a-conspiracy-theory/jhnvrw-seniordesign/README.md

UCF 2026 Senior Design Project

RF Energy Harvesting Ultra-Low-power Transceiver for Environmental Sensing
