a-conspiracy-theory/jhnvrw-seniordesign/hardware/tx-pcb/reference-designs/swrr077/readme.txt

XXXXXXXXXXXXXXXXXXXXXXXXXXXXXXXXXXXXXXXXXXXXXXXXXXXXXXXXXXXXXXXXXXXXXXXXXXXXXXXXX
X   Artwork and documentation done by: Texas Instruments Norway AS              X
X   Company: Texas Instruments Norway AS                                        X
X   Address: Gaustadalléen 21    0349 OSLO                                      X
X                                                                               X
X                                                                               X
XXXXXXXXXXXXXXXXXXXXXXXXXXXXXXXXXXXXXXXXXXXXXXXXXXXXXXXXXXXXXXXXXXXXXXXXXXXXXXXXX

PROJECT : 025103
PCB NAME : CC1101-CC1190EM 915MHz
REVISION: 1.2.0
DATE: 2011-03-10
QUANTITY:   See order (in panel)

Manufacturers marking: Two letter + year + week
The two letter code shall identify the manufaturer and is decided by the manufacturer. 
No logos or other identifiers are allowed.
The marking shall be in silk screen print at secondary side of the PCB, or in solder 
resist if no silk print at secondary side.

FILE: CC1101-CC1190EM_915MHz_1_2_0.ZIP PACKED WITH WinZIP 

PCB DESCRIPTION:4 LAYER PCB 1.6 MM
      Copper        1   35 um
      Dielectric  1-2   0.25 mm  
      Copper        2   18 um
      Dielectric  2-3   0.96 mm 
      Copper        3   18 um
      Dielectric  3-4   0.25 mm 
      Copper        4   35 um
  DE104iML or equivalent substrate (Resin contents around 45%, which gives Er=4.42@2.4GHz, TanD=0.016)
  Dimensions in mil (0.001 inch)
  DOUBLE SIDE SOLDER MASK,
  DOUBLE SIDE SILKSCREEN,
  8 MIL MIN TRACE WIDTH AND 6 MIL MIN ISOLATION.

FILE NAME            		DESCRIPTION                               	FILE TYPE
-------------------------------------------------------------------------------------------
***PCB MANUFACTURING FILES:
l1.SPL                  LAYER 1 COMPONENT SIDE/POSITIV            		EXT. GERBER
l2.SPL                  LAYER 2 Inner layer/POSITIV                 	EXT. GERBER
l3.SPL                  LAYER 3 Inner layer/POSITIV                 	EXT. GERBER
l4.SPL                  LAYER 4 SOLDER SIDE/POSITIV                 	EXT. GERBER

STOPCOMP.SPL           SOLDER MASK COMPONENT SIDE/NEGATIVE         		EXT. GERBER
STOPSOLD.SPL            SOLDER MASK SOLDER SIDE/NEGATIVE            	EXT. GERBER

SILKCOMP.SPL            SILKSCREEN COMPONENT SIDE/POSITIVE          	EXT. GERBER
SILKSOLD.SPL             SILKSCREEN SOLDER SIDE/POSITIVE             	EXT. GERBER

PASTCOMP.SPL            SOLDER PAST COMPONENT SIDE/POSITIVE        		EXT. GERBER
PATSOLD.SPL              SOLDER PAST SOLDER SIDE/POSITIVE            	EXT. GERBER

ASSYCOMP.SPL            ASSEMBLY DRAWING COMPONENT SIDE/NEGATIVE    	EXT. GERBER
ASSYSOLD.SPL             ASSEMBLY DRAWING SOLDER SIDE/NEGATIVE       	EXT. GERBER

NCDRILL.SPL             NC DRILL THROUGH HOLE                       	EXCELLON
DRILL.SPL                DRILL/MECHANICAL DRAWING                    	EXT. GERBER

GERBER.REP              DRILL/NC DRILL REPORT                       	ASCII

P&PCOMP.REP             PICK AND PLACE FILE COMPONENT SIDE          	ASCII
P&PSOLD.REP             PICK AND PLACE FILE SOLDER SIDE             	ASCII

EXT_GERBER.USR          EXTENDED GERBER APERTURE TABLE              	ASCII
CNC.USR                        NC DRILL DEVICE FILE                   ASCII

CC1101_CC1190EM_915MHz_PARTLIST_1_2_0.xls			Partlist

***PDF FILES:
CC1101_CC1190EM_915MHz_SCHEMATIC_1_2_0.PDF			Circuit Diagram
CC1101_CC1190EM_915MHz_LAYOUT_1_2_0.PDF					Layout Diagram

***CADSTAR FILES:
CC1101_CC1190EM_915MHz_1_2_0.SCM				Cadstar Schematic file
CC1101_CC1190EM_915MHz_1_2_0.CSA				Cadstar Shematic archive
CC1101_CC1190EM_915MHz_1_2_0.PCB				Cadstar layout file
CC1101_CC1190EM_915MHz_1_2_0.CPA				Cadstar PCB archive

README.TXT              THIS FILE                                   		ASCII

***REVISION HISTORY
1.2.0	First official release

END.
