a-conspiracy-theory/jhnvrw-seniordesign/hardware/rx-pcb/bluetooth_test/hardware-requirements.txt

MCU
	Bluetooth
		SMPS
		HSE
		LSE
		Antenna
	
	Harvesting Antenna
