a-conspiracy-theory/jhnvrw-seniordesign/diagrams/SD hardware block diagram RX.png

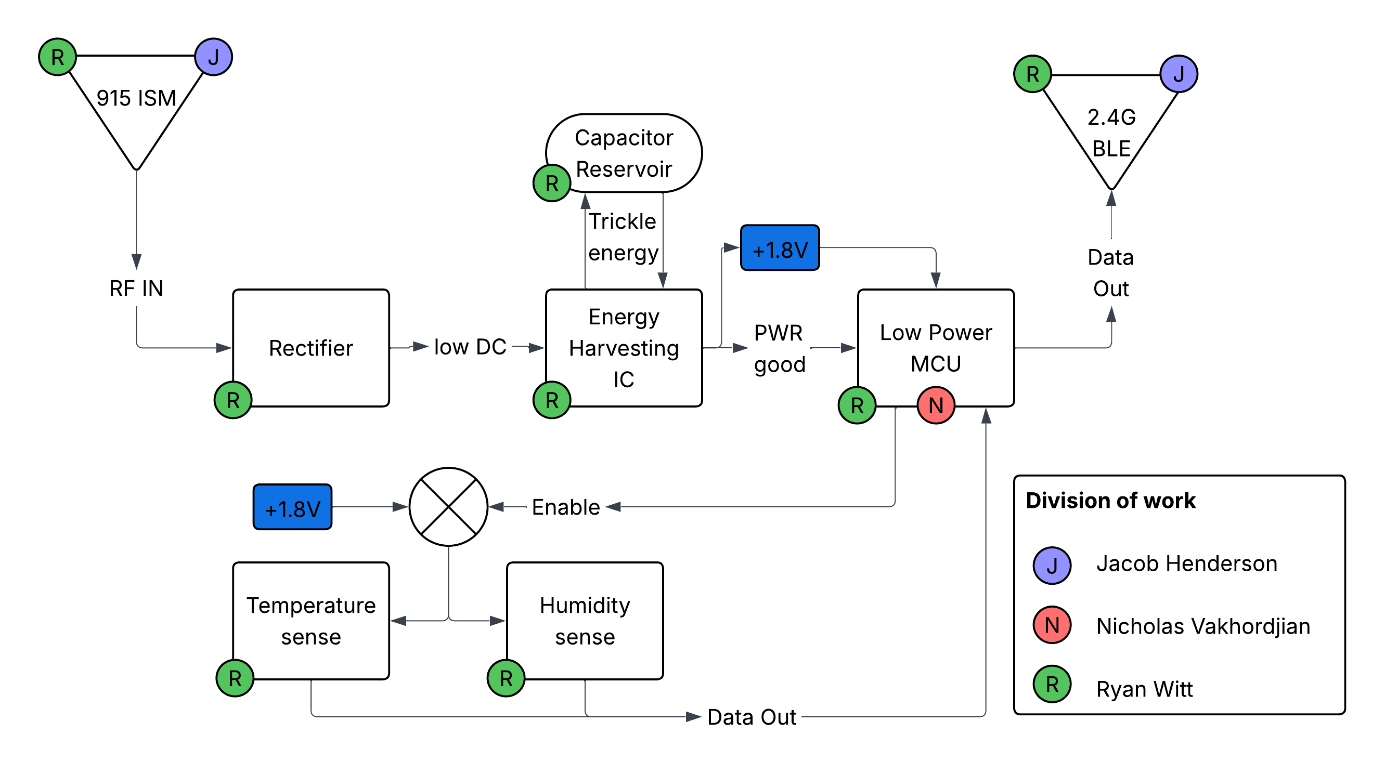
diagrams/SD hardware block diagram RX.png
