a-conspiracy-theory/jhnvrw-seniordesign/diagrams/SD hardware block diagram TX.jpeg

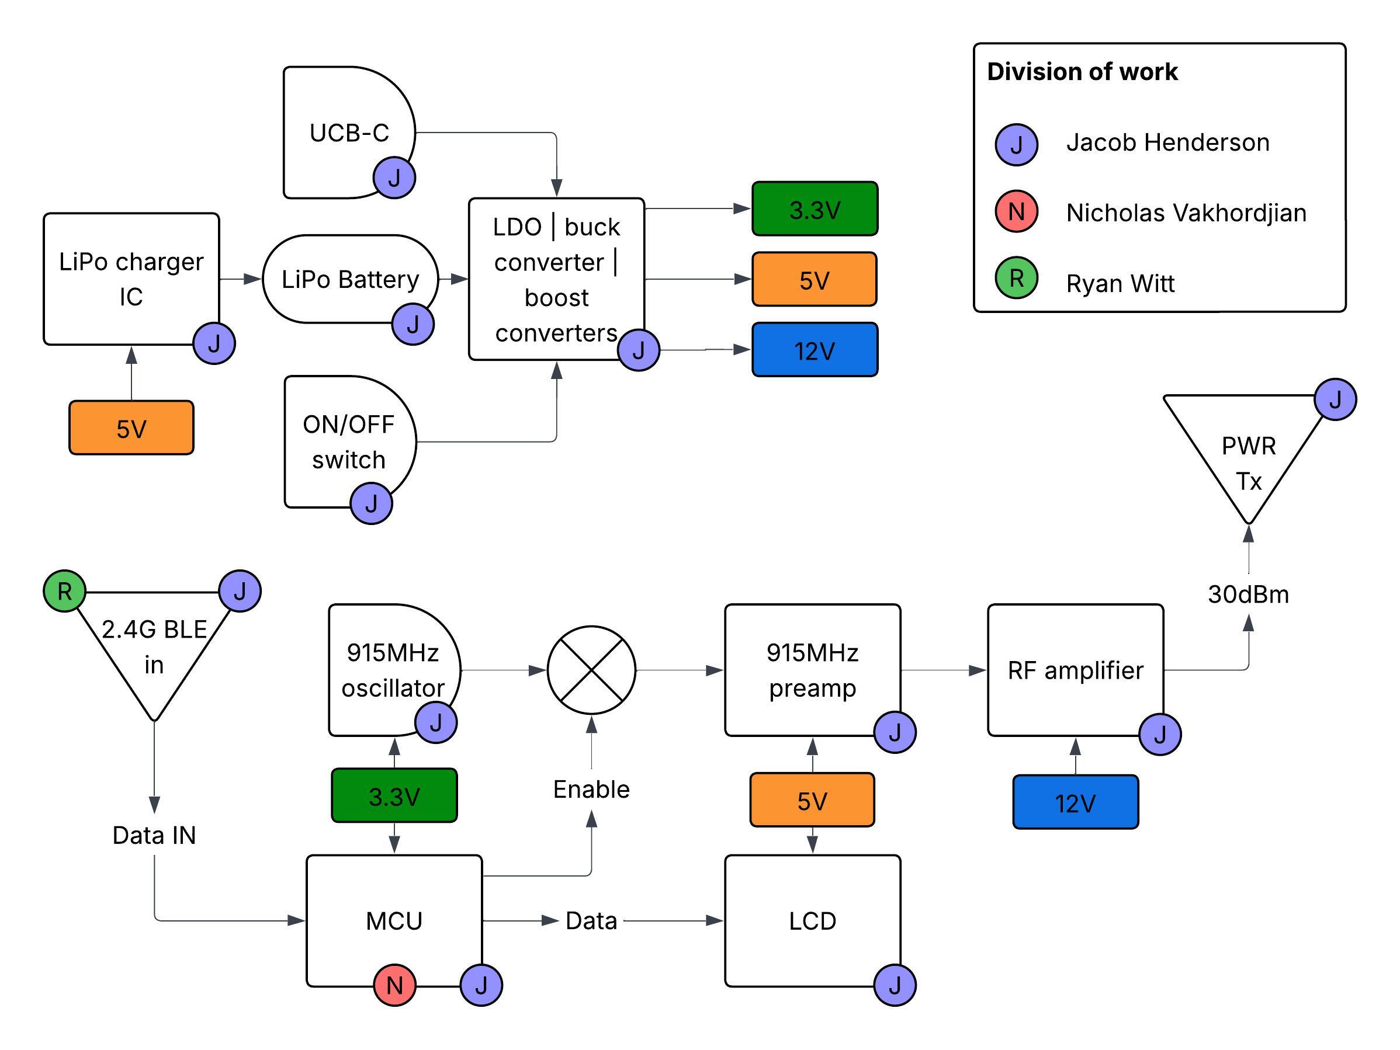
diagrams/SD hardware block diagram TX.jpeg
