a-conspiracy-theory/jhnvrw-seniordesign/diagrams/SD hardware block diagram TX.png

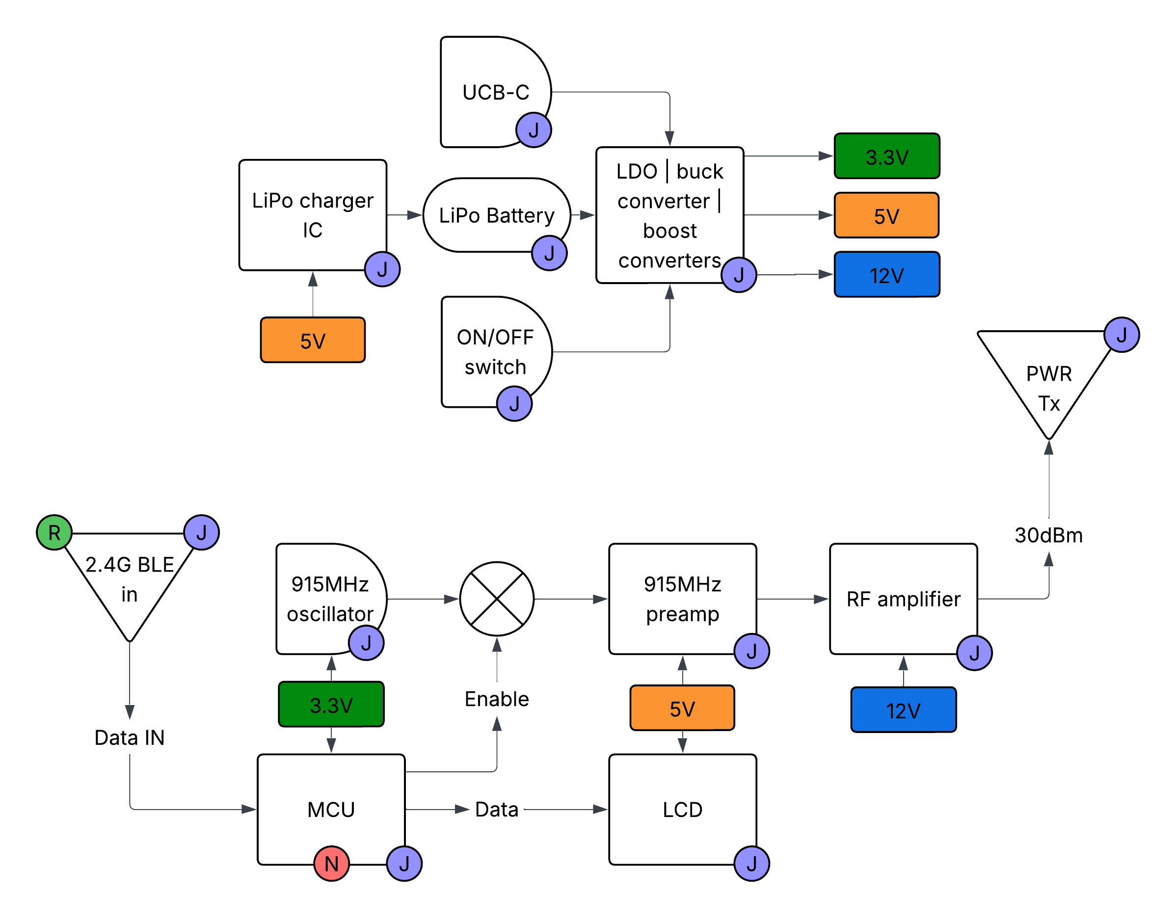
diagrams/SD hardware block diagram TX.png
