a-conspiracy-theory/jhnvrw-seniordesign/Report/150msOnInterval_1.PNG

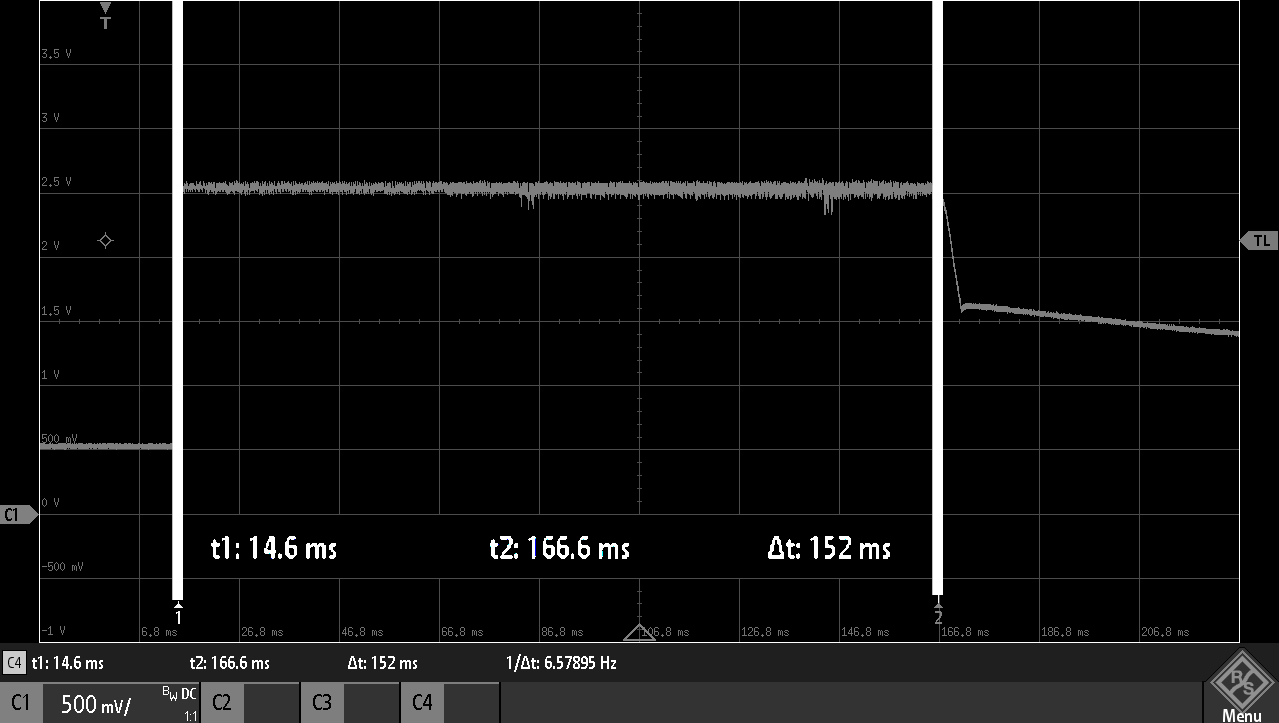
Report/150msOnInterval_1.PNG
