a-conspiracy-theory/jhnvrw-seniordesign/Report/sx1262_spec_analyzer.png

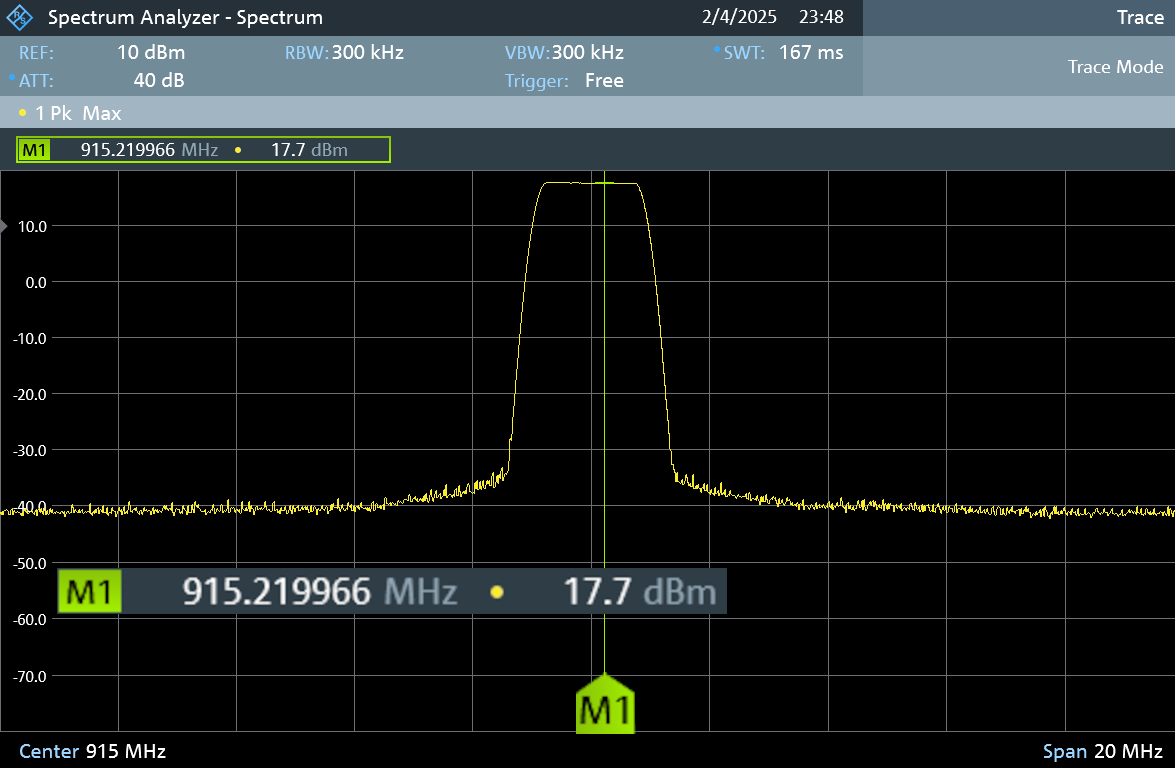
Report/sx1262_spec_analyzer.png
