a-conspiracy-theory/jhnvrw-seniordesign/hardware/tx-pcb/reference-designs/cn0522-DesignSupport/cn0522-DesignSupport/CN0522 BOM.csv

TITLE: Bill of Materials
BOM NO: 05-058924-01-a.csv
DATE: 09/10/2020
DESIGN: 02_058924a_top
TEMPLATE: Z:\allegro\v172_site\cdssetup\template.bom
CALLOUT:
ITEM# | Qty | WW_PN | DESCRIPTION | VALUE | JEDEC_TYPE | TOL | VOLTAGE | WATTAGE | LOCATION | MFG | MFG_PN | HLM_STATUS | STOCKROOM_WL | STOCKROOM_GT | STOCKROOM_LK | STOCKROOM_GBO | STOCKROOM_NSH | CUSTOM_PART | DNI
1 | 1 | 08_058924b | PCB | ? | ? | ? | ? | ? | ? | Analog Devices Supplied | 08_058924b | N/A | ? | ? | ? | ? | ? | ? | ?
2 | 2 | E023045 | CAP CER C0G(NP0), GENERAL PURPOSE | 100pF | C0201 | 5 | 50V | N/A | C1,C13 | MURATA | GRM0335C1H101JA01D | REL | N/A | N/A | N/A | N/A | N/A | ? | ?
3 | 3 | E007203 | CAP CER CHIP X8R | 0.01UF | C0402 | 10 | 25V | N/A | C3,C7,C10 | TDK | C1005X8R1E103K | REL | A004-0011-086 | 40302JH399 | N/A | N/A | 7001959 | ? | ?
4 | 3 | E007143 | CAP CER X5R, GENERAL PURPOSE | 10uF | C0603 | 20 | 6.3V | N/A | C2,C6,C11 | MURATA | GRM188R60J106ME47D | REL | N/A | 40302JH499 | N/A | 1244_BIN1-2A | N/A | ? | ?
5 | 1 | E026830 | CAP CER C0G | 8PF | C0402 | 0.5PF | 16V | N/A | C12 | AVX CORPORATION | 0402YA8R0DAT2A | REL | N/A | N/A | N/A | N/A | 7008704 | ? | ?
6 | 1 | E011567 | CAP CER X5R, GENERAL PURPOSE | 0.1uF | C0201 | 10 | 6.3V | N/A | C14 | MURATA | GRM033R60J104KE19D | REL | N/A | 40302JH901 | N/A | 1646_CAB3 | N/A | ? | ?
7 | 1 | E028092 | CAP MULTILAYER CER CHIP X6S | 47UF | C1206H71 | 20 | 10V | N/A | C15 | TDK | C3216X6S1A476M160AC | REL | N/A | N/A | N/A | N/A | N/A | ? | ?
8 | 3 | E033336 | CAP CER X7R, AUTOMOTIVE GRADE | 0.1UF | C0805H53 | 10 | 50V | N/A | C16,C17,C18 | AVX CORPORATION | 08055C104K4T4A | REL | N/A | N/A | N/A | N/A | N/A | ? | ?
9 | 1 | E025752 | CAP MULTILAYER CER CHIP, X7R | 4.7UF | C0805H53 | 10 | 25V | N/A | C19 | TDK | C2012X7R1E475K125AB | REL | N/A | N/A | N/A | N/A | N/A | ? | ?
10 | 3 | E033832 | CAP CER 1UF 25V 10% X7R 0603, AUTOMOTIVE | 1UF | C0603 | 10 | 25V | N/A | C20,C21,C23 | MURATA | GCM188R71E105KA64D | REL | N/A | N/A | N/A | N/A | N/A | ? | ?
11 | 1 | E016591 | CAP CER X5R, GENERAL PURPOSE | 100uF | C1206H71 | 20 | 6.3V | N/A | C22 | MURATA | GRM31CR60J107ME39L | REL | N/A | N/A | N/A | N/A | 7002429 | ? | ?
12 | 3 | E024302 | CAP MONO CER CHIP FOR AUTOMOTIVE, C0G | 100pF | C0402 | 5 | 50V | N/A | C4,C8,C9 | MURATA | GCM1555C1H101JA16D | REL | N/A | N/A | N/A | N/A | 7000684 | ? | ?
13 | 1 | E022849 | CAP CER C0G(NP0), GENERAL PURPOSE | 10pF | C0201 | 5 | 25V | N/A | C5 | MURATA | GRM0335C1E100JA01D | REL | N/A | N/A | N/A | N/A | N/A | ? | ?
14 | 1 | E001108 | DIODE SURFACE MOUNT TRAN VOLT SUP | SMAJ5.0A-13-F | DIOSMJ5_0 | N/A | 5V | N/A | D1 | DIODE INCORP | SMAJ5.0A-13-F | REL | N/A | N/A | N/A | N/A | N/A | ? | ?
15 | 1 | E037111 | LED RED DIFFUSED AIGAINP, 620NM | SML-D12U1WT86 | LED0603_A | N/A | 2.2V | N/A | DS1 | ROHM | SML-D12U1WT86 | REL | N/A | N/A | N/A | N/A | N/A | ? | ?
16 | 1 | E033001 | LED GREEN 574NM 35MCS, WATER CLEAR LENS | LTST-C191KGKT | LED0603_A | N/A | 2V | 3/40W | DS2 | LITE-ON TECHNOLOGY | LTST-C191KGKT | REL | N/A | N/A | N/A | N/A | 7003950 | ? | ?
17 | 1 | E028908 | IND FERRITE BEAD, 0.150OHM MAX DCR, 1A | 600OHM AT 100MEGHZ | L0603 | 25 | N/A | N/A | E1 | TDK | MPZ1608S601ATA00 | REL | N/A | N/A | N/A | N/A | N/A | ? | ?
18 | 1 | E029797 | FLTR SAW 3.3DB 50OHM | 915MEGHZ | DCC6C | N/A | N/A | N/A | FL1 | TDK | B39921B3588U410 | REL | N/A | N/A | N/A | N/A | N/A | ? | ?
19 | 1 | E033180 | CONN-PCB RCPT PLUG SMA END LAUNCH, 50OHM/18GHZ, ALT SYMBOL FOR COMBO FOOTPRINT WITH EG-413227-0074 | 132365-10 | CNSMARAL686W375H177 | N/A | N/A | N/A | J1 | AMPHENOL | 132365-10 | REL | N/A | N/A | N/A | N/A | N/A | ? | ?
20 | 1 | E028678 | CONN-PCB EDGE SMA SMALL VERSION, 50OHM IMPEDANCE, 18GHZ MAX FREQUENCY | CON-SMA-EDGE-S | CNSMARAL525W250H148 | N/A | N/A | N/A | J2 | RF SOLUTIONS | CON-SMA-EDGE-S | REL | N/A | N/A | N/A | N/A | N/A | ? | ?
21 | 1 | E012518 | IND CHIP 0402 | 18nH | L0402-2 | 5 | N/A | N/A | L1 | COILCRAFT | 0402HP-18NXJLU | REL | N/A | N/A | N/A | N/A | 7004953 | ? | ?
22 | 1 | E006384 | IND CHIP | 1.6nH | L7144 | 5 | N/A | N/A | L2 | COILCRAFT | 0603CS-1N6XJLW | REL | ADD_TO_STOCK17 | 40915JH044 | N/A | N/A | 7004796 | ? | ?
23 | 1 | E027130 | INDUCTOR WIREWOUND COMMON MODE CHOKE COIL FOR POWER LINES, 0.056OHM DCR, 2A | 800OHMS AT 100MEGHZ | L2020_A | N/A | N/A | N/A | L3 | MURATA | DLW5BSM801TQ2L | REL | N/A | N/A | N/A | N/A | N/A | ? | ?
24 | 1 | E010399 | IND CHIP COIL | 1uH | L0805 | 20 | N/A | N/A | L4 | MURATA MANUFACTURING | LQM21PN1R0MC0D | REL | N/A | N/A | N/A | N/A | 7004971 | ? | ?
25 | 1 | E015753 | CONN-PCB RCPT MICRO USB AB | 47590-0001 | CNMOLEX47590-0001 | N/A | N/A | N/A | P1 | MOLEX | 47590-0001 | REL | N/A | N/A | N/A | N/A | 6001617 | ? | ?
26 | 1 | E003678 | RES PRECISION THICK FILM CHIP R0603 | 1K | R0603 | 1 | N/A | 1/10W | R1 | PANASONIC | ERJ-3EKF1001V | REL | A003-0032-013 | 41816DG207 | FEC 911-239 | N/A | 7001194 | ? | ?
27 | 1 | E006826 | RES FILM SMD 0603 | 0 | R0603 | 5 | N/A | 1/10W | R2 | PANASONIC | ERJ-3GEY0R00V | REL | A003-0038-001 | N/A | N/A | N/A | 7008623 | ? | ?
28 | 1 | E028356 | RES PRECISION THICK FILM CHIP, FOR AUTOMOTIVE | 365 | R0402 | 1 | N/A | 1/10W | R3 | PANASONIC | ERJ-2RKF3650X | REL | N/A | N/A | N/A | N/A | N/A | ? | ?
29 | 1 | E023448 | RES THICK FILM CHIP | 1K | R0805 | 1 | 150V | 1/3W | R4 | VISHAY | CRCW08051K00FKEAHP | REL | N/A | N/A | N/A | N/A | N/A | ? | ?
30 | 1 | E025179 | RES PRECISION THICK FILM CHIP | 115K | R0402 | 1 | N/A | 1/10W | R5 | PANASONIC | ERJ-2RKF1153X | REL | N/A | N/A | N/A | N/A | N/A | ? | ?
31 | 1 | E022436 | RES PRECISION THICK FILM CHIP | 60.4K | R0402 | 1 | N/A | 1/10W | R6 | PANASONIC | ERJ-2RKF6042X | REL | N/A | N/A | N/A | N/A | N/A | ? | ?
32 | 1 | E025180 | RES PRECISION THICK FILM CHIP | 182K | R0402 | 1 | N/A | 1/10W | R7 | PANASONIC | ERJ-2RKF1823X | REL | N/A | N/A | N/A | N/A | N/A | ? | ?
33 | 1 | E011195 | RES PRECISION THICK FILM CHIP | 301 | R0402 | 1 | N/A | 1/16W | R8 | PANASONIC | ERJ-2RKF3010X | REL | N/A | N/A | N/A | 1576_CAB3 | 7007221 | ? | ?
34 | 1 | E026150 | IC-ADI 700MEGHZ TO 1KMEGHZ 1 W RF DRIVER AMPLIFIER | ADL5605ACPZ | QFN16_4X4_PAD2_36X2_36 | N/A | N/A | ? | U1 | ANALOG DEVICES | ADL5605ACPZ-R7 | REL | N/A | N/A | N/A | N/A | N/A | ? | ?
35 | 1 | E035980 | IC-ADI PIN-SELECTABLE TEMPERATURE SWITCHES | ADT6402SRJZ | TSOT23_6 | N/A | N/A | ? | U2 | ANALOG DEVICES | ADT6402SRJZ-RL7 | REL | N/A | N/A | N/A | N/A | N/A | ? | ?
36 | 1 | E037112 | IC-TTL SINGLE BUFFER GATE WITH 3-STATE OUTPUT | 74AHCT1G126SE-7 | SOT353 | N/A | N/A | ? | U3 | DIODES INCORPORATED | 74AHCT1G126SE-7 | REL | N/A | N/A | N/A | N/A | 1001522 | ? | ?
37 | 1 | E028897 | IC-LIN INVERTING OR SEPIC UMODULE DC/DC CONVERTER WITH UP TO 700MA OUTPUT CURRENT | LTM8045MPY#PBF | BGA40 | N/A | N/A | ? | U4 | LINEAR TECHNOLOGY | LTM8045MPY#PBF | REL | N/A | N/A | N/A | N/A | N/A | ? | ?
The following components are part of the PCB or are NOT to be installed
ITEM# | Qty | WW_PN | DESCRIPTION | VALUE | JEDEC_TYPE | TOL | VOLTAGE | WATTAGE | LOCATION | MFG | MFG_PN | HLM_STATUS | STOCKROOM_WL | STOCKROOM_GT | STOCKROOM_LK | STOCKROOM_GBO | STOCKROOM_NSH | CUSTOM_PART | DNI
