a-conspiracy-theory/jhnvrw-seniordesign/Report/testingresults/rectifier_dBmIN-vs-mVO.xlsx

pwr_in (dBm) | Vo, loaded | Vo, unloaded
-30 | 8 | 12 | 18.06179974 | 21.58362492
-27 | 17 | 22 | 24.60897843 | 26.84845362
-24 | 30 | 42 | 29.54242509 | 32.46498581
-21 | 61 | 71 | 35.7065967 | 37.02516697
-18 | 125 | 123 | 41.93820026 | 41.79810223
-15 | 175 | 205 | 44.86076097 | 46.23507722
-12 | 230 | 300 | 47.23455672 | 49.54242509
-9 | 330 | 500 | 50.3702788 | 53.97940009
-6 | 420 | 710 | 52.46498581 | 57.02516697
-3 | n/a | 1150 |  | 61.21395681
0 | n/a | 1590 |  | 64.02794249
