a-conspiracy-theory/jhnvrw-seniordesign/hardware/rx-pcb/bluetooth_test/rx-pcb.pdf

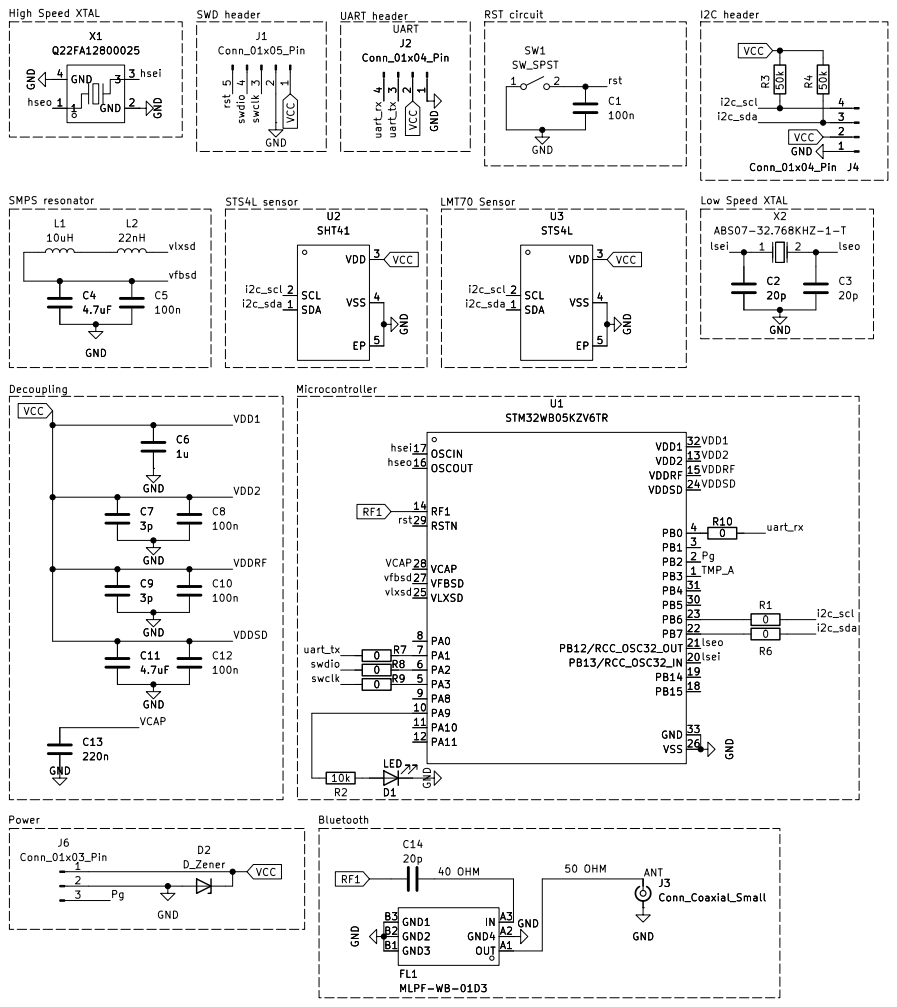
[picture p30: page 1]

FL1 MLPF-WB-01D3OUT A1 GND4 A2 IN A3 GND3 B1 GND2 B2 GND1 B3 GND U2
