a-conspiracy-theory/jhnvrw-seniordesign/hardware/rx-pcb/power_harvester/power_harvester.pdf

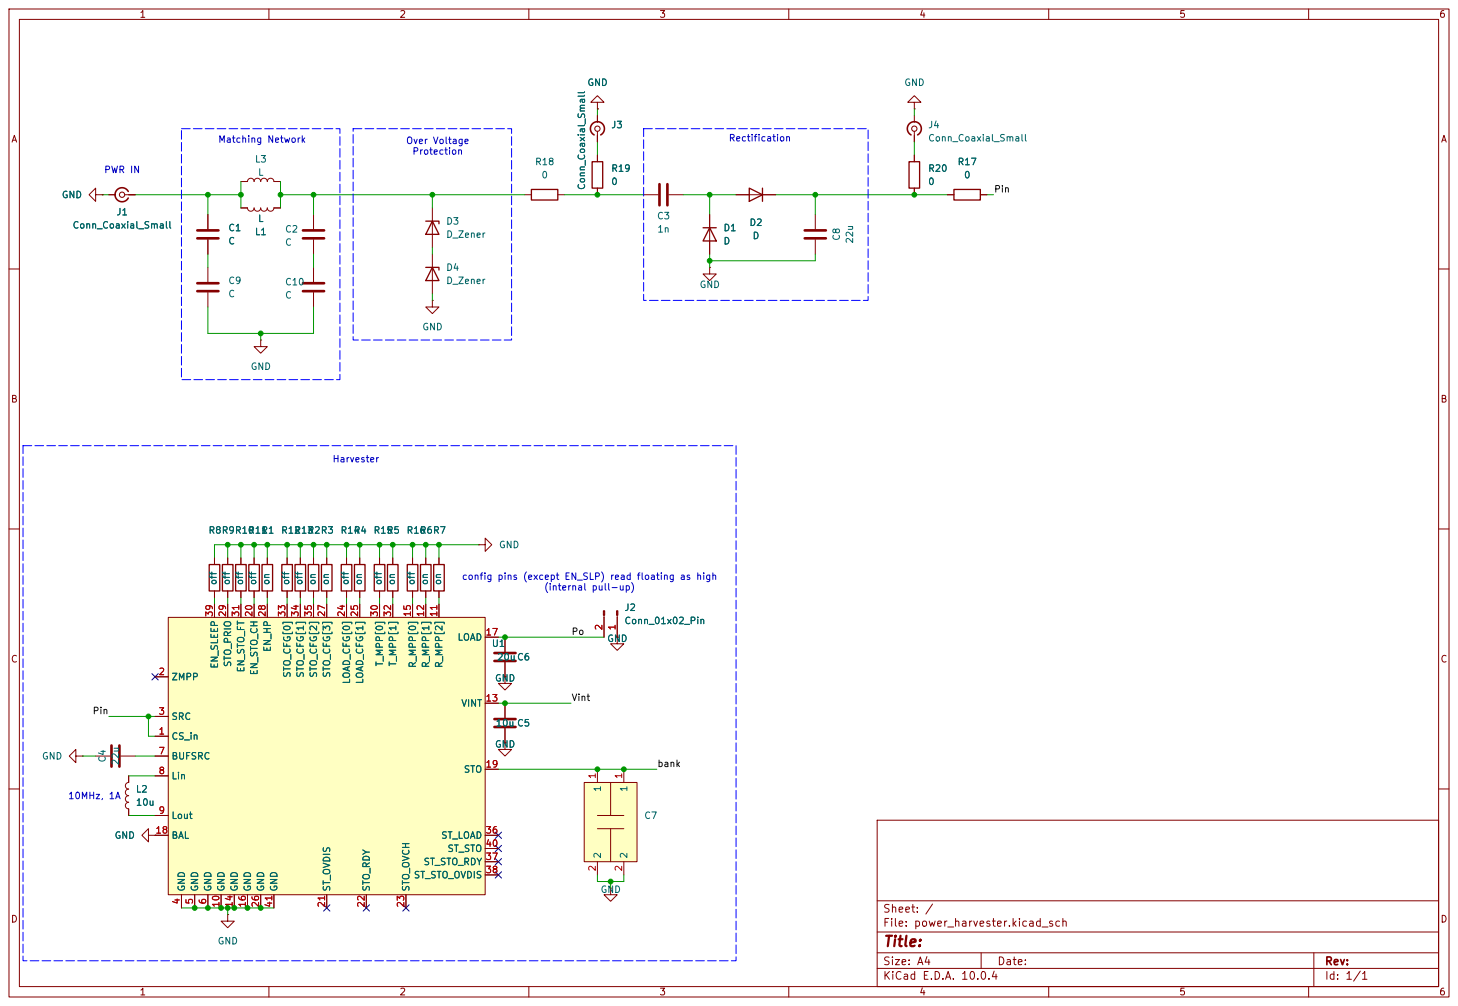
[picture p31: page 1]

config pins (except EN_SLP) read floating as high

Size: A4 | Rev:
KiCad E.D.A. 10.0.4 | Id: 1/1
