a-conspiracy-theory/jhnvrw-seniordesign/hardware/tx-pcb/reference-designs/cn0522-DesignSupport/cn0522-DesignSupport/Gerber Files/09-058924-01-b.pdf

D

1

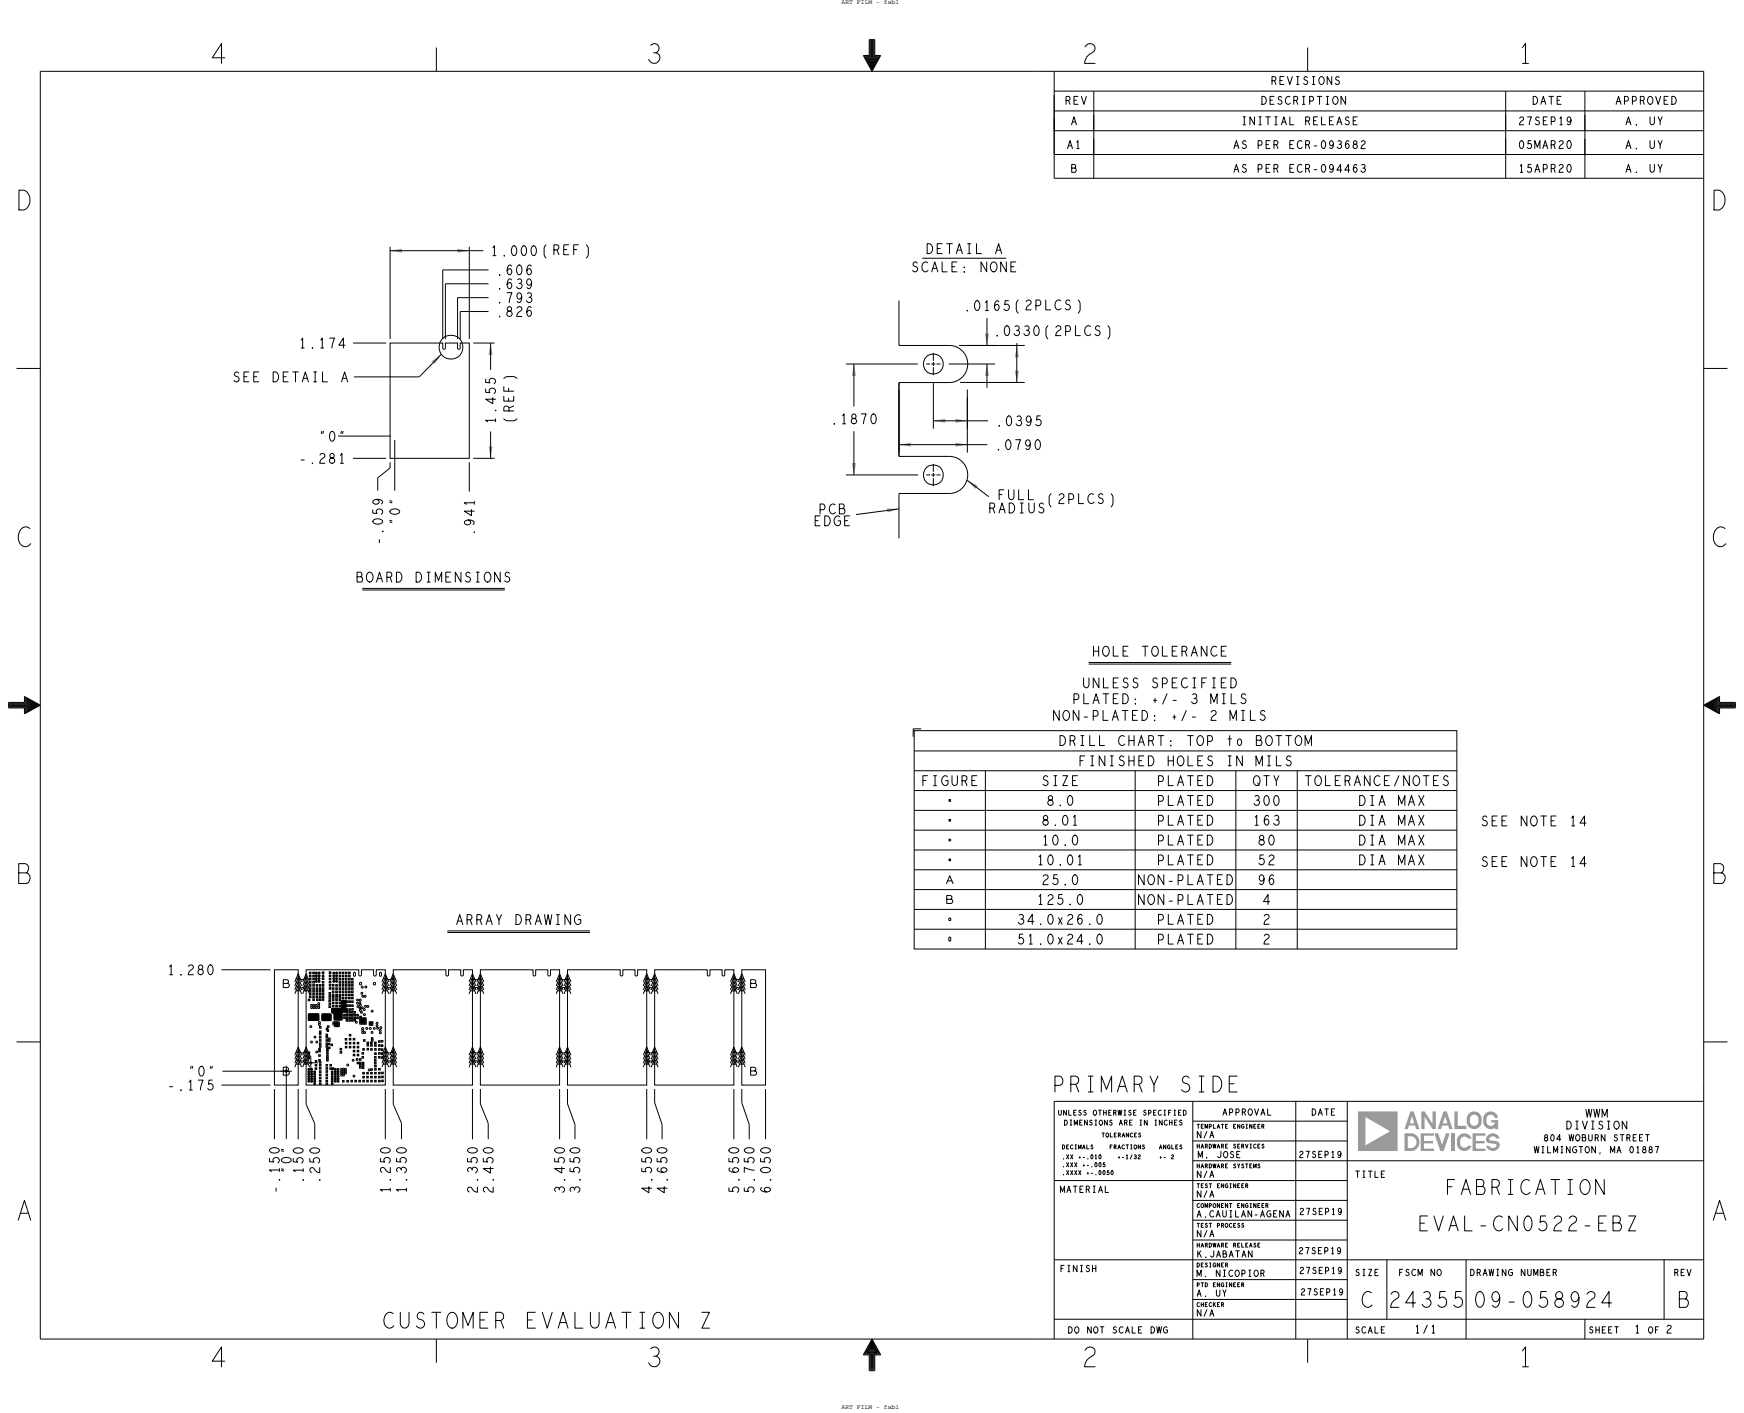
[picture p32: page 1]
ART FILM - fab1; WWM DIVISION 804 WOBURN STREET WILMINGTON, MA 01887; SEE NOTE 14; DIA MAX; TITLE; TOLERANCE/NOTES; QTY; K.JABATAN; PLATED; FINISHED; HOLES IN MILS; DIMENSIONS ARE; IN INCHES; PRIMARY SIDE; FINISH; (2PLCS); FULL RADIUS; DETAIL A; FIGURE; SCALE: NONE; PCB EDGE; (REF); ARRAY DRAWING; CUSTOMER EVALUATION Z; BOARD DIMENSIONS; SEE DETAIL A

REVISIONS

REV | DESCRIPTION | DATE | | APPROVED
A | INITIAL RELEASE | | 27SEP19 | A. UY
A1 | AS PER ECR-093682 | | 05MAR20 | A. UY
B | AS PER ECR-094463 | | 15APR20 | A. UY

HOLE TOLERANCE
UNLESS SPECIFIED
PLATED: +/- 3 MILS
NON-PLATED: +/- 2 MILS
DRILL CHART: TOP to BOTTOM
SIZE

8.0 | PLATED | 300 | DIA MAX
8.01 | PLATED | 163
10.0 | PLATED | 80 | DIA MAX
10.01 | PLATED | 52
25.0 | NON-PLATED | 96
125.0 | NON-PLATED | 4
34.0x26.0 | PLATED | 2

UNLESS OTHERWISE SPECIFIED DECIMALS .XX +-.010 .XXX +-.005 .XXXX +-.0050 | TOLERANCES FRACTIONS +-1/32 | | | ANGLES +- | 2 | APPROVAL | DATE

TEMPLATE ENGINEER N/A
HARDWARE SERVICES M. JOSE | 27SEP19
HARDWARE SYSTEMS N/A | | | FABRICATION EVAL-CN0522-EBZ

MATERIAL | | TEST ENGINEER N/A

COMPONENT ENGINEER A.CAUILAN-AGENA | 27SEP19

TEST PROCESS N/A
HARDWARE RELEASE | 27SEP19
DESIGNER M. NICOPIOR | 27SEP19 | SIZE C | | FSCM NO 24355 | DRAWING NUMBER 09 | -058924 | REV B
PTD ENGINEER A. UY | 27SEP19

CHECKER N/A

DO NOT SCALE DWG | | | 1/1 SCALE | | SHEET

D

1

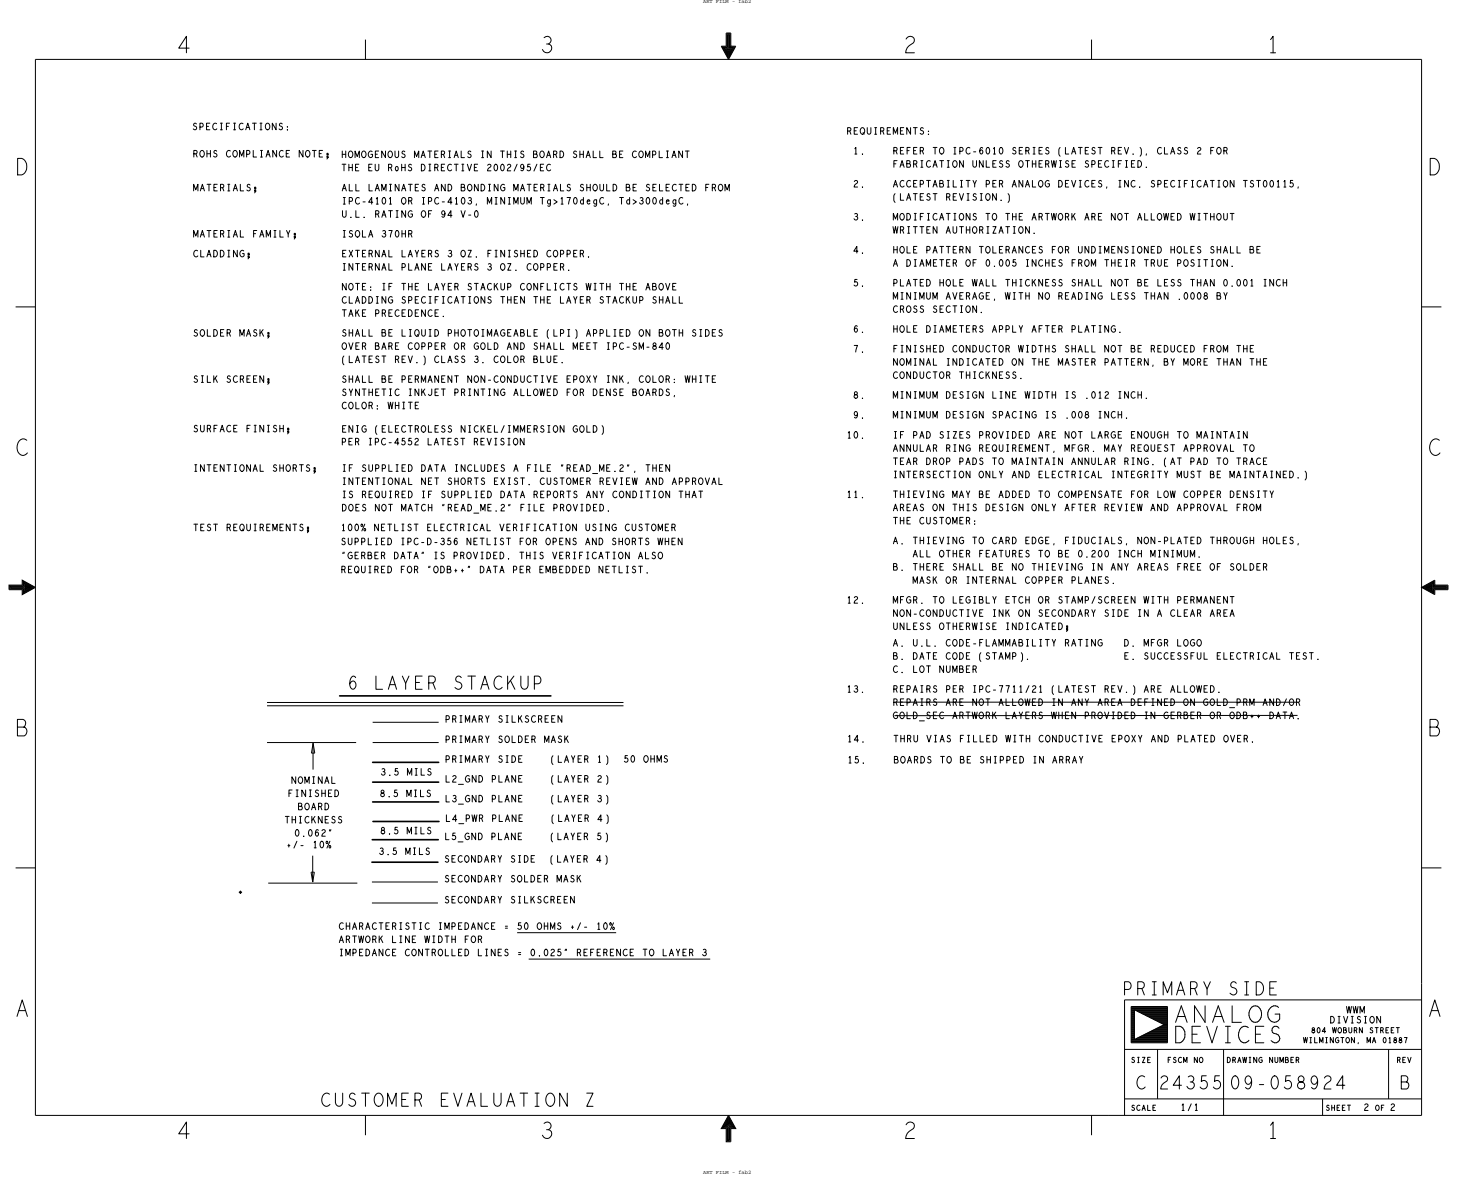
[picture p33: page 2]
ART FILM - fab2; REV B; WWM DIVISION; SHEET; 804 WOBURN STREET WILMINGTON, MA 01887; DRAWING NUMBER 09-058924; FSCM NO 24355; SIZE C; SCALE; PRIMARY SIDE; ACCEPTABILITY PER ANALOG DEVICES,; INC. SPECIFICATION; TST00115,; (LATEST REVISION.); MODIFICATIONS; THE ARTWORK ARE NOT ALLOWED WITHOUT; WRITTEN AUTHORIZATION.; HOLE PATTERN TOLERANCES FOR UNDIMENSIONED; HOLES SHALL BE; A DIAMETER OF 0.005; INCHES FROM; THEIR; TRUE POSITION.; PLATED; HOLE WALL; THICKNESS SHALL NOT BE LESS; THAN 0.001; INCH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

REQUIREMENTS:
1. REFER TO IPC-6010 SERIES (LATEST REV.), CLASS 2 FOR

ROHS COMPLIANCE NOTE;

THE EU RoHS DIRECTIVE 2002/95/EC
ALL LAMINATES AND BONDING MATERIALS SHOULD BE SELECTED FROM
U.L. RATING OF 94 V-0
ISOLA 370HR
EXTERNAL LAYERS 3 OZ. FINISHED COPPER.
INTERNAL PLANE LAYERS 3 OZ. COPPER.
TAKE PRECEDENCE.
SHALL BE LIQUID PHOTOIMAGEABLE (LPI) APPLIED ON BOTH SIDES
(LATEST REV.) CLASS 3. COLOR BLUE.
SYNTHETIC INKJET PRINTING ALLOWED FOR DENSE BOARDS,
COLOR: WHITE

FABRICATION UNLESS OTHERWISE SPECIFIED.

6. HOLE DIAMETERS APPLY AFTER PLATING.

ENIG (ELECTROLESS NICKEL/IMMERSION GOLD)
PER IPC-4552 LATEST REVISION

INTENTIONAL NET SHORTS EXIST. CUSTOMER REVIEW AND APPROVAL
DOES NOT MATCH "READ_ME.2" FILE PROVIDED.
100% NETLIST ELECTRICAL VERIFICATION USING CUSTOMER
SUPPLIED IPC-D-356 NETLIST FOR OPENS AND SHORTS WHEN
REQUIRED FOR "ODB++" DATA PER EMBEDDED NETLIST.

AREAS ON THIS DESIGN ONLY AFTER REVIEW AND APPROVAL FROM
THE CUSTOMER:

12. MFGR. TO LEGIBLY ETCH OR STAMP/SCREEN WITH PERMANENT

PRIMARY SILKSCREEN
PRIMARY SOLDER MASK

14. THRU VIAS FILLED WITH CONDUCTIVE EPOXY AND PLATED OVER.

SECONDARY SIDE (LAYER 4)
SECONDARY SOLDER MASK

CHARACTERISTIC IMPEDANCE = 50 OHMS +/- 10%
ARTWORK LINE WIDTH FOR
