a-conspiracy-theory/jhnvrw-seniordesign/hardware/tx-pcb/reference-designs/cn0522-DesignSupport/cn0522-DesignSupport/Assembly Files/assy/01-058924-01-b.pdf

D

1

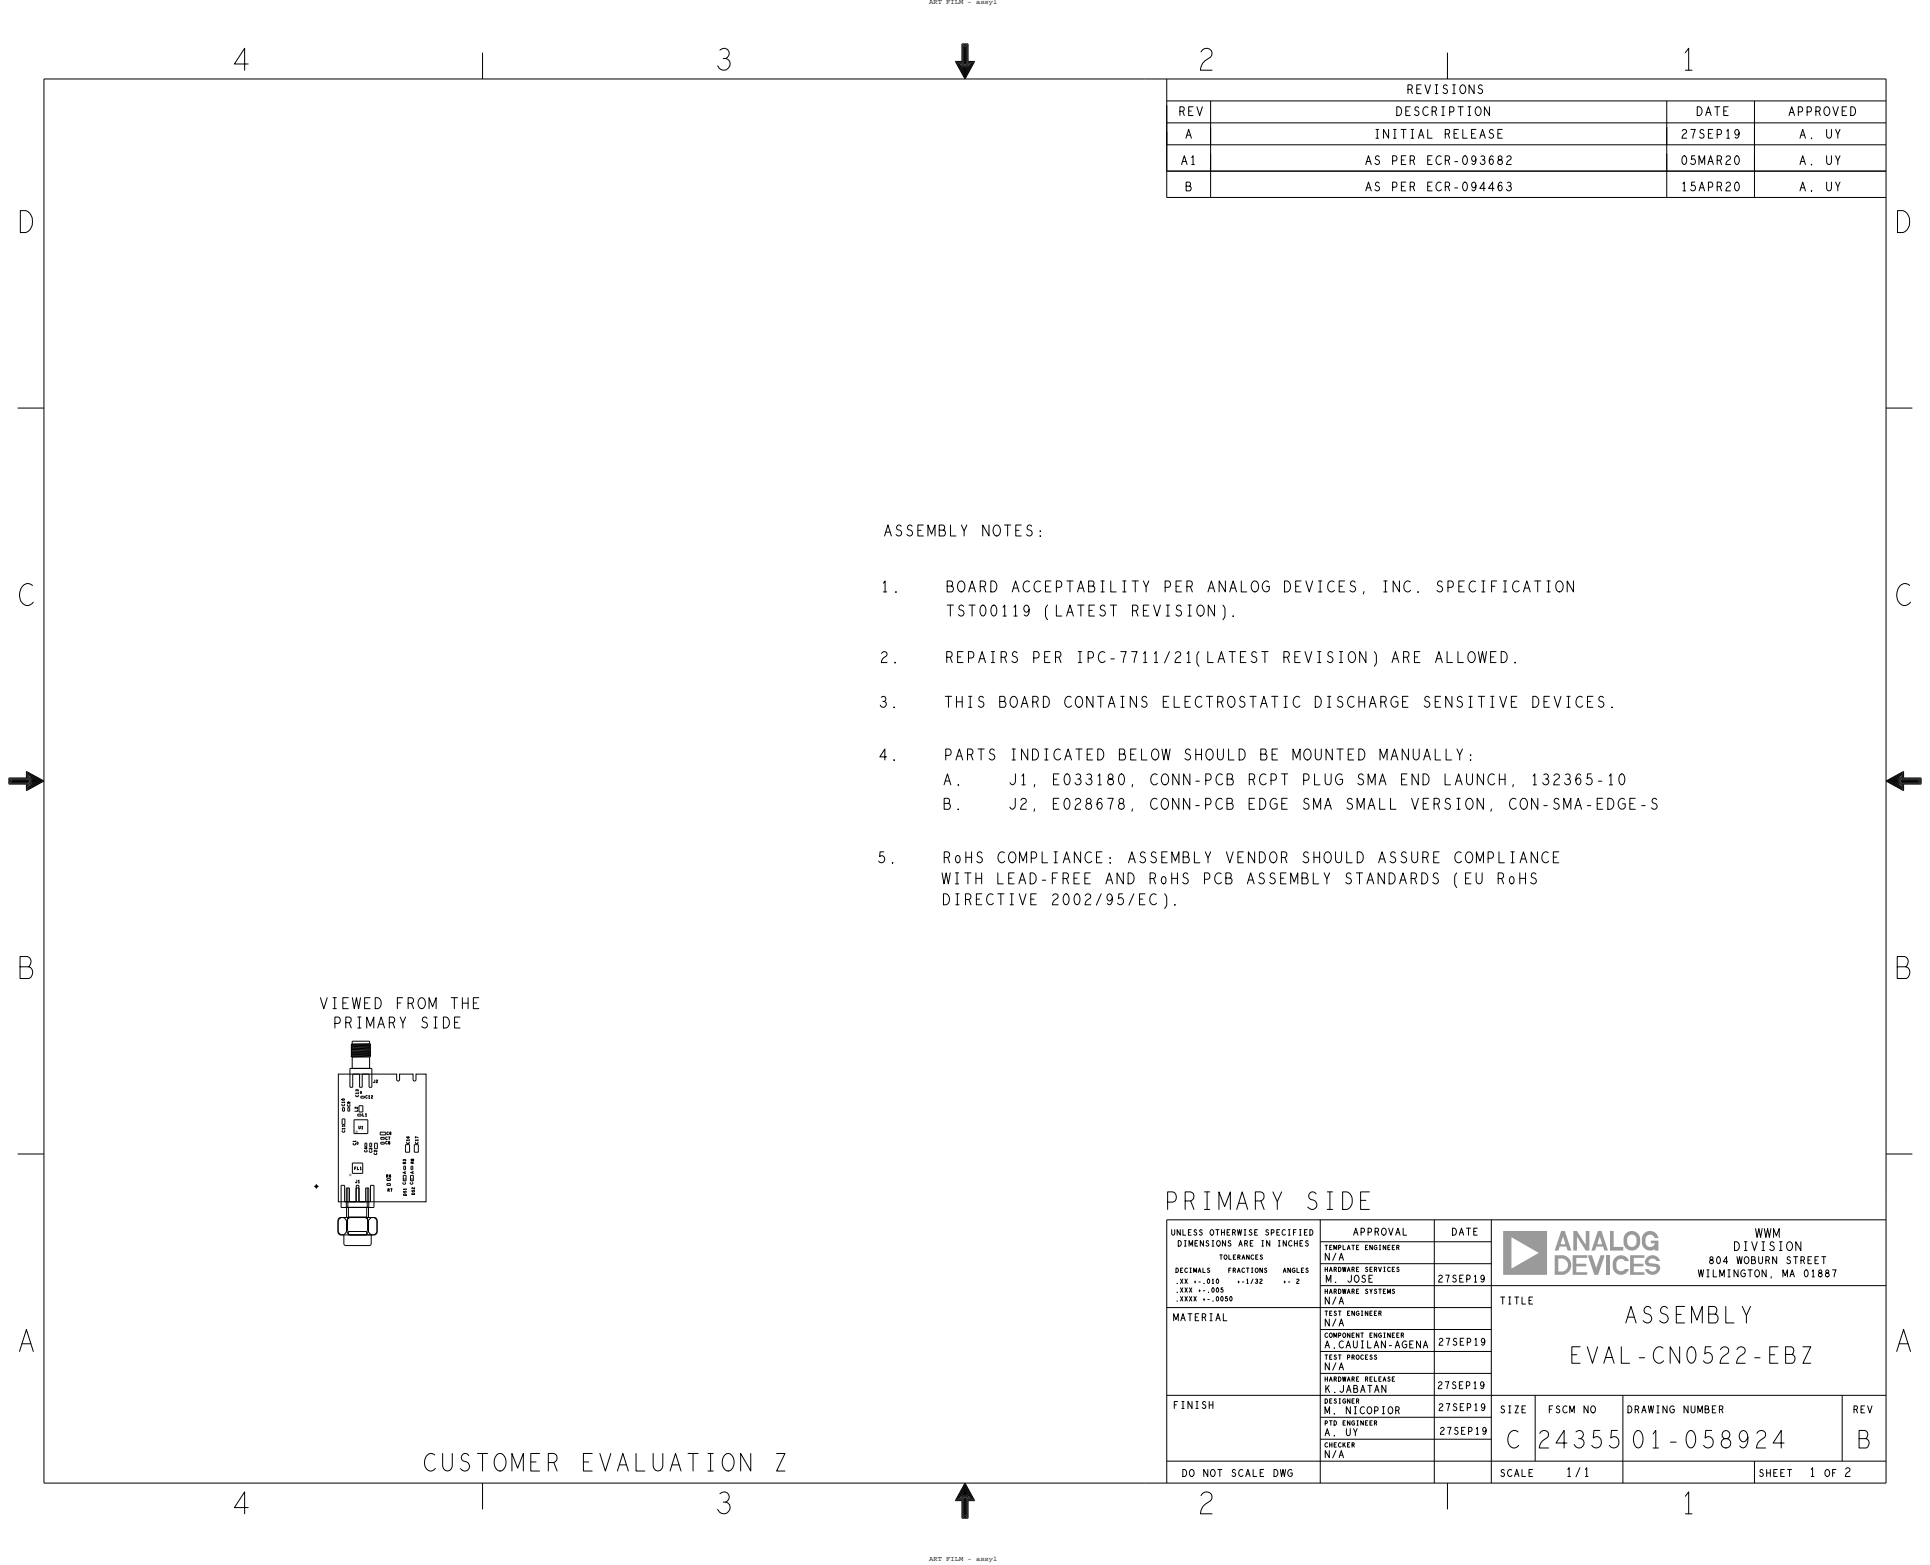
[picture p34: page 1]

REVISIONS

REV | DESCRIPTION | DATE | | APPROVED
A | INITIAL RELEASE | | 27SEP19 | A. UY
A1 | AS PER ECR-093682 | | 05MAR20 | A. UY
B | AS PER ECR-094463 | | 15APR20 | A. UY

3. THIS BOARD CONTAINS ELECTROSTATIC DISCHARGE SENSITIVE DEVICES.

4. PARTS INDICATED BELOW SHOULD BE MOUNTED MANUALLY:

A. J1, E033180, CONN-PCB RCPT PLUG SMA END LAUNCH, 132365-10
B. J2, E028678, CONN-PCB EDGE SMA SMALL VERSION, CON-SMA-EDGE-S

5. RoHS COMPLIANCE: ASSEMBLY VENDOR SHOULD ASSURE COMPLIANCE

WITH LEAD-FREE AND RoHS PCB ASSEMBLY STANDARDS (EU RoHS
DIRECTIVE 2002/95/EC).

UNLESS OTHERWISE SPECIFIED DECIMALS .XX +-.010 .XXX +-.005 .XXXX +-.0050 | TOLERANCES FRACTIONS +-1/32 | | | ANGLES +- | 2 | APPROVAL | DATE

TEMPLATE ENGINEER N/A
HARDWARE SERVICES M. JOSE | 27SEP19
HARDWARE SYSTEMS N/A | | | ASSEMBLY EVAL-CN0522-EBZ

MATERIAL | | TEST ENGINEER N/A

COMPONENT ENGINEER A.CAUILAN-AGENA | 27SEP19

TEST PROCESS N/A
HARDWARE RELEASE | 27SEP19
DESIGNER M. NICOPIOR | 27SEP19 | SIZE C | | FSCM NO 24355 | DRAWING NUMBER 01 | -058924 | REV B
PTD ENGINEER A. UY | 27SEP19

CHECKER N/A

DO NOT SCALE DWG | | | 1/1 SCALE | | SHEET

D

4

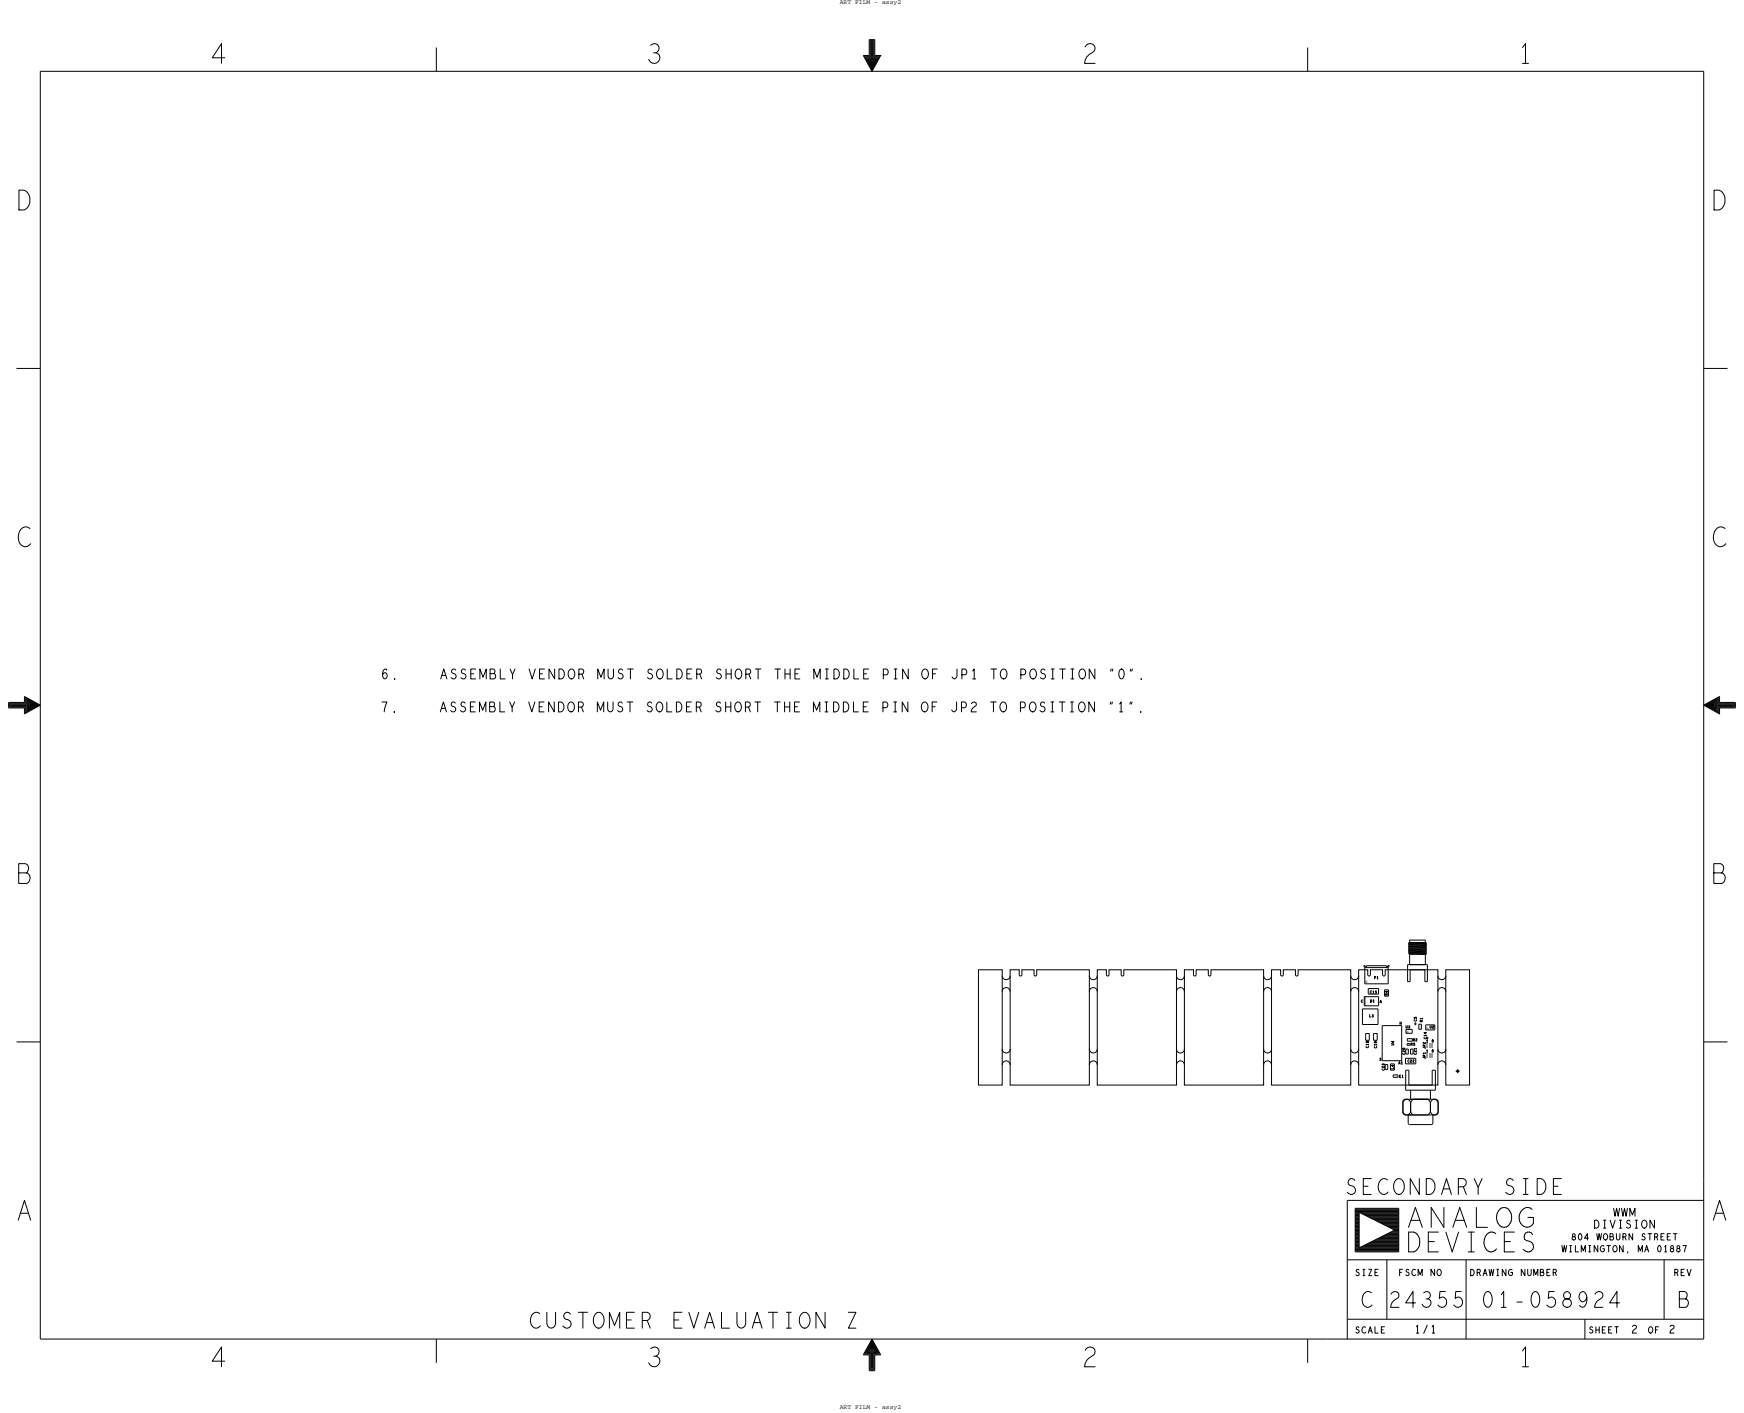
[picture p35: page 2]

SIZE C | FSCM NO 24355 | DRAWING NUMBER 01-058924 | REV B

1/1 SCALE | | SHEET
