a-conspiracy-theory/jhnvrw-seniordesign/hardware/tx-pcb/tx-sch.pdf

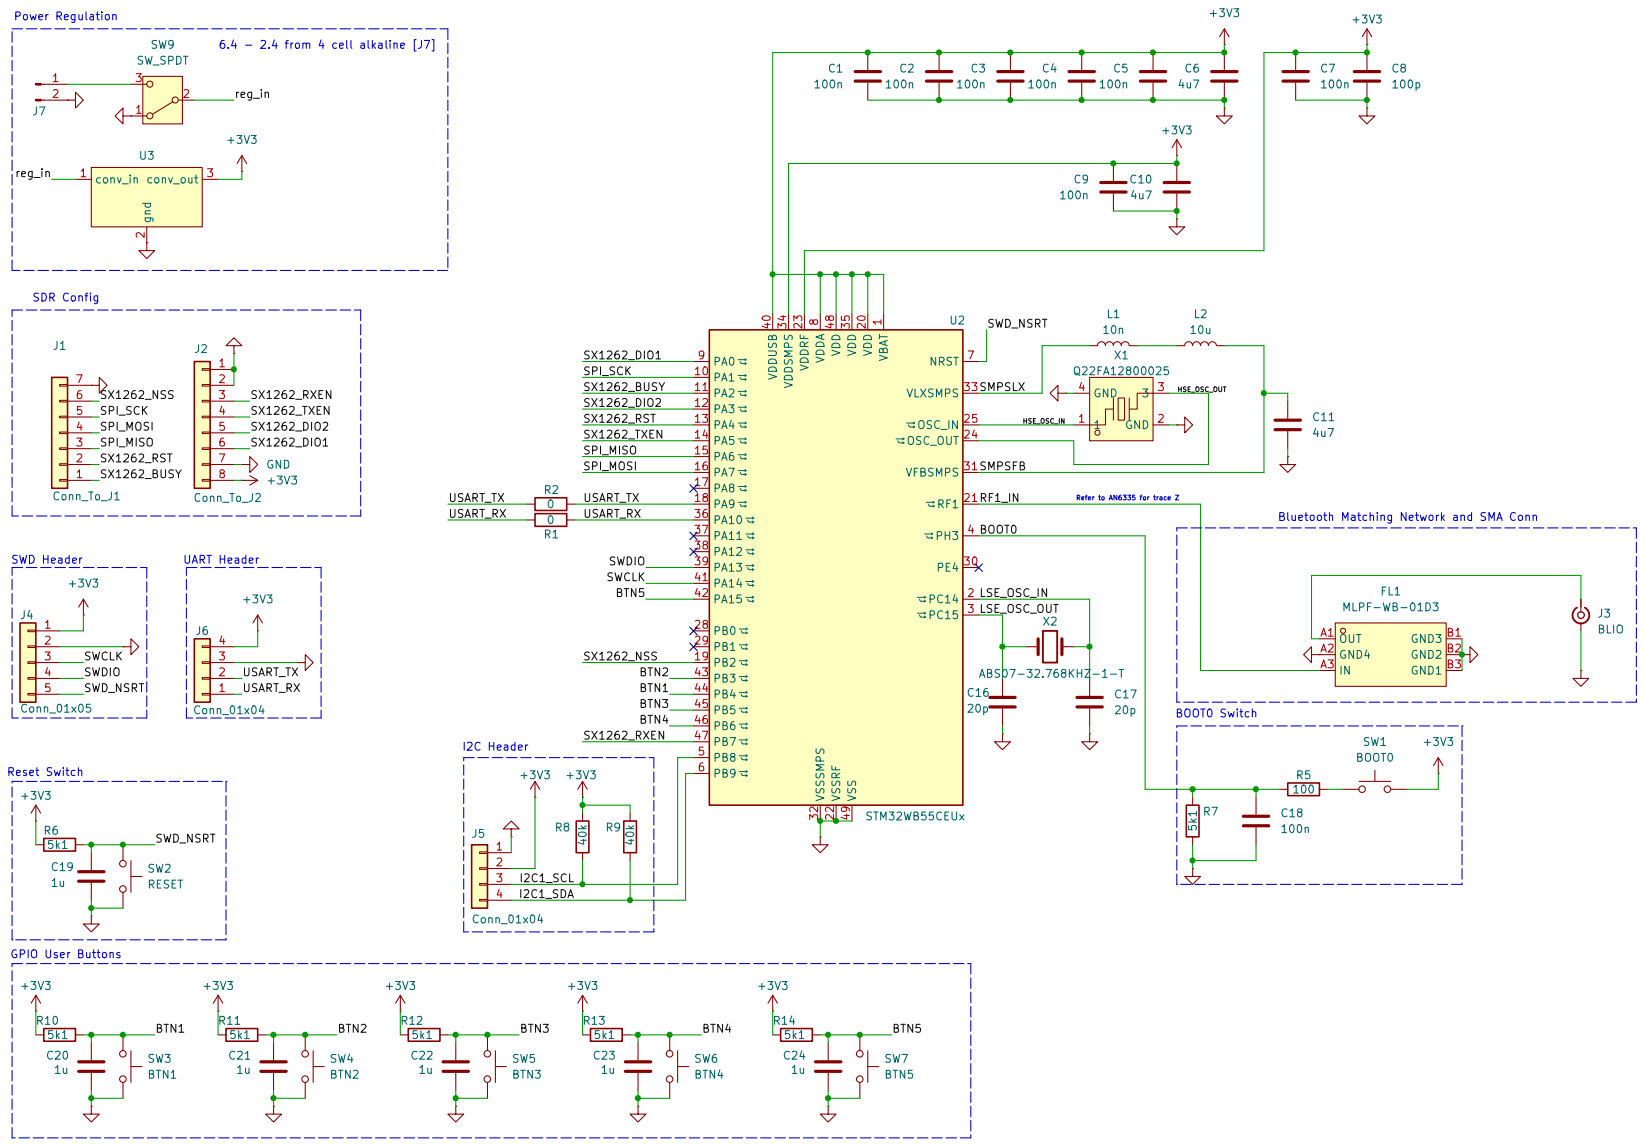
[picture p36: page 1]
