a-conspiracy-theory/jhnvrw-seniordesign/hardware/tx-pcb/tx-pcb.pdf

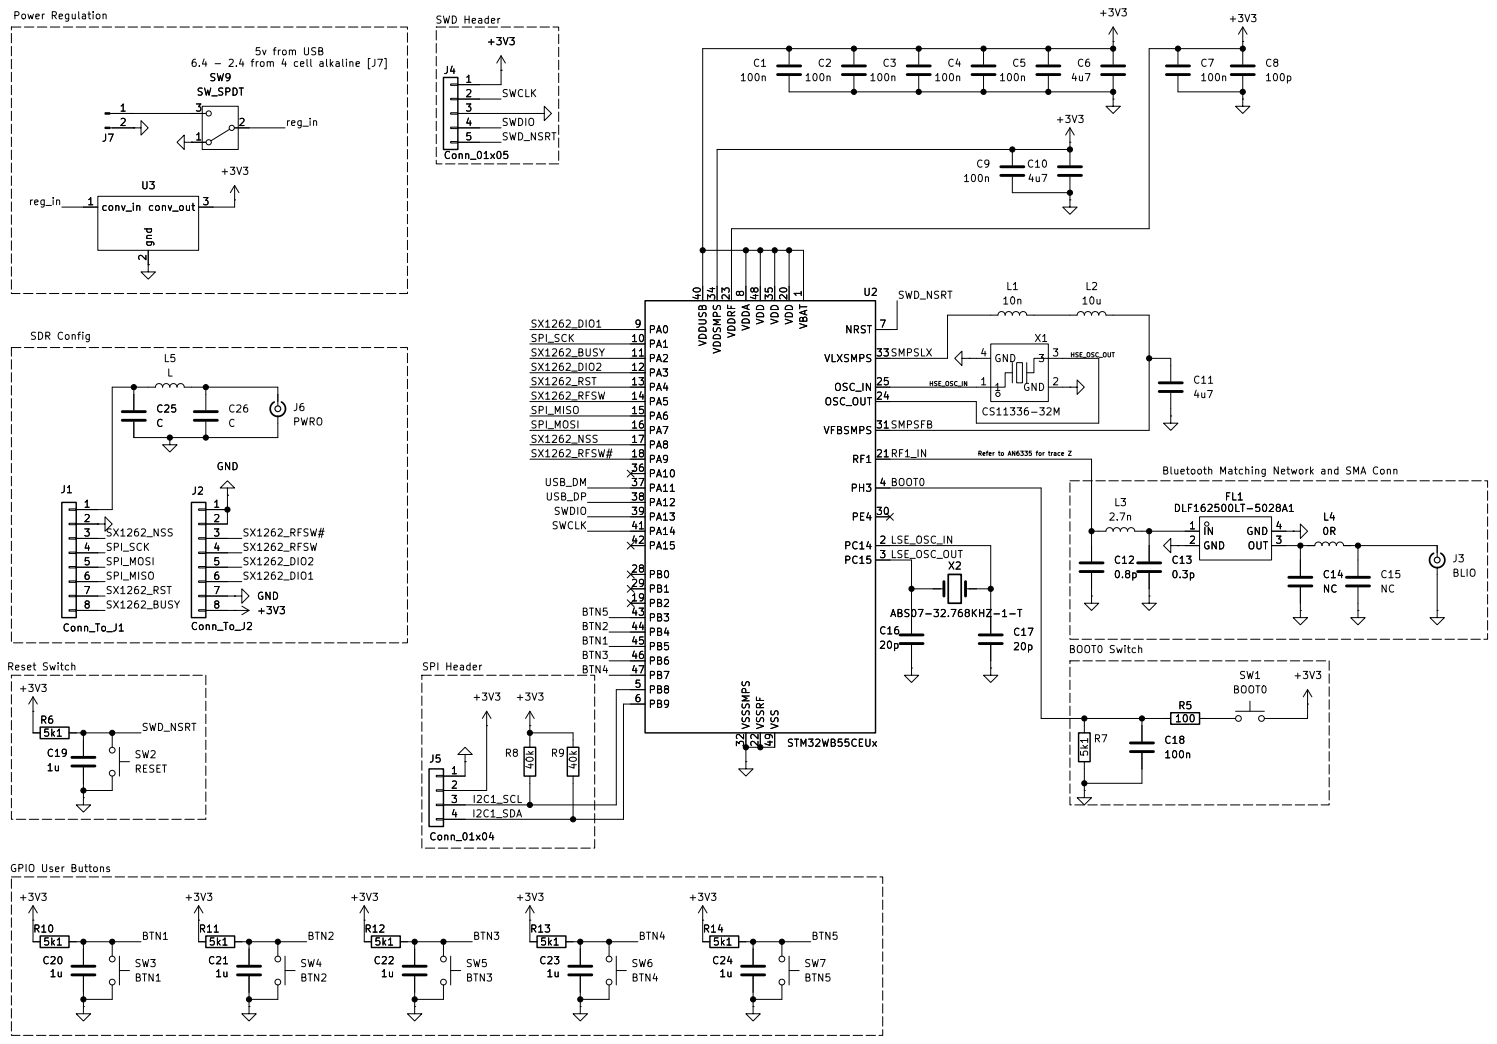
[picture p37: page 1]
