a-conspiracy-theory/jhnvrw-seniordesign/hardware/rx-pcb/power_harvester/harvester layout.pdf

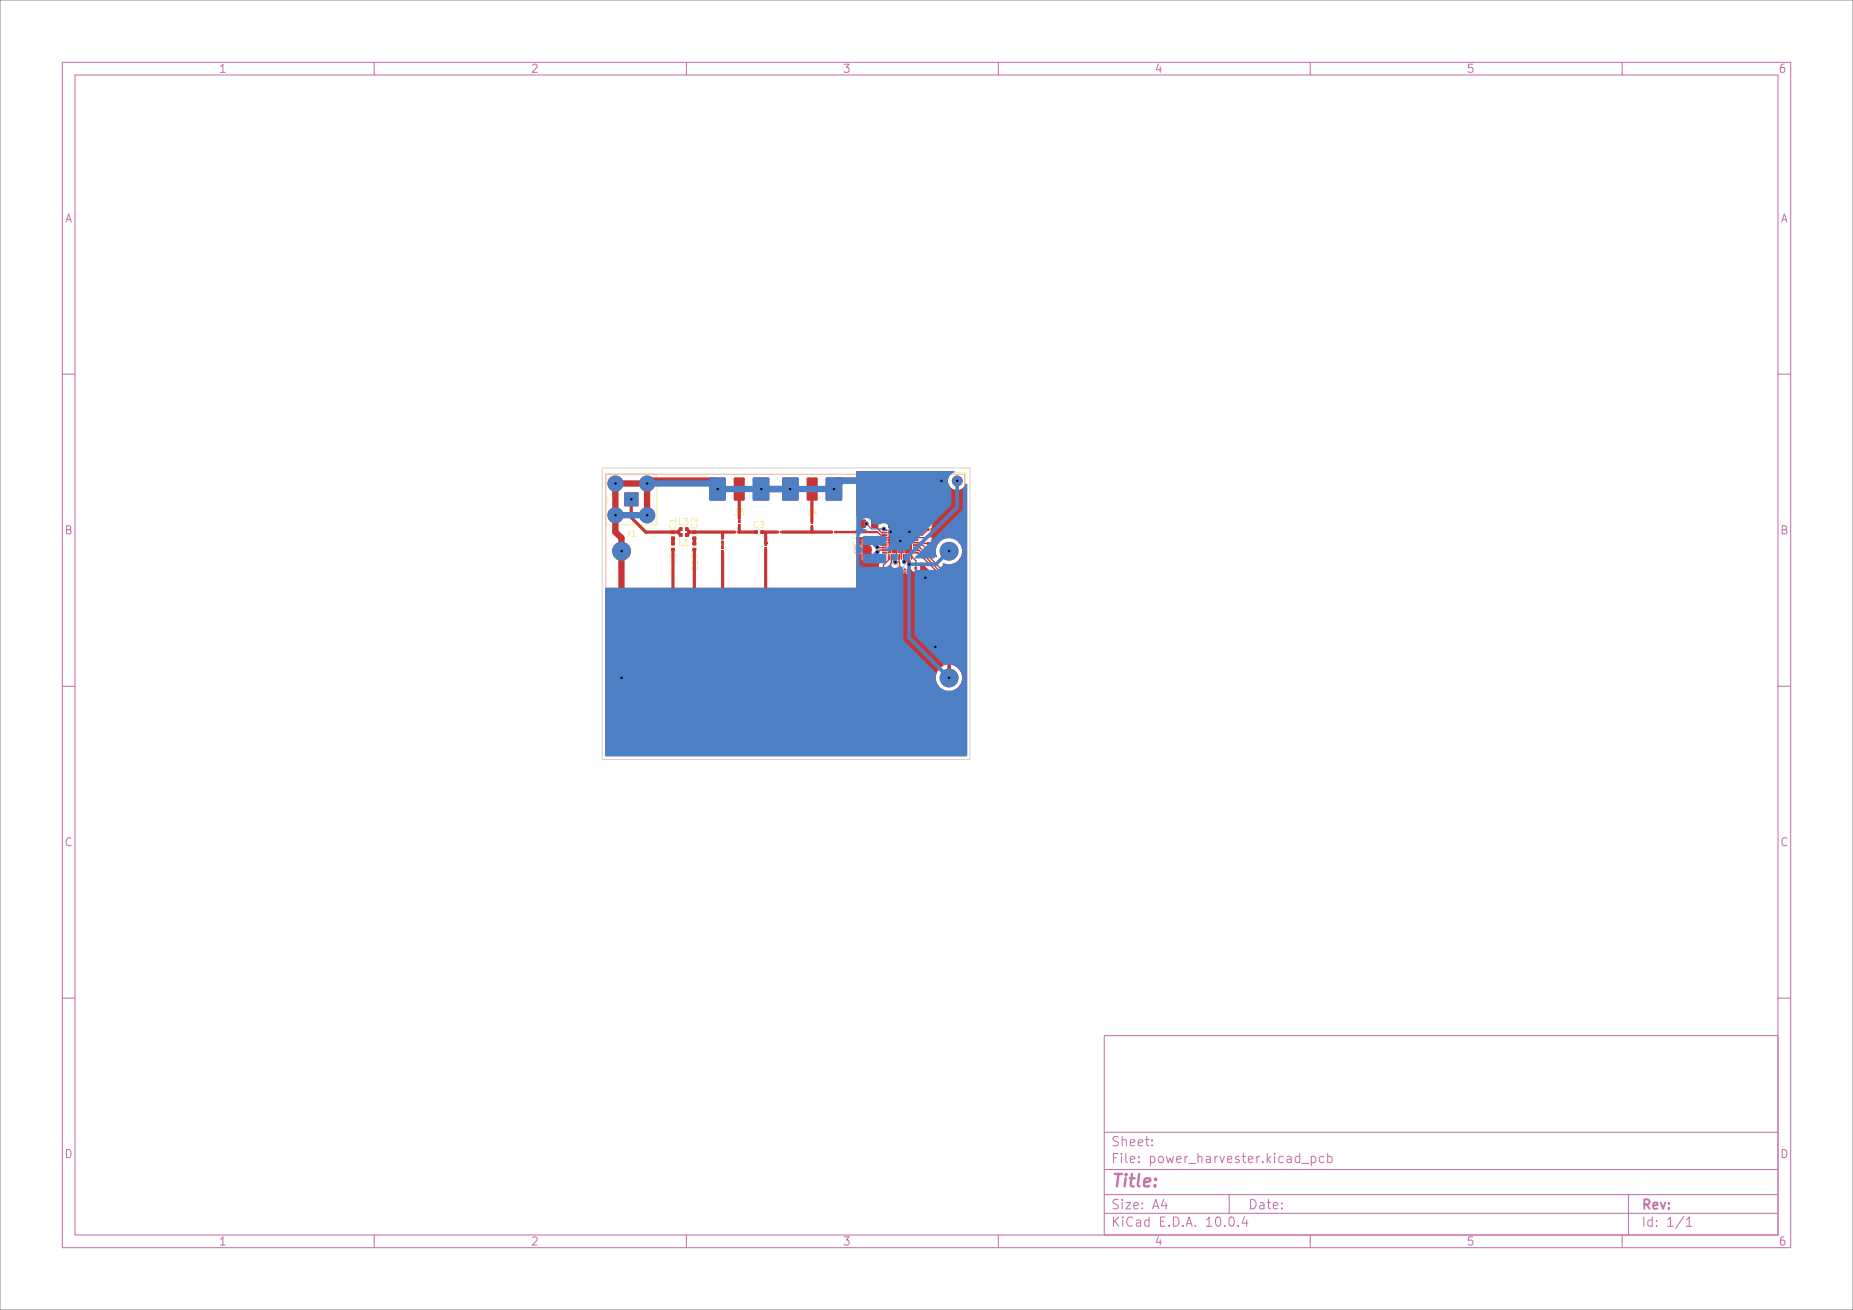
[picture p38: page 1]
