a-conspiracy-theory/jhnvrw-seniordesign/hardware/tx-pcb/reference-designs/swrr077/CC1101_CC1190EM_915MHz_SCHEMATIC_1_2_0.pdf

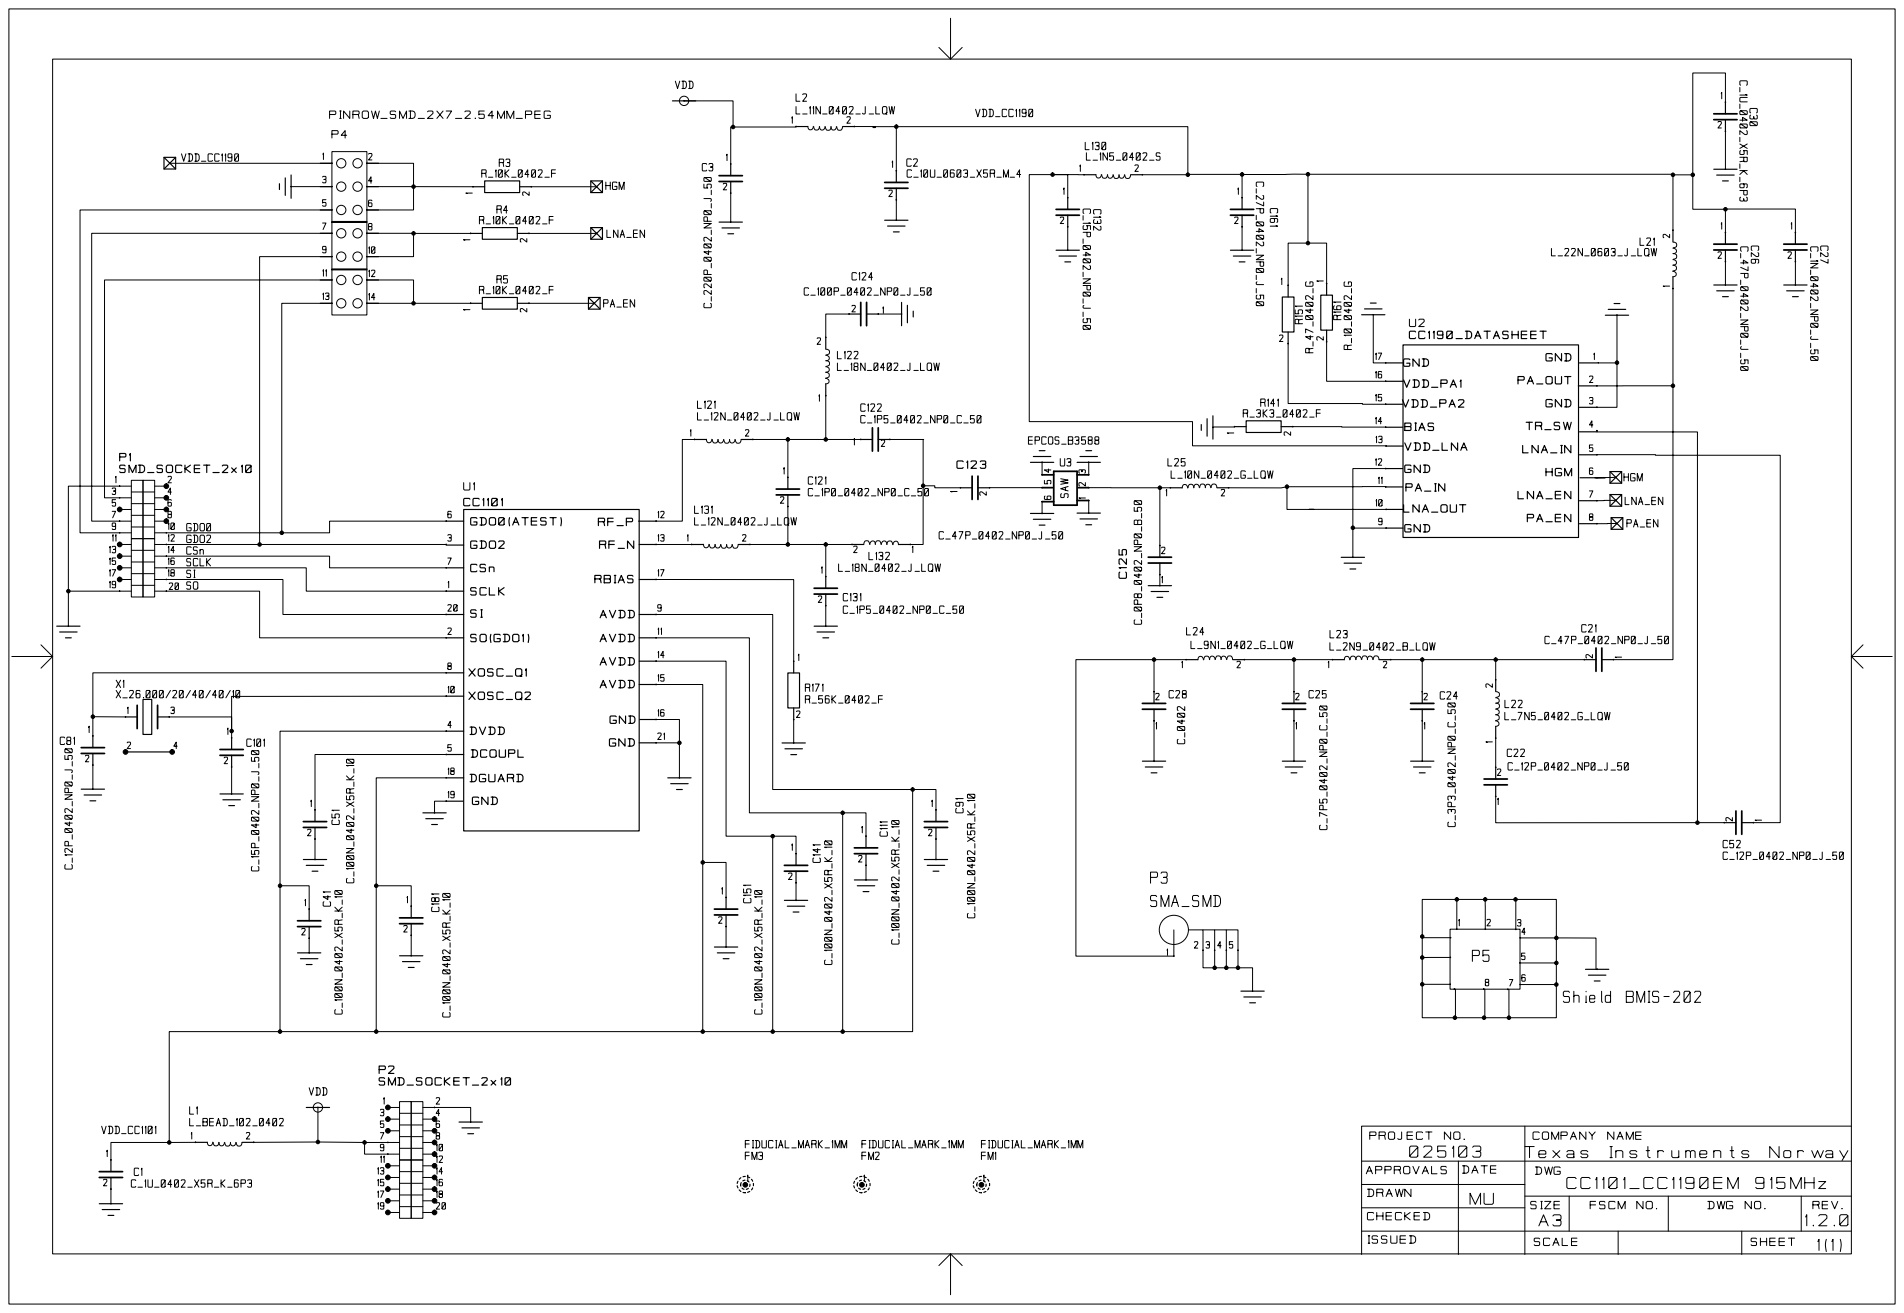
[picture p39: page 1]
