a-conspiracy-theory/jhnvrw-seniordesign/simulations/voltage_double_rectifier.asc

C1: cap; 11.9p
C2: cap; 1n
C3: cap; 100p
C4: cap; 4.3p
C5: cap; 1f
L1: ind; 9.2n
R1: res; 1e9
U1: JDH2S02SL
U2: JDH2S02SL
V1: voltage; SINE(0 0.2 915meg); Rser=50
V2: voltage; SINE(0 1 915meg)
Named nets: 0
.tran 0 100u 0 10p
