a-conspiracy-theory/jhnvrw-seniordesign/(list of files, drawings)

Other design files:
hardware/tx-pcb/reference-designs/swrr045b/CC1101EM_868_915MHz_3_0_0.pcb
hardware/tx-pcb/reference-designs/swrr077/CC1101_CC1190EM_915MHz_1_2_0.pcb
