a-conspiracy-theory/jhnvrw-seniordesign/hardware/tx-pcb/tx-pcb.kicad_pcb

## KiCad design hardware/tx-pcb/tx-pcb.kicad_pcb (2026-10-31)

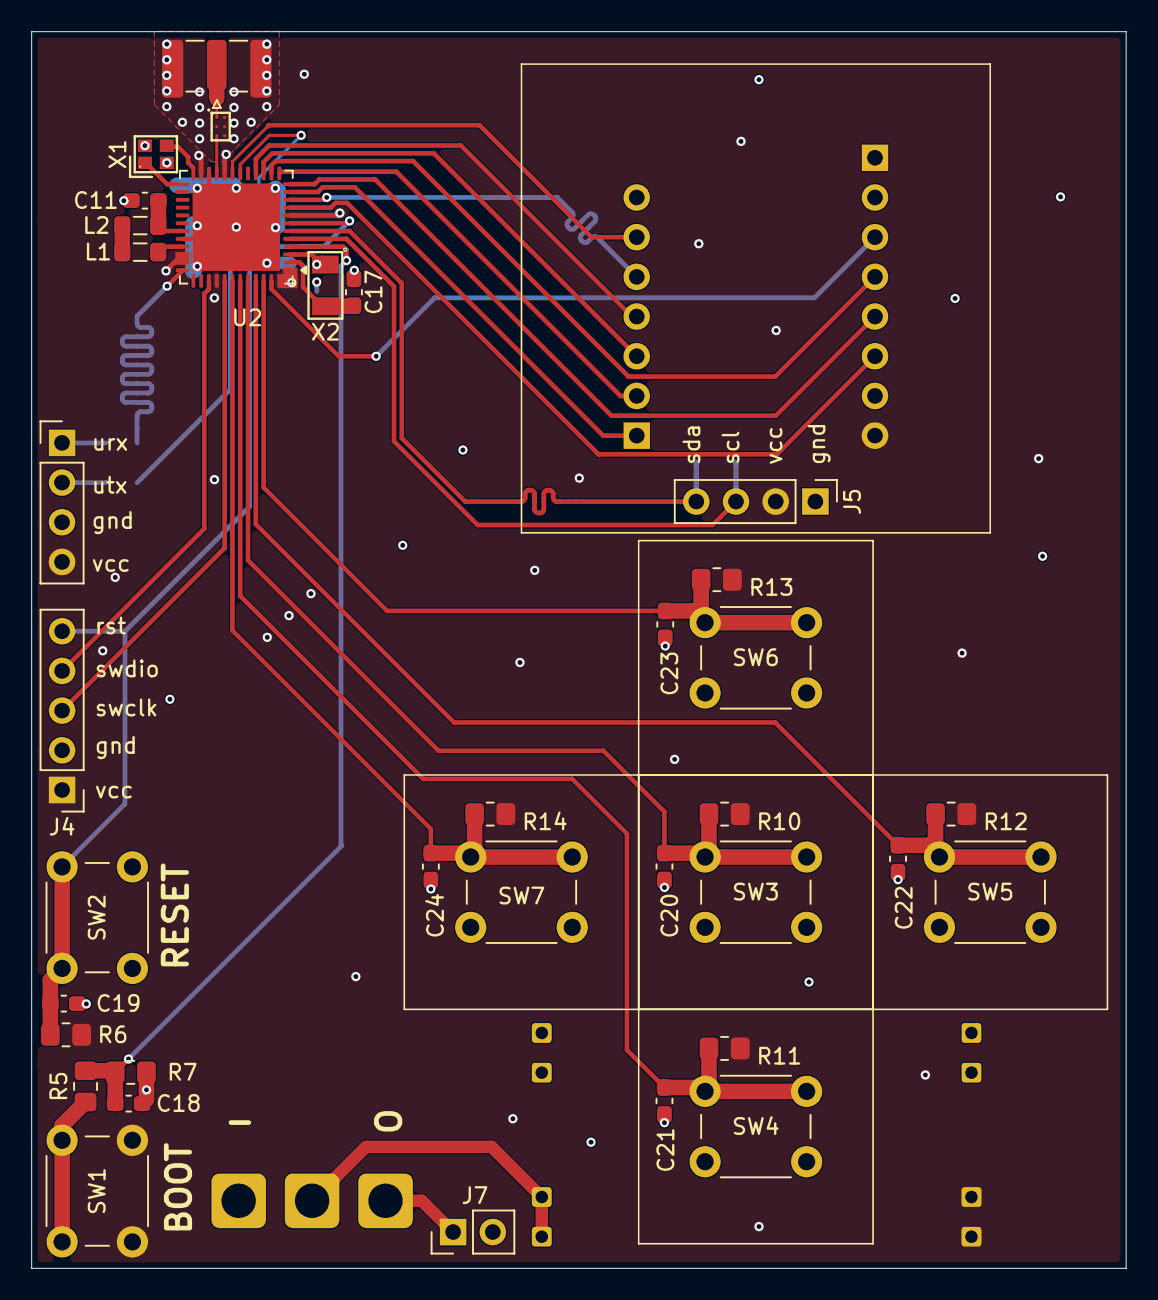
[picture p40: board tx-pcb.kicad_pcb from above]

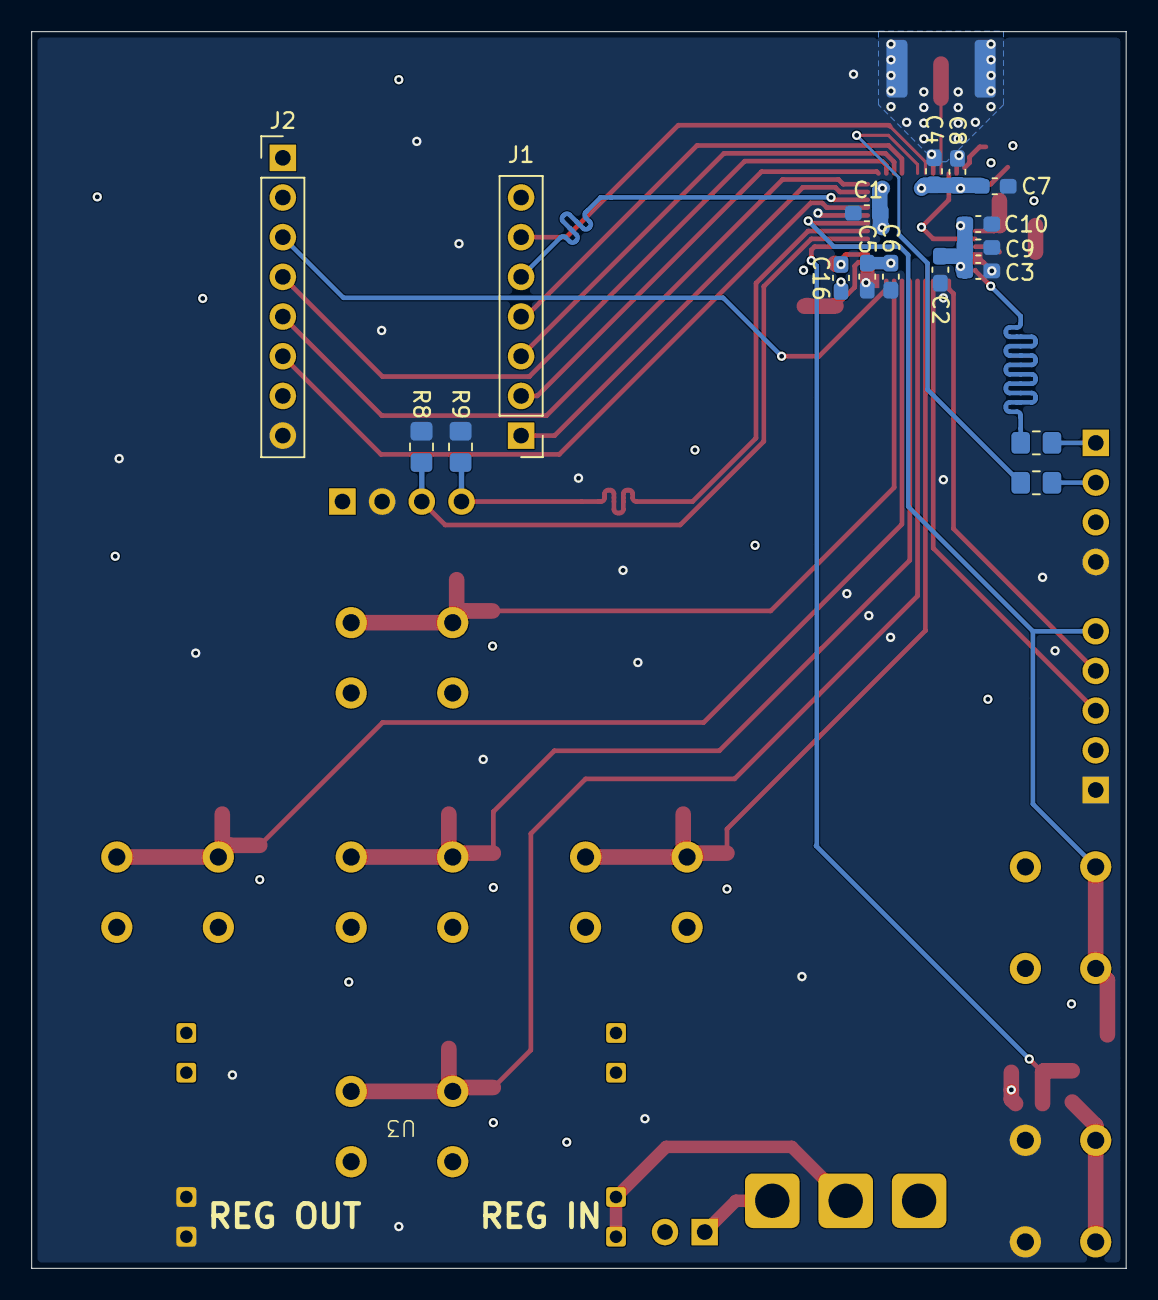
[picture p41: board tx-pcb.kicad_pcb from below]

Board: 4 copper layers, 70.0 x 79.1 mm, 54 parts (18 on the bottom side), 37 nets.

Parts:
C1, C2, C3, C4, C5, C7, C9, C18: 100n; C_0603_1608Metric_Pad1.08x0.95mm_HandSolder
C6, C10, C11: 4u7; C_0603_1608Metric_Pad1.08x0.95mm_HandSolder
C8: 100p; C_0603_1608Metric_Pad1.08x0.95mm_HandSolder
C16, C17: 20p; C_0603_1608Metric_Pad1.08x0.95mm_HandSolder
C19, C20, C21, C22, C23, C24: 1u; C_0603_1608Metric_Pad1.08x0.95mm_HandSolder
FL1: MLPF-WB-01D3; BGA-6_L1.6-W1.0-R3-C2-P0.50-TL
J1: Conn_To_J1; PinHeader_1x07_P2.54mm_Vertical
J2: Conn_To_J2; PinHeader_1x08_P2.54mm_Vertical
J3: BLIO; SMA_Samtec_SMA-J-P-H-ST-EM1_EdgeMount
J4: Conn_01x05; PinHeader_1x05_P2.54mm_Vertical
J5, J6: Conn_01x04; PinHeader_1x04_P2.54mm_Vertical
J7: Conn_01x02_Pin; PinHeader_1x02_P2.54mm_Vertical
L1: 10n; L_0805_2012Metric_Pad1.05x1.20mm_HandSolder
L2: 10u; L_0805_2012Metric_Pad1.05x1.20mm_HandSolder
R1, R2: 0; R_0805_2012Metric_Pad1.20x1.40mm_HandSolder
R5: 100; R_0805_2012Metric_Pad1.20x1.40mm_HandSolder
R6, R7, R10, R11, R12, R13, R14: 5k1; R_0805_2012Metric_Pad1.20x1.40mm_HandSolder
R8, R9: 40k; R_0805_2012Metric_Pad1.20x1.40mm_HandSolder
SW1: BOOT0; SW_PUSH_6mm
SW2: RESET; SW_PUSH_6mm
SW3: BTN1; SW_PUSH_6mm
SW4: BTN2; SW_PUSH_6mm
SW5: BTN3; SW_PUSH_6mm
SW6: BTN4; SW_PUSH_6mm
SW7: BTN5; SW_PUSH_6mm
SW9: SW_SPDT; spdt_amazon
U2: STM32WB55CEUx; QFN-48-1EP_7x7mm_P0.5mm_EP5.6x5.6mm
U3: TPS63070_board
X1: Q22FA12800025; CRYSTAL-SMD_4P-L2.0-W1.6-BL
X2: ABS07-32.768KHZ-1-T; OSC-SMD_2P-L3.2-W1.5

Connections:
+3V3: C1.1, C2.1, C3.1, C4.1, C5.1, C6.1, C7.1, C8.1, C9.1, C10.1, J2.8, J4.1, J5.2, J6.4, R6.1, R8.1, R9.1, R10.1, R11.1, R12.1, R13.1, R14.1, SW1.2, U2.1 (VBAT), U2.8 (VDDA), U2.20 (VDD), U2.23 (VDDRF), U2.34 (VDDSMPS), U2.35 (VDD), U2.40 (VDDUSB), U2.48 (VDD), U3.3 (conv_out)
/BOOT0: C18.2, R5.1, R7.1, U2.4 (PH3)
/BTN1: C20.1, R10.2, SW3.1, U2.44 (PB4)
/BTN2: C21.1, R11.2, SW4.1, U2.43 (PB3)
/BTN3: C22.1, R12.2, SW5.1, U2.45 (PB5)
/BTN4: C23.1, R13.2, SW6.1, U2.46 (PB6)
/BTN5: C24.1, R14.2, SW7.1, U2.42 (PA15)
/HSE_OSC_IN: U2.25 (OSC_IN), X1.1
/HSE_OSC_OUT: U2.24 (OSC_OUT), X1.3
/I2C1_SCL: J5.3, R8.2, U2.5 (PB8)
/I2C1_SDA: J5.4, R9.2, U2.6 (PB9)
/LSE_OSC_IN: C17.1, U2.2 (PC14), X2.2
/LSE_OSC_OUT: C16.1, U2.3 (PC15), X2.1
/RF1_IN: FL1.A3 (IN), U2.21 (RF1)
/SMPSFB: C11.1, L2.2, U2.31 (VFBSMPS)
/SMPSLX: L1.1, U2.33 (VLXSMPS)
/SPI_MISO: J1.3, U2.15 (PA6)
/SPI_MOSI: J1.4, U2.16 (PA7)
/SPI_SCK: J1.5, U2.10 (PA1)
/SWCLK: J4.3, U2.41 (PA14)
/SWDIO: J4.4, U2.39 (PA13)
/SWD_NSRT: C19.1, J4.5, R6.2, SW2.1, U2.7 (NRST)
/SX1262_BUSY: J1.1, U2.11 (PA2)
/SX1262_DIO1: J2.6, U2.9 (PA0)
/SX1262_DIO2: J2.5, U2.12 (PA3)
/SX1262_NSS: J1.6, U2.19 (PB2)
/SX1262_RST: J1.2, U2.13 (PA4)
/SX1262_RXEN: J2.3, U2.47 (PB7)
/SX1262_TXEN: J2.4, U2.14 (PA5)
/USART_RX: J6.1, R1.1, R1.2, U2.36 (PA10)
/USART_TX: J6.2, R2.1, R2.2, U2.18 (PA9)
/reg_in: SW9.2 (B), U3.1 (conv_in)
GND: C1.2, C2.2, C3.2, C4.2, C5.2, C6.2, C7.2, C8.2, C9.2, C10.2, C11.2, C16.2, C17.2, C18.1, C19.2, C20.2, C21.2, C22.2, C23.2, C24.2, FL1.A2 (GND4), FL1.B1 (GND3), FL1.B2 (GND2), FL1.B3 (GND1), J1.7, J2.1, J2.2, J2.7, J3.2 (Ext), J4.2, J5.1, J6.3, J7.2, R7.2, SW2.2, SW3.2, SW4.2, SW5.2, SW6.2, SW7.2, SW9.1 (A), U2.22 (VSSRF), U2.32 (VSSSMPS), U2.49 (VSS), U3.2 (gnd), X1.2 (GND), X1.4 (GND)
unnamed: FL1.A1 (OUT), J3.1 (In)
unnamed: J7.1, SW9.3 (C)
unnamed: L1.2, L2.1
unnamed: R5.2, SW1.1
