a-conspiracy-theory/jhnvrw-seniordesign/hardware/rx-pcb/bluetooth_test/rx-pcb.kicad_pcb

## KiCad design hardware/rx-pcb/bluetooth_test/rx-pcb.kicad_pcb (2026-10-15)

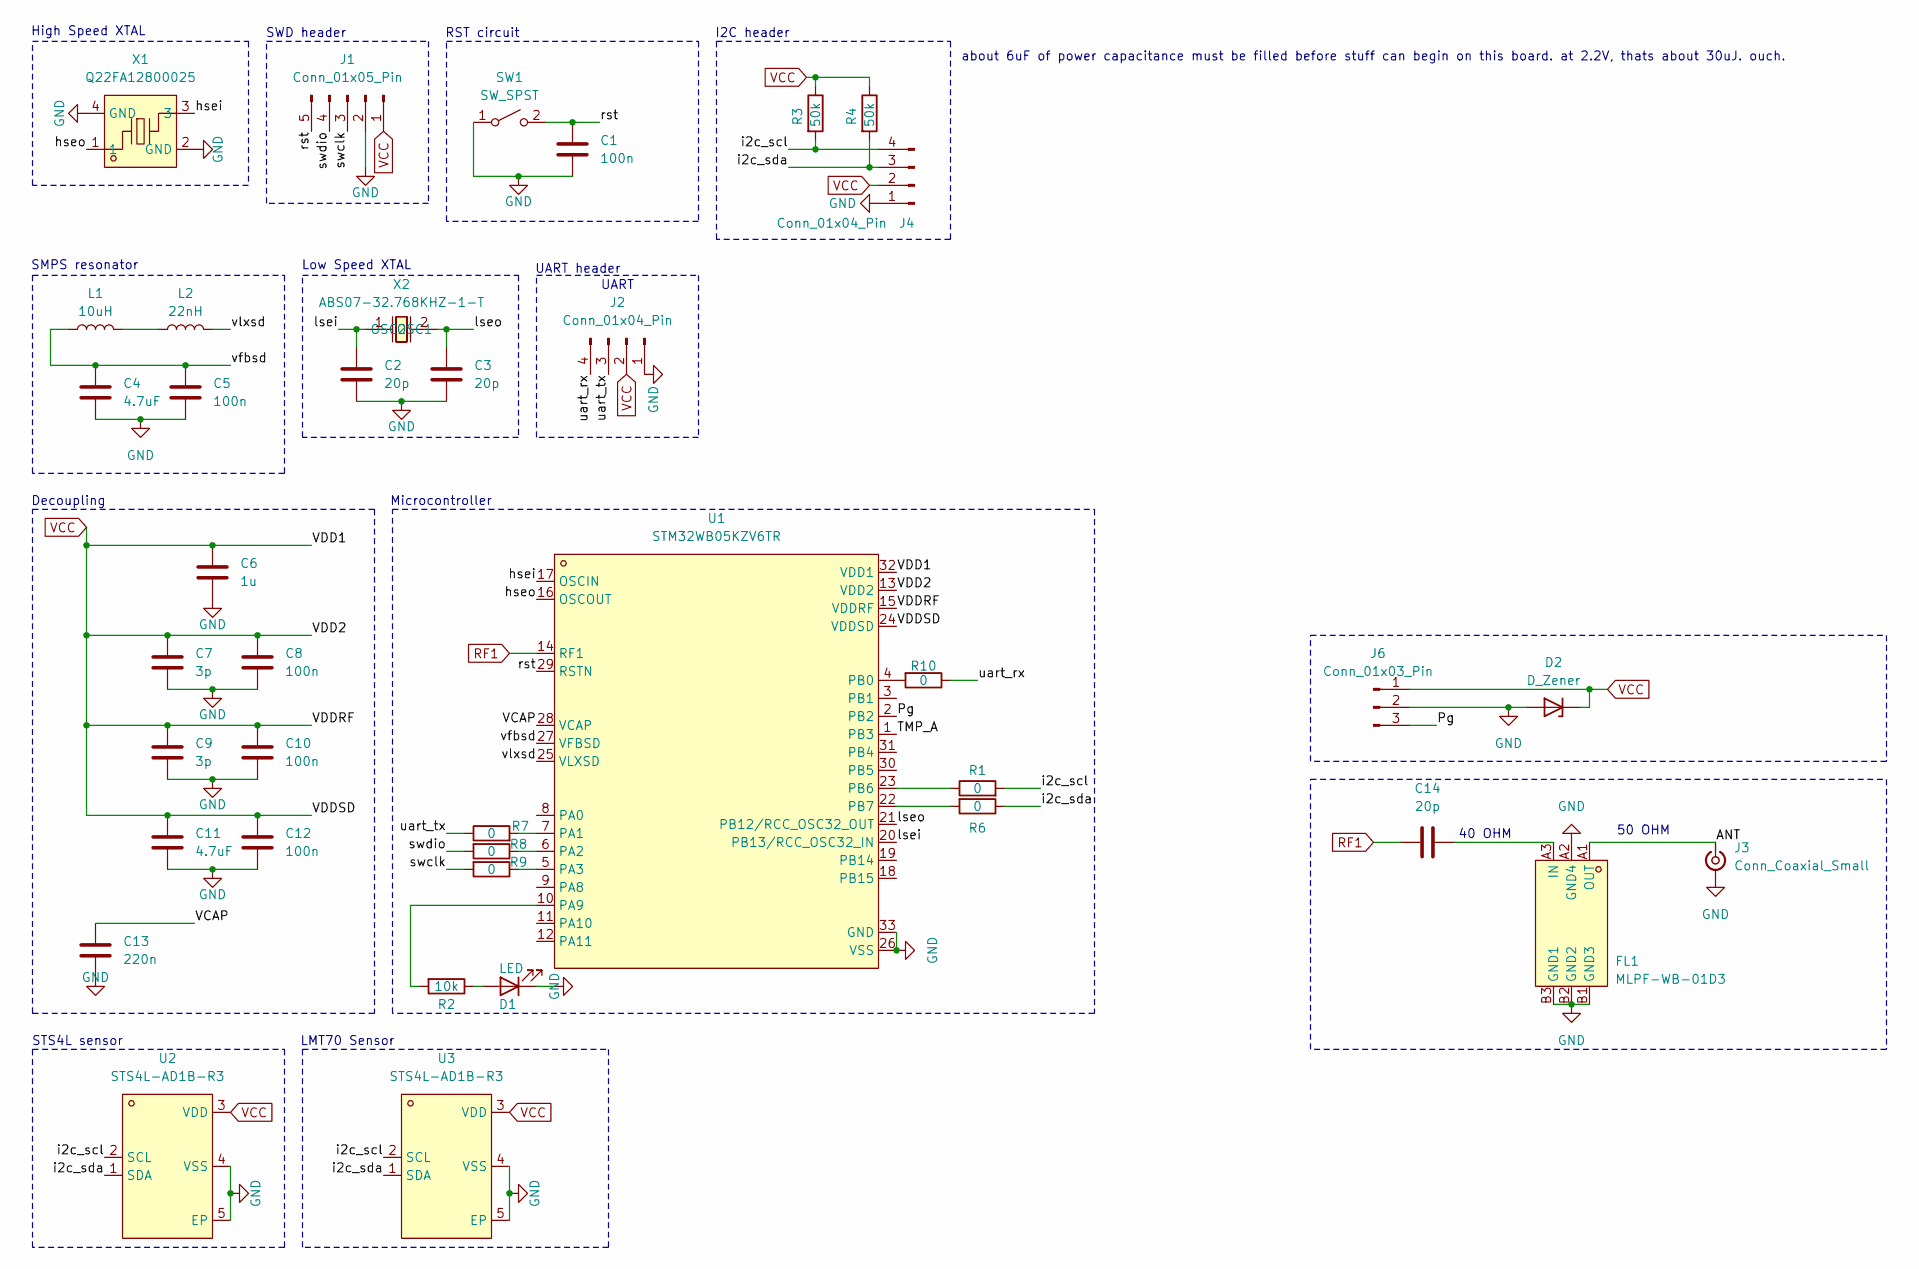
[picture p42: schematic rx-pcb.kicad_sch]

Parts:
C1, C5, C8, C10, C12: 100n; C_0805_2012Metric_Pad1.18x1.45mm_HandSolder
C2, C3: 20p; C_0805_2012Metric_Pad1.18x1.45mm_HandSolder
C4, C11: 4.7uF; C_0805_2012Metric_Pad1.18x1.45mm_HandSolder
C6: 1u; C_0805_2012Metric_Pad1.18x1.45mm_HandSolder
C7, C9: 3p; C_0805_2012Metric_Pad1.18x1.45mm_HandSolder
C13: 220n; C_0805_2012Metric_Pad1.18x1.45mm_HandSolder
C14: 20p; R_0201_0603Metric_Pad0.64x0.40mm_HandSolder_correctedcleara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
D1: LED; LED_0805_2012Metric_Pad1.15x1.40mm_HandSolder
D2: D_Zener; D_0603_1608Metric_Pad1.05x0.95mm_HandSolder
FL1: MLPF-WB-01D3; BGA-6_L1.6-W1.0-R3-C2-P0.50-TL; MPN MLPF-WB-01D3; LCSC Part C5440144
J1: Conn_01x05_Pin; PinHeader_1x05_P2.54mm_Vertical
J2, J4: Conn_01x04_Pin; PinHeader_1x04_P2.54mm_Vertical
J3: Conn_Coaxial_Small; SMA_Samtec_SMA-J-P-H-ST-EM1_EdgeMount
J6: Conn_01x03_Pin; PinHeader_1x03_P2.54mm_Vertical
L1: 10uH; L_0805_2012Metric_Pad1.05x1.20mm_HandSolder
L2: 22nH; L_0805_2012Metric_Pad1.05x1.20mm_HandSolder
R1, R6: 0; R_0805_2012Metric_Pad1.20x1.40mm_HandSolder
R2: 10k; R_0805_2012Metric_Pad1.20x1.40mm_HandSolder
R3, R4: 50k; R_0805_2012Metric_Pad1.20x1.40mm_HandSolder
R7, R8, R9, R10: 0; R_0805_2012Metric
SW1: SW_SPST; SW_PUSH_6mm
U1: STM32WB05KZV6TR; UFQFN-32_L5.0-W5.0-P0.50-TL-EP3.5; MPN STM32WB05KZV6TR; LCSC Part C28314403
U2, U3: STS4L-AD1B-R3; DFN-4_L1.5-W1.5-P0.80-TL-EP; MPN STS4L-AD1B-R3; LCSC Part C41410764
X1: Q22FA12800025; CRYSTAL-SMD_4P-L2.0-W1.6-BL; MPN Q22FA12800025; LCSC Part C187794
X2: ABS07-32.768KHZ-1-T; OSC-SMD_2P-L3.2-W1.5; MPN ABS07-32.768KHz-1-T; LCSC Part C145140

Connections:
/ANT: FL1.A1 (OUT), J3.1 (In)
/Pg: J6.3, U1.2 (PB2)
/TMP_A: U1.1 (PB3)
/VCAP: C13.1, U1.28 (VCAP)
/hsei: U1.17 (OSCIN), X1.3
/hseo: U1.16 (OSCOUT), X1.1
/i2c_scl: J4.4, R1.2, R3.2, U2.2 (SCL), U3.2 (SCL)
/i2c_sda: J4.3, R4.2, R6.1, U2.1 (SDA), U3.1 (SDA)
/lsei: C2.1, U1.20 (PB13/RCC_OSC32_IN), X2.1 (OSC1)
/lseo: C3.1, U1.21 (PB12/RCC_OSC32_OUT), X2.2 (OSC2)
/rst: C1.1, J1.5, SW1.2 (B), U1.29 (RSTN)
/swclk: J1.3, R9.2
/swdio: J1.4, R8.2
/uart_rx: J2.4, R10.1
/uart_tx: J2.3, R7.1
/vfbsd: C4.1, C5.1, L1.1, U1.27 (VFBSD)
/vlxsd: L2.2, U1.25 (VLXSD)
GND: C1.2, C2.2, C3.2, C4.2, C5.2, C6.2, C7.2, C8.2, C9.2, C10.2, C11.2, C12.2, C13.2, D1.1 (K), D2.2 (A), FL1.A2 (GND4), FL1.B1 (GND3), FL1.B2 (GND2), FL1.B3 (GND1), J1.2, J2.1, J3.2 (Ext), J4.1, J6.2, SW1.1 (A), U1.26 (VSS), U1.33 (GND), U2.4 (VSS), U2.5 (EP), U3.4 (VSS), U3.5 (EP), X1.2 (GND), X1.4 (GND)
unnamed: D1.2 (A), R2.1
unnamed: C14.2, FL1.A3 (IN)
unnamed: L1.2, L2.1
unnamed: R7.2, U1.7 (PA1)
unnamed: R8.1, U1.6 (PA2)
unnamed: R9.1, U1.5 (PA3)
unnamed: R2.2, U1.10 (PA9)
unnamed: R10.2, U1.4 (PB0)
unnamed: R1.1, U1.23 (PB6)
unnamed: R6.2, U1.22 (PB7)
RF1: C14.1, U1.14 (RF1)
VCC: C6.1, C7.1, C8.1, C9.1, C10.1, C11.1, C12.1, D2.1 (K), J1.1, J2.2, J4.2, J6.1, R3.1, R4.1, U1.13 (VDD2), U1.15 (VDDRF), U1.24 (VDDSD), U1.32 (VDD1), U2.3 (VDD), U3.3 (VDD)

Notes on the sheet:
Low Speed XTAL
about 6uF of power capacitance must be filled before stuff can begin on this board. at 2.2V, thats about 30uJ. ouch.
40 OHM
UART header
LMT70 Sensor
RST circuit
Microcontroller
SWD header
High Speed XTAL
UART
Decoupling
STS4L sensor
I2C header
SMPS resonator
50 OHM

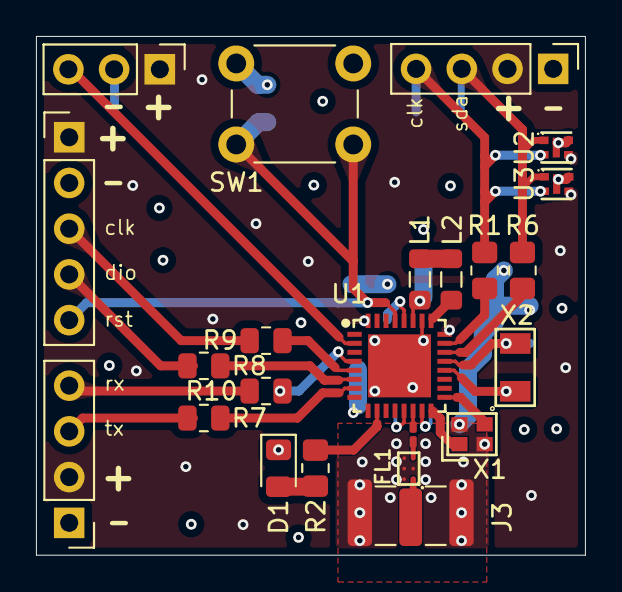
[picture p43: board rx-pcb.kicad_pcb from above]

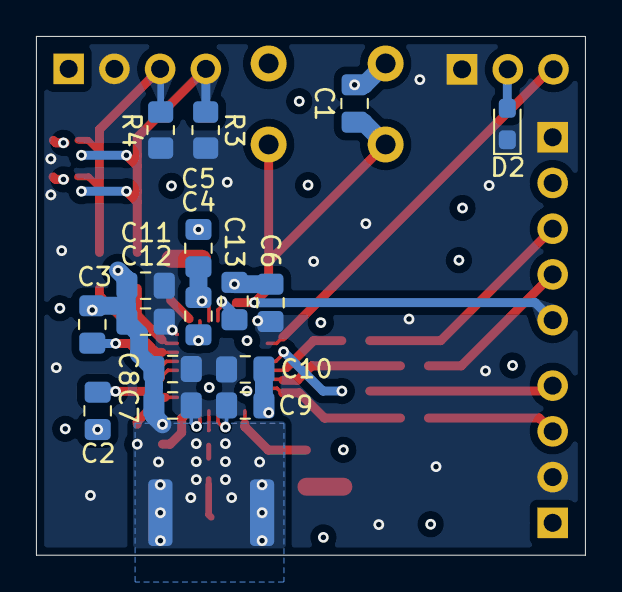
[picture p44: board rx-pcb.kicad_pcb from below]

Board: 4 copper layers, 30.5 x 28.8 mm, 39 parts (16 on the bottom side), 29 nets.
