a-conspiracy-theory/jhnvrw-seniordesign/hardware/rx-pcb/power_harvester/power_harvester.kicad_pcb

## KiCad design hardware/rx-pcb/power_harvester/power_harvester.kicad_pcb (2026-10-15)

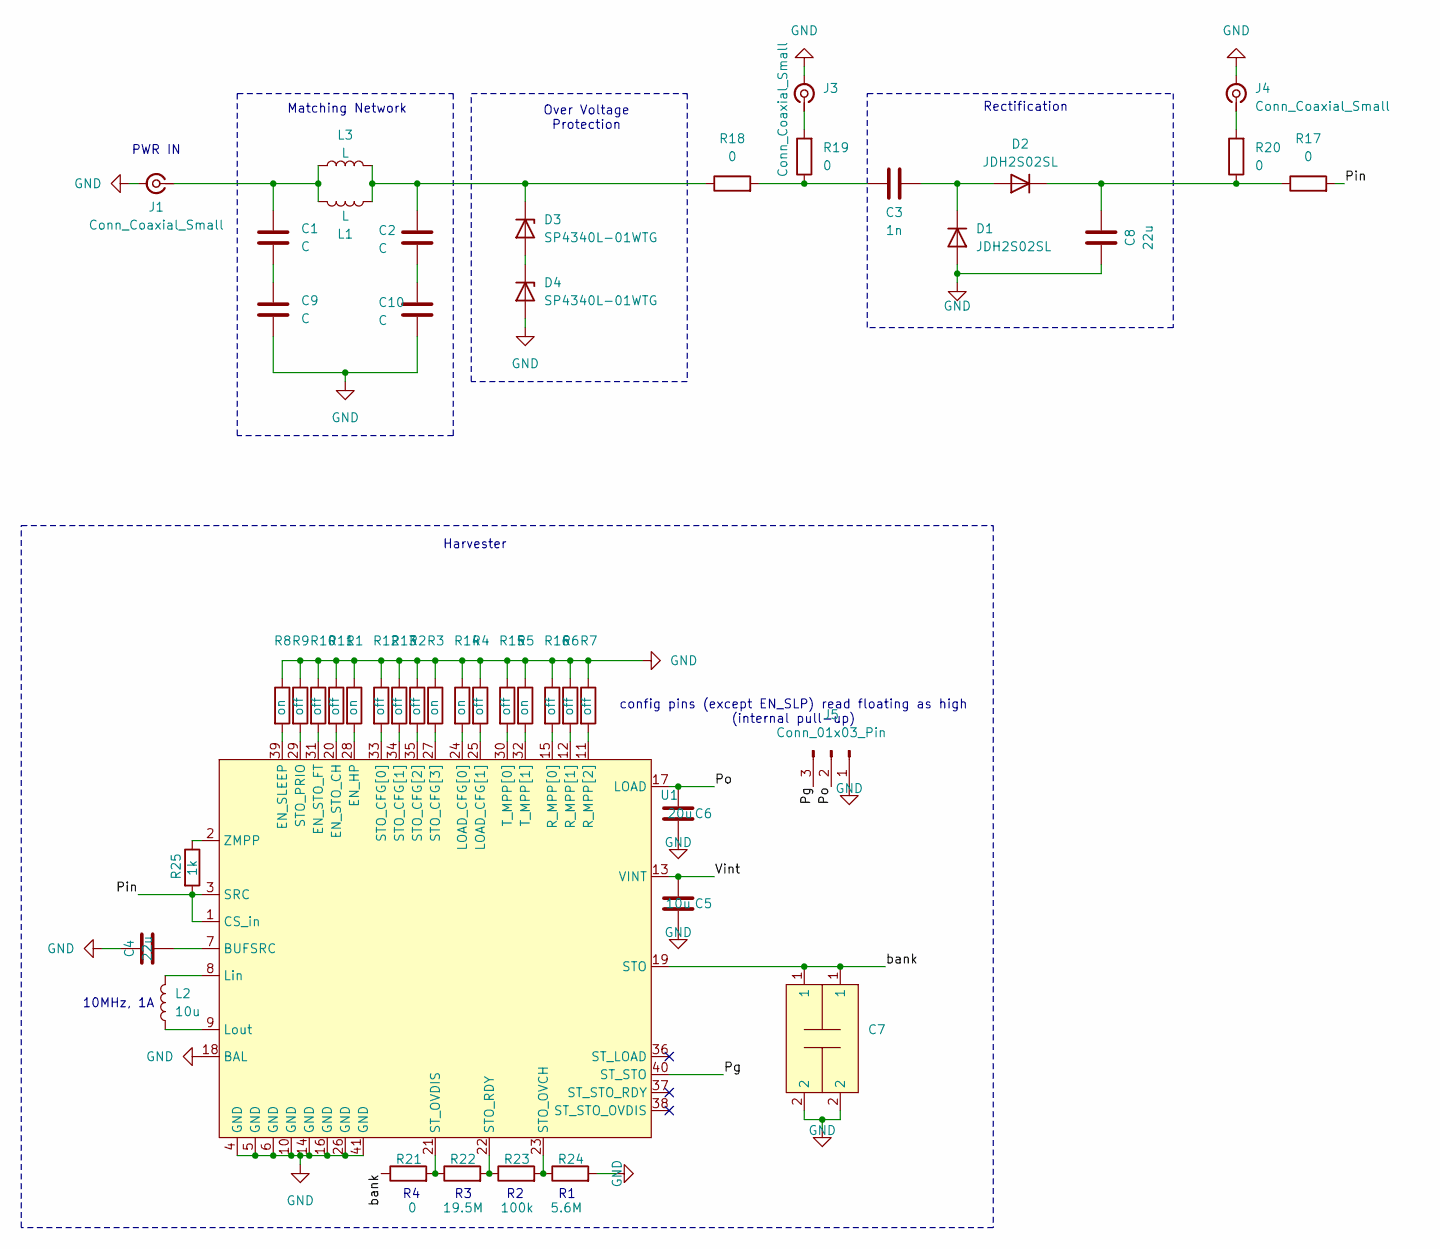
[picture p45: schematic power_harvester.kicad_sch]

Parts:
C1, C2, C9, C10: C; C_0402_1005Metric
C3: 1n; C_0402_1005Metric
C4: 22u; C_0603_1608Metric_Pad1.08x0.95mm_HandSolder
C5: 10u; C_0603_1608Metric_Pad1.08x0.95mm_HandSolder
C6: 20u; C_0603_1608Metric_Pad1.08x0.95mm_HandSolder
C7: C4AQXEXXXXXXXAX
C8: 22u; C_0805_2012Metric_Pad1.18x1.45mm_HandSolder
D1, D2: JDH2S02SL; R_0201_0603Metric_correctedclearance
D3, D4: SP4340L-01WTG; R_0201_0603Metric_correctedclearance
J1: Conn_Coaxial_Small; SMA_Amphenol_901-143_Horizontal
J3, J4: Conn_Coaxial_Small; SMA_Molex_73251-2120_EdgeMount_Horizontal
J5: Conn_01x03_Pin; PinHeader_1x03_P2.54mm_Vertical
L1, L3: L; L_0402_1005Metric
L2: 10u; WE-MAPI
R1, R3, R5, R8, R14: on; R_0201_0603Metric_correctedclearance
R2, R4, R6, R7, R9, R10, R11, R12, R13, R15, R16: off; R_0201_0603Metric_correctedclearance
R17, R18, R19, R20: 0; R_0201_0603Metric_correctedclearance
R21: 0; R_0805_2012Metric_Pad1.20x1.40mm_HandSolder
R22: 19.5M; R_0805_2012Metric_Pad1.20x1.40mm_HandSolder
R23: 100k; R_0805_2012Metric_Pad1.20x1.40mm_HandSolder
R24: 5.6M; R_0805_2012Metric_Pad1.20x1.40mm_HandSolder
R25: 1k; R_0805_2012Metric_Pad1.20x1.40mm_HandSolder
U1: QFN-40-1EP_5x5mm_P0.4mm_EP3.8x3.8mm

Connections:
/Pg: J5.3, U1.40 (ST_STO)
/Pin: R17.2, R25.2, U1.1 (CS_in), U1.3 (SRC)
/Po: C6.2, J5.2, U1.17 (LOAD)
/Vint: C5.2, U1.13 (VINT)
/bank: C7.1, R21.1, U1.19 (STO)
GND: C4.1, C5.1, C6.1, C7.2, C8.1, C9.2, C10.2, D1.2 (A), D4.2 (A), J1.2 (Ext), J3.2 (Ext), J4.2 (Ext), J5.1, R1.1, R2.1, R3.1, R4.1, R5.1, R6.1, R7.1, R8.1, R9.1, R10.1, R11.1, R12.1, R13.1, R14.1, R15.1, R16.1, R24.2, U1.4 (GND), U1.5 (GND), U1.6 (GND), U1.10 (GND), U1.14 (GND), U1.16 (GND), U1.18 (BAL), U1.26 (GND), U1.41 (GND)
unnamed: C1.2, C9.1
unnamed: C3.1, R18.2, R19.1
unnamed: C2.2, C10.1
unnamed: C3.2, D1.1 (K), D2.2 (A)
unnamed: C8.2, D2.1 (K), R17.1, R20.1
unnamed: D3.2 (A), D4.1 (K)
unnamed: C2.1, D3.1 (K), L1.1, L3.2, R18.1
unnamed: C1.1, J1.1 (In), L1.2, L3.1
unnamed: J3.1 (In), R19.2
unnamed: J4.1 (In), R20.2
unnamed: C4.2, U1.7 (BUFSRC)
unnamed: R1.2, U1.28 (EN_HP)
unnamed: R8.2, U1.39 (EN_SLEEP)
unnamed: R11.2, U1.20 (EN_STO_CH)
unnamed: R10.2, U1.31 (EN_STO_FT)
unnamed: R14.2, U1.24 (LOAD_CFG[0])
unnamed: R4.2, U1.25 (LOAD_CFG[1])
unnamed: L2.2, U1.8 (Lin)
unnamed: L2.1, U1.9 (Lout)
unnamed: R16.2, U1.15 (R_MPP[0])
unnamed: R6.2, U1.12 (R_MPP[1])
unnamed: R7.2, U1.11 (R_MPP[2])
unnamed: R12.2, U1.33 (STO_CFG[0])
unnamed: R13.2, U1.34 (STO_CFG[1])
unnamed: R2.2, U1.35 (STO_CFG[2])
unnamed: R3.2, U1.27 (STO_CFG[3])
unnamed: R23.2, R24.1, U1.23 (STO_OVCH)
unnamed: R9.2, U1.29 (STO_PRIO)
unnamed: R22.2, R23.1, U1.22 (STO_RDY)
unnamed: R21.2, R22.1, U1.21 (ST_OVDIS)
unnamed: R15.2, U1.30 (T_MPP[0])
unnamed: R5.2, U1.32 (T_MPP[1])
unnamed: R25.1, U1.2 (ZMPP)

Notes on the sheet:
Over Voltage Protection
R4 R3 R2 R1
config pins (except EN_SLP) read floating as high (internal pull-up)
Matching Network
Harvester
Rectification
PWR IN
10MHz, 1A

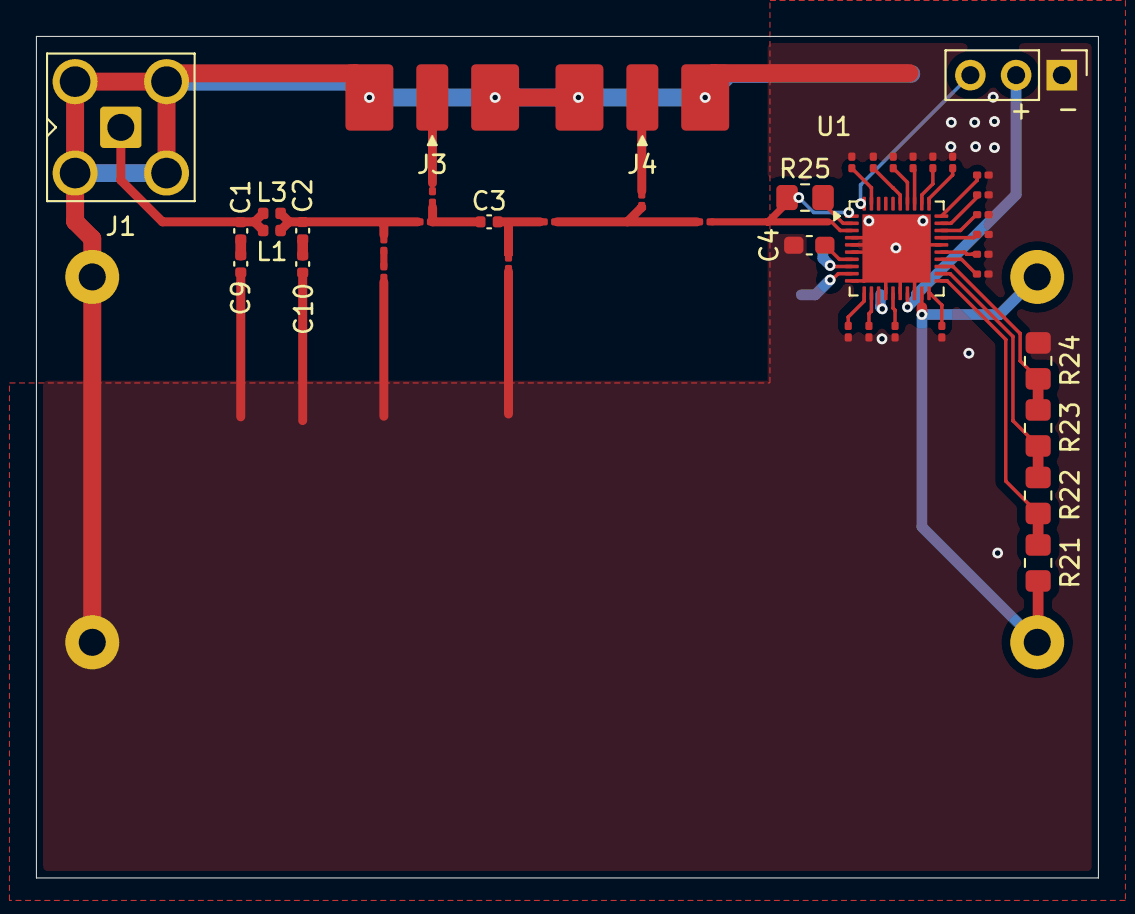
[picture p46: board power_harvester.kicad_pcb from above]

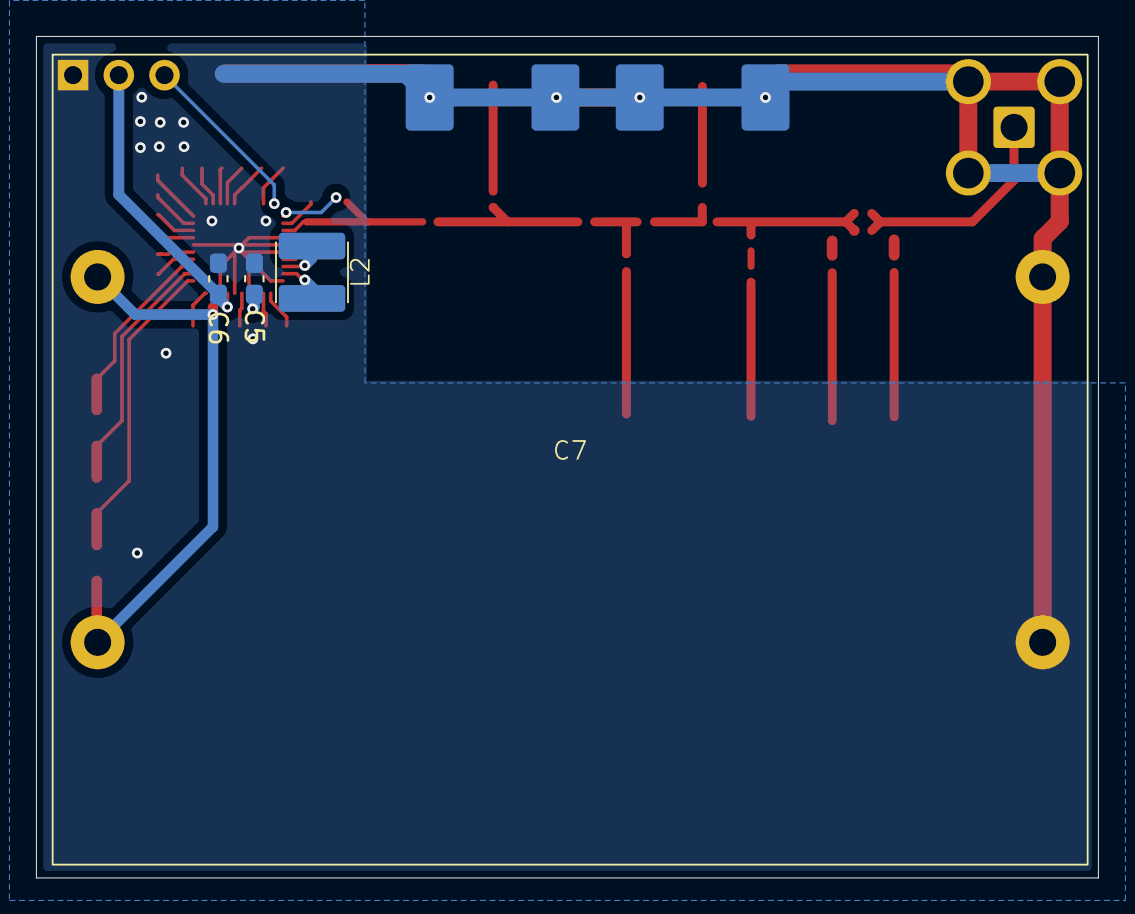
[picture p47: board power_harvester.kicad_pcb from below]

Board: 2 copper layers, 59.0 x 46.8 mm, 46 parts (4 on the bottom side), 39 nets.
