a-conspiracy-theory/jhnvrw-seniordesign/hardware/tx-pcb/v-reg/v-reg.kicad_pcb

## KiCad design hardware/tx-pcb/v-reg/v-reg.kicad_pcb (2026-09-19)

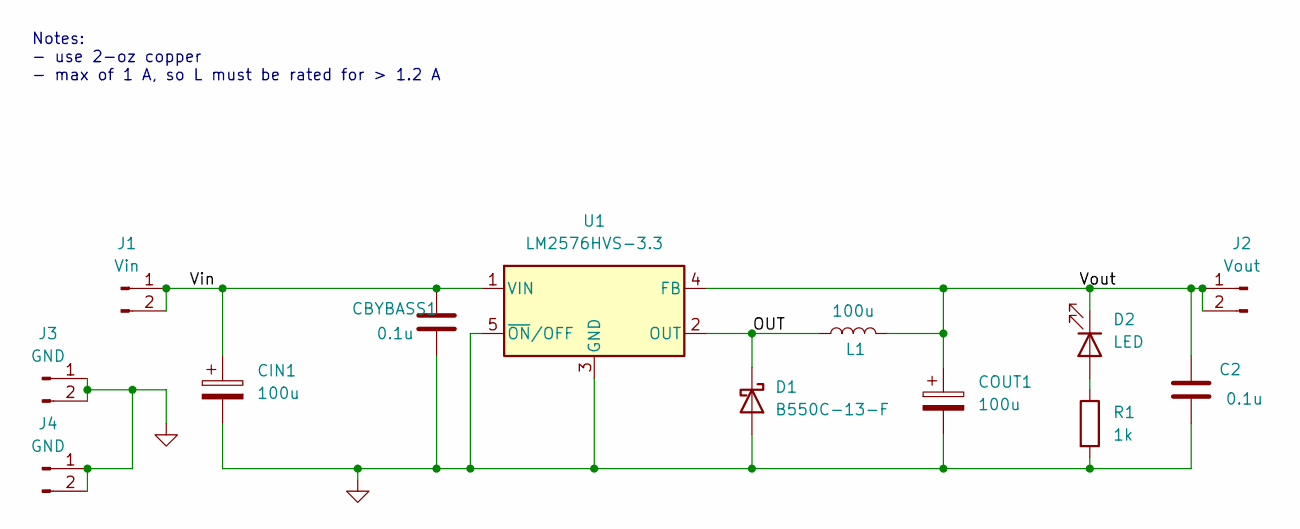
[picture p48: schematic v-reg.kicad_sch]

Parts:
C2: 0.1u; C_0805_2012Metric_Pad1.18x1.45mm_HandSolder
CBYBASS1: 0.1u; C_0805_2012Metric_Pad1.18x1.45mm_HandSolder
CIN1: 100u; CP_Radial_D8.0mm_P3.50mm
COUT1: 100u; CP_Radial_D8.0mm_P3.50mm
D1: B550C-13-F; SMC_L6.9-W5.9-LS7.9-RD
D2: LED; LED_0805_2012Metric_Pad1.15x1.40mm_HandSolder
J1: Vin; PinHeader_1x02_P2.54mm_Vertical
J2: Vout; PinHeader_1x02_P2.54mm_Vertical
J3, J4: GND; PinHeader_1x02_P2.54mm_Vertical
L1: 100u; L_Bourns_SRR1260
R1: 1k; R_0805_2012Metric_Pad1.20x1.40mm_HandSolder
U1: LM2576HVS-3.3; TO-263-5_TabPin3

Connections:
/SW: D1.1 (K), L1.1, U1.2 (OUT)
/Vin: CBYBASS1.1, CIN1.1, J1.1, J1.2, U1.1 (VIN)
/Vout: C2.1, COUT1.1, D2.1 (K), J2.1, J2.2, L1.2, U1.4 (FB); also elsewhere on the board
GND: C2.2, CBYBASS1.2, CIN1.2, COUT1.2, D1.2 (A), J3.1, J3.2, J4.1, J4.2, R1.2, U1.3 (GND), U1.5 (~ON/OFF); also elsewhere on the board
unnamed: D2.2 (A), R1.1

Notes on the sheet:
Notes: - use 2-oz copper - max of 1 A, so L must be rated for > 1.2 A

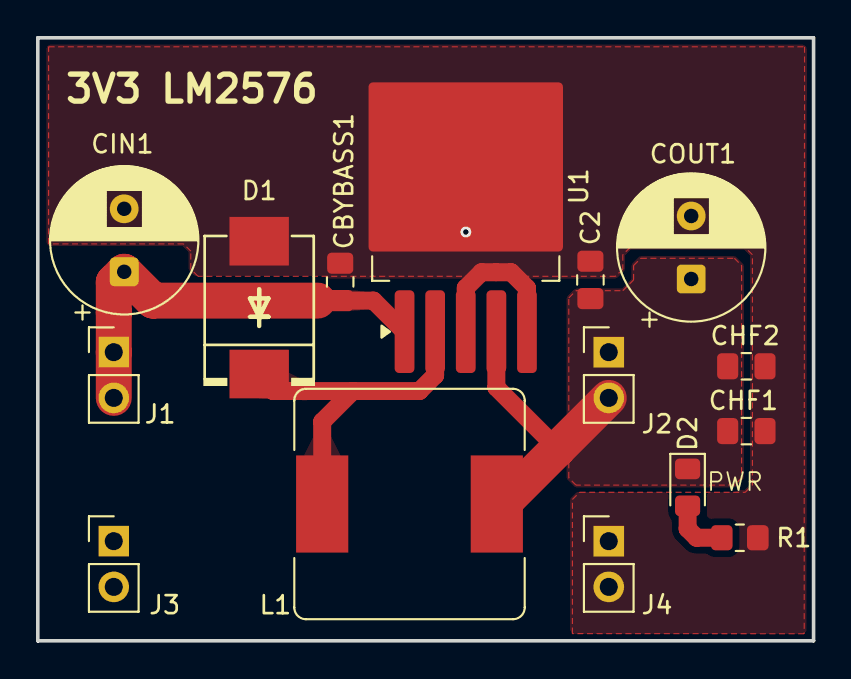
[picture p49: board v-reg.kicad_pcb from above]

Board: 2 copper layers, 43.1 x 33.5 mm, 15 parts (0 on the bottom side), 5 nets.

Other parts of the board:
CHF1, CHF2: 0.1u; C_0805_2012Metric_Pad1.18x1.45mm_HandSolder

Their connections:
/Vout: CHF1.1, CHF2.1; also elsewhere on the board
GND: CHF1.2, CHF2.2; also elsewhere on the board
