a-conspiracy-theory/jhnvrw-seniordesign/hardware/reg-pcb/reg-pcb.kicad_pcb

## KiCad design hardware/reg-pcb/reg-pcb.kicad_pcb (2026-09-14)

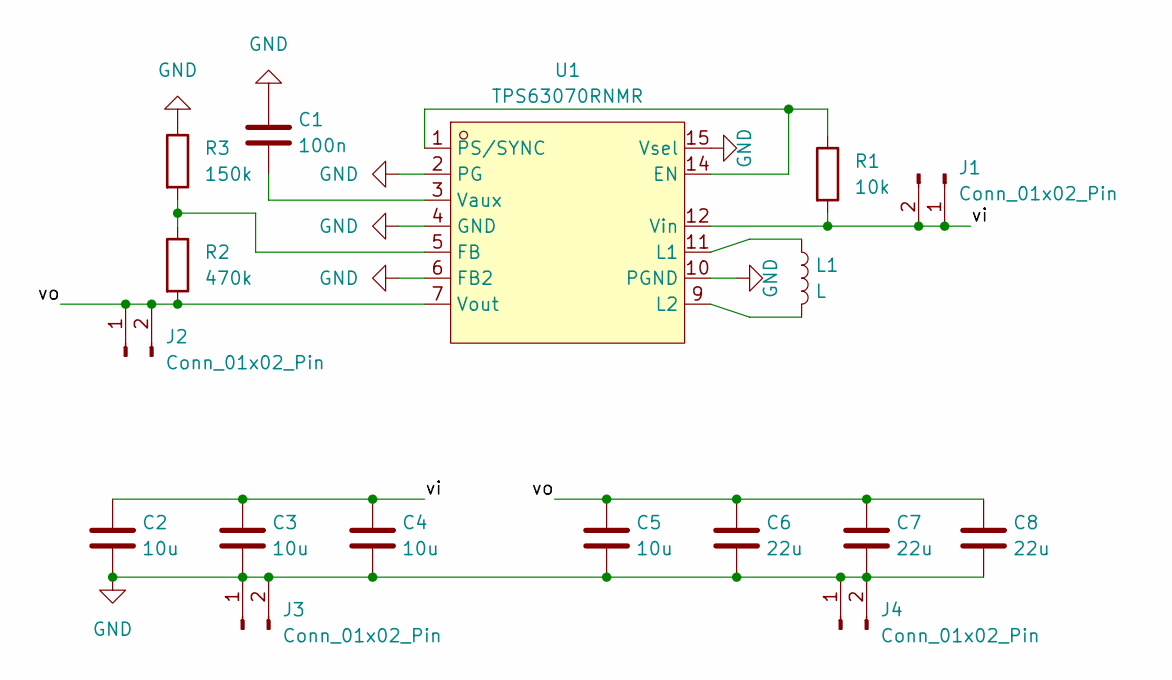
[picture p50: schematic reg-pcb.kicad_sch]

Parts:
C1: 100n; C_0805_2012Metric
C2, C3: 10u; C_0805_2012Metric_Pad1.18x1.45mm_HandSolder
C4, C5: 10u; C_0603_1608Metric_Pad1.08x0.95mm_HandSolder
C6, C7, C8: 22u; C_0805_2012Metric_Pad1.18x1.45mm_HandSolder
J1, J2, J3, J4: Conn_01x02_Pin; PinHeader_1x02_P2.54mm_Vertical
L1: L; L_Vishay_IHLP-1616
R1: 10k; R_0805_2012Metric
R2: 470k; R_0805_2012Metric
R3: 150k; R_0805_2012Metric
U1: TPS63070RNMR; VQFN-15_L3.0-W2.5-P0.50-BL; MPN TPS63070RNMR; LCSC Part C109322

Connections:
/vi: C2.1, C3.1, C4.1, J1.1, J1.2, R1.2, U1.12 (Vin)
/vo: C5.1, C6.1, C7.1, C8.1, J2.1, J2.2, R2.2, U1.7 (Vout)
GND: C1.1, C2.2, C3.2, C4.2, C5.2, C6.2, C7.2, C8.2, J3.1, J3.2, J4.1, J4.2, R3.1, U1.2 (PG), U1.4 (GND), U1.6 (FB2), U1.10 (PGND), U1.15 (Vsel)
unnamed: R1.1, U1.1 (PS/SYNC), U1.14 (EN)
unnamed: R2.1, R3.2, U1.5 (FB)
unnamed: L1.1, U1.11 (L1)
unnamed: L1.2, U1.9 (L2)
unnamed: C1.2, U1.3 (Vaux)

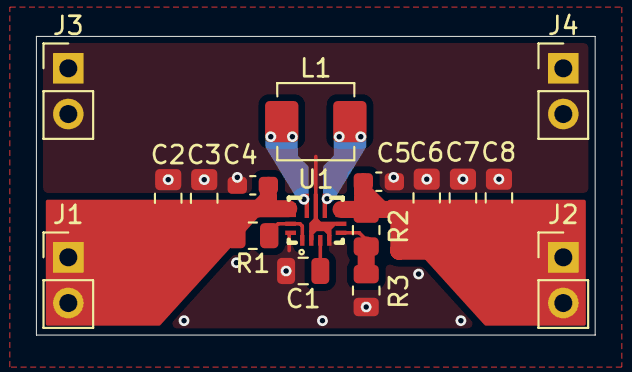
[picture p51: board reg-pcb.kicad_pcb from above]

Board: 2 copper layers, 31.0 x 16.6 mm, 17 parts (0 on the bottom side), 8 nets.
