a-conspiracy-theory/jhnvrw-seniordesign/hardware/tx-pcb/sx1262/sx1262.kicad_pcb

## KiCad design hardware/tx-pcb/sx1262/sx1262.kicad_pcb (2026-09-14)

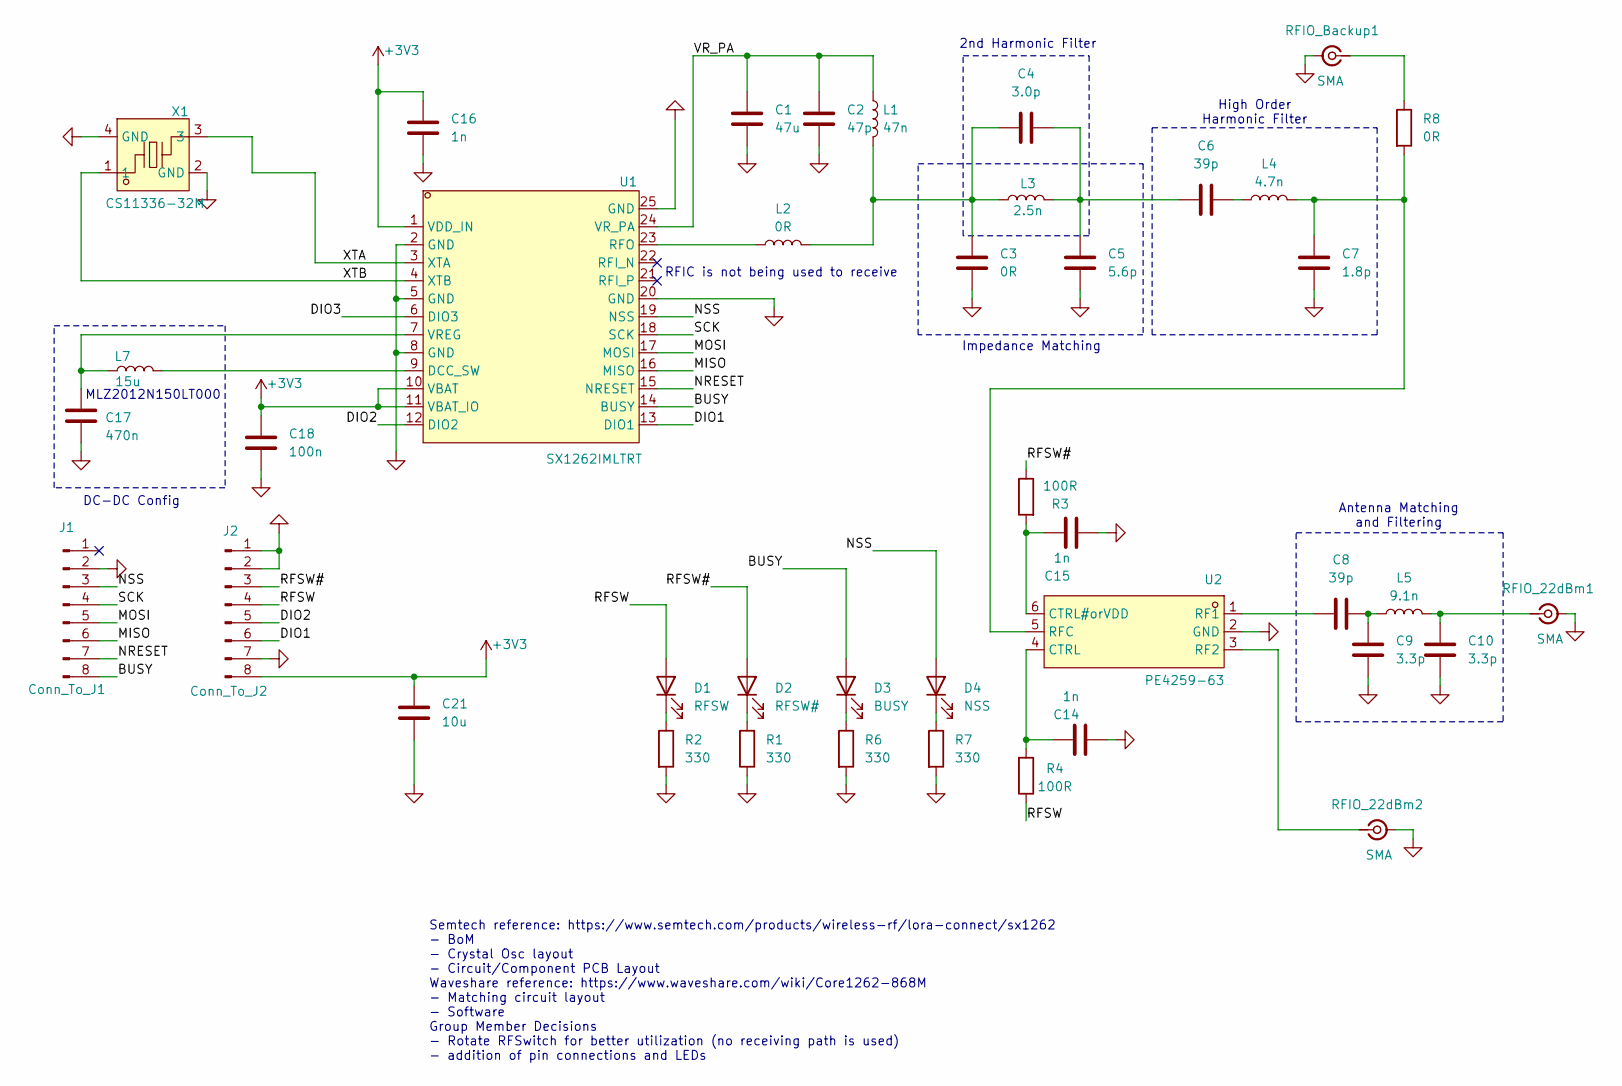
[picture p52: schematic sx1262.kicad_sch]

Parts:
C1: 47u; C_0805_2012Metric_Pad1.18x1.45mm_HandSolder
C2: 47p; C_0805_2012Metric_Pad1.18x1.45mm_HandSolder
C3: 0R; C_0805_2012Metric_Pad1.18x1.45mm_HandSolder
C4: 3.0p; C_0805_2012Metric_Pad1.18x1.45mm_HandSolder
C5: 5.6p; C_0805_2012Metric_Pad1.18x1.45mm_HandSolder
C6, C8: 39p; C_0805_2012Metric_Pad1.18x1.45mm_HandSolder
C7: 1.8p; C_0805_2012Metric_Pad1.18x1.45mm_HandSolder
C9, C10: 3.3p; C_0805_2012Metric_Pad1.18x1.45mm_HandSolder
C14, C15, C16: 1n; C_0805_2012Metric_Pad1.18x1.45mm_HandSolder
C17: 470n; C_0805_2012Metric_Pad1.18x1.45mm_HandSolder
C18: 100n; C_0805_2012Metric_Pad1.18x1.45mm_HandSolder
C21: 10u; C_0805_2012Metric_Pad1.18x1.45mm_HandSolder
D1: RFSW; LED_0805_2012Metric_Pad1.15x1.40mm_HandSolder
D2: RFSW#; LED_0805_2012Metric_Pad1.15x1.40mm_HandSolder
D3: BUSY; LED_0805_2012Metric_Pad1.15x1.40mm_HandSolder
D4: NSS; LED_0805_2012Metric_Pad1.15x1.40mm_HandSolder
J1: Conn_To_J1; PinHeader_1x08_P2.54mm_Vertical
J2: Conn_To_J2; PinHeader_1x08_P2.54mm_Vertical
L1: 47n; L_0805_2012Metric_Pad1.05x1.20mm_HandSolder
L2: 0R; L_0805_2012Metric_Pad1.05x1.20mm_HandSolder
L3: 2.5n; L_0805_2012Metric_Pad1.05x1.20mm_HandSolder
L4: 4.7n; L_0805_2012Metric_Pad1.05x1.20mm_HandSolder
L5: 9.1n; L_0805_2012Metric_Pad1.05x1.20mm_HandSolder
L7: 15u; L_0805_2012Metric_Pad1.05x1.20mm_HandSolder
R1, R2, R6, R7: 330; R_0805_2012Metric_Pad1.20x1.40mm_HandSolder
R3, R4: 100R; R_0805_2012Metric_Pad1.20x1.40mm_HandSolder
R8: 0R; R_0805_2012Metric_Pad1.20x1.40mm_HandSolder
RFIO_22dBm1, RFIO_22dBm2: SMA; SMA_Amphenol_901-143_Horizontal
RFIO_Backup1: SMA; SMA_Amphenol_901-143_Horizontal
U1: SX1262IMLTRT; QFN-24_L4.0-W4.0-P0.50-BL-EP2.6; MPN SX1262IMLTRT; LCSC Part C191341
U2: PE4259-63; SC-70-6_L2.2-W1.3-P0.65-LS2.1-BL; MPN PE4259-63; LCSC Part C470892
X1: CS11336-32M; NX2016SA_NDK; MPN Q22FA12800025; LCSC Part C187794

Connections:
+3V3: C16.1, C18.1, C21.1, J2.8, U1.1 (VDD_IN), U1.10 (VBAT), U1.11 (VBAT_IO)
/BUSY: D3.2 (A), J1.8, U1.14 (BUSY)
/DIO1: J2.6, U1.13 (DIO1)
/DIO2: J2.5, U1.12 (DIO2)
/DIO3: U1.6 (DIO3)
/MISO: J1.6, U1.16 (MISO)
/MOSI: J1.5, U1.17 (MOSI)
/NRESET: J1.7, U1.15 (NRESET)
/NSS: D4.2 (A), J1.3, U1.19 (NSS)
/RFSW: D1.2 (A), J2.4, R4.1
/RFSW#: D2.2 (A), J2.3, R3.1
/SCK: J1.4, U1.18 (SCK)
/VR_PA: C1.1, C2.1, L1.1, U1.24 (VR_PA)
/XTA: U1.3 (XTA), X1.3
/XTB: U1.4 (XTB), X1.1
GND: C1.2, C2.2, C3.2, C5.2, C7.2, C9.2, C10.2, C14.2, C15.2, C16.2, C17.2, C18.2, C21.2, J1.2, J2.1, J2.2, J2.7, R1.1, R2.2, R6.2, R7.2, RFIO_22dBm1.2 (Ext), RFIO_22dBm2.2 (Ext), RFIO_Backup1.2 (Ext), U1.2 (GND), U1.5 (GND), U1.8 (GND), U1.20 (GND), U1.25 (GND), U2.2 (GND), X1.2 (GND), X1.4 (GND)
unnamed: C3.1, C4.1, L1.2, L2.2, L3.1
unnamed: C4.2, C5.1, C6.1, L3.2
unnamed: C6.2, L4.1
unnamed: C8.2, C9.1, L5.1
unnamed: D1.1 (K), R2.1
unnamed: D2.1 (K), R1.2
unnamed: D3.1 (K), R6.1
unnamed: D4.1 (K), R7.1
unnamed: C10.1, L5.2, RFIO_22dBm1.1 (In)
unnamed: RFIO_22dBm2.1 (In), U2.3 (RF2)
unnamed: R8.1, RFIO_Backup1.1 (In)
unnamed: L7.2, U1.9 (DCC_SW)
unnamed: L2.1, U1.23 (RFO)
unnamed: C17.1, L7.1, U1.7 (VREG)
unnamed: C15.1, R3.2, U2.6 (CTRL#orVDD)
unnamed: C14.1, R4.2, U2.4 (CTRL)
unnamed: C8.1, U2.1 (RF1)
unnamed: C7.1, L4.2, R8.2, U2.5 (RFC)

Notes on the sheet:
RFIC is not being used to receive
MLZ2012N150LT000
High Order Harmonic Filter
2nd Harmonic Filter
DC-DC Config
Antenna Matching and Filtering
Impedance Matching
Semtech reference: https://www.semtech.com/products/wireless-rf/lora-connect/sx1262 - BoM - Crystal Osc layout - Circuit/Component PCB Layout Waveshare reference: https://www.waveshare.com/wiki/Core1262-868M - Matching circuit layout - Software Group Member Decisions - Rotate RFSwitch for better ut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

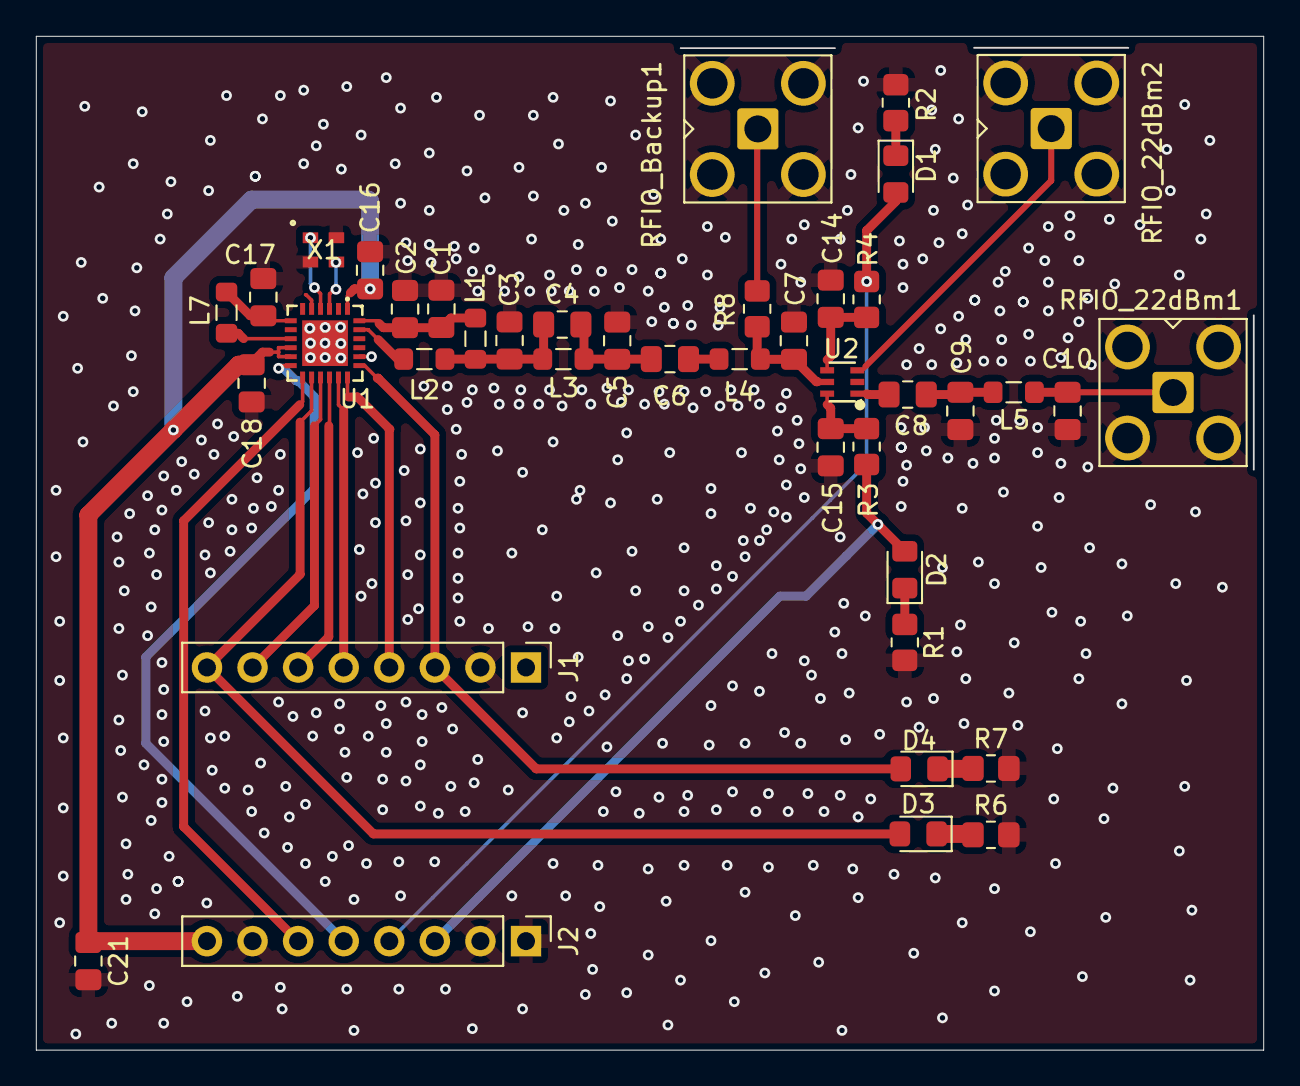
[picture p53: board sx1262.kicad_pcb from above]

Board: 4 copper layers, 68.4 x 56.5 mm, 41 parts (0 on the bottom side), 33 nets.
