a-conspiracy-theory/jhnvrw-seniordesign/hardware/tx-pcb/rf-pwr-tx/rf-pwr-tx.kicad_pcb

## KiCad design hardware/tx-pcb/rf-pwr-tx/rf-pwr-tx.kicad_pcb (2026-06-26)

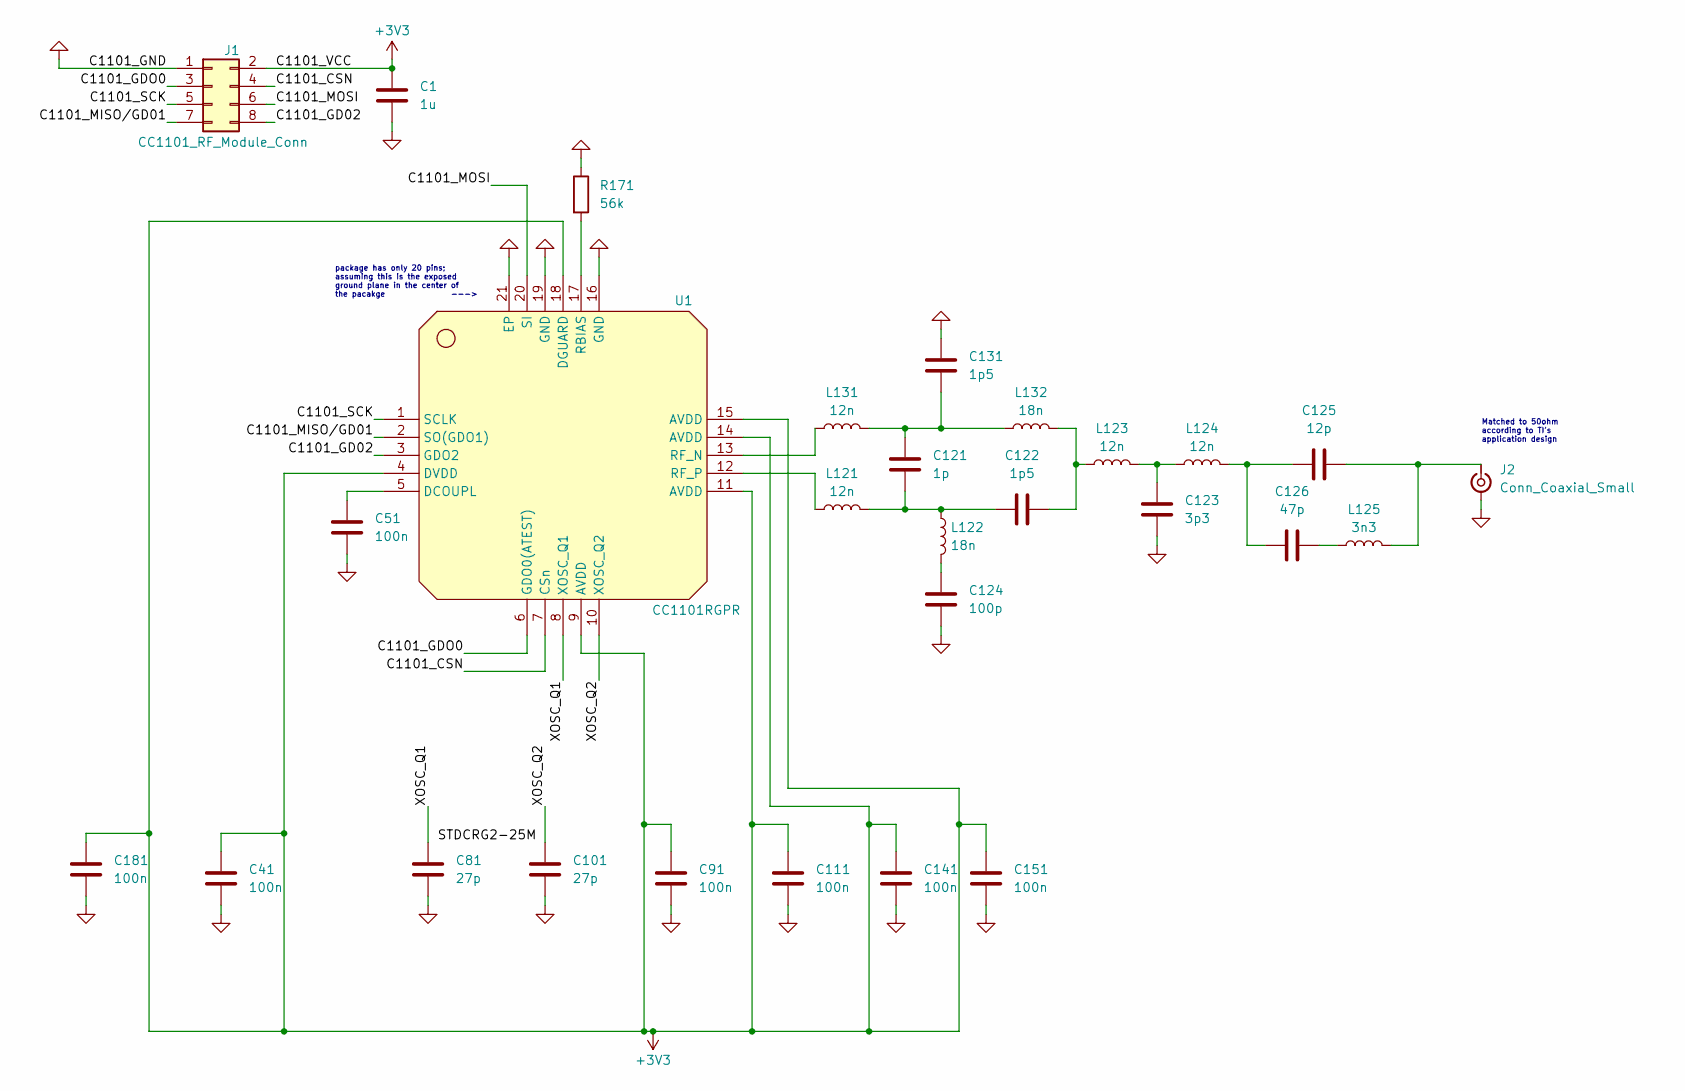
[picture p54: schematic rf-pwr-tx.kicad_sch]

Parts:
C1: 1u; C_0402_1005Metric_Pad0.74x0.62mm_HandSolder
C41, C51, C91, C111, C141, C151, C181: 100n; C_0402_1005Metric_Pad0.74x0.62mm_HandSolder
C81, C101: 27p; C_0402_1005Metric_Pad0.74x0.62mm_HandSolder
C121: 1p; C_0402_1005Metric_Pad0.74x0.62mm_HandSolder
C122, C131: 1p5; C_0402_1005Metric_Pad0.74x0.62mm_HandSolder
C123: 3p3; C_0402_1005Metric_Pad0.74x0.62mm_HandSolder
C124: 100p; C_0402_1005Metric_Pad0.74x0.62mm_HandSolder
C125: 12p; C_0402_1005Metric_Pad0.74x0.62mm_HandSolder
C126: 47p; C_0402_1005Metric_Pad0.74x0.62mm_HandSolder
J1: CC1101_RF_Module_Conn; PinSocket_2x04_P2.54mm_Vertical
J2: Conn_Coaxial_Small; SMA_Amphenol_901-143_Horizontal
L121, L123, L124, L131: 12n; L_0402_1005Metric_Pad0.77x0.64mm_HandSolder
L122, L132: 18n; L_0402_1005Metric_Pad0.77x0.64mm_HandSolder
L125: 3n3; L_0402_1005Metric_Pad0.77x0.64mm_HandSolder
R171: 56k; R_0402_1005Metric_Pad0.72x0.64mm_HandSolder
U1: CC1101RGPR; RGP20_2P4X2P4; MPN CC1101RGPR; LCSC Part C29953

Connections:
+3V3: C1.1, C41.1, C91.1, C111.1, C141.1, C151.1, C181.1, J1.2, U1.4 (DVDD), U1.9 (AVDD), U1.11 (AVDD), U1.14 (AVDD), U1.15 (AVDD), U1.18 (DGUARD)
/C1101_CSN: J1.4, U1.7 (CSn)
/C1101_GD02: J1.8, U1.3 (GDO2)
/C1101_GDO0: J1.3, U1.6 (GDO0(ATEST))
/C1101_MISO/GD01: J1.7, U1.2 (SO(GDO1))
/C1101_MOSI: J1.6, U1.20 (SI)
/C1101_SCK: J1.5, U1.1 (SCLK)
/XOSC_Q1: C81.1, U1.8 (XOSC_Q1)
/XOSC_Q2: C101.1, U1.10 (XOSC_Q2)
GND: C1.2, C41.2, C51.2, C81.2, C91.2, C101.2, C111.2, C123.1, C124.2, C131.1, C141.2, C151.2, C181.2, J1.1, J2.2 (Ext), R171.1, U1.16 (GND), U1.19 (GND), U1.21 (EP)
unnamed: C121.1, C131.2, L131.2, L132.1
unnamed: C121.2, C122.1, L121.2, L122.1
unnamed: C122.2, L123.1, L132.2
unnamed: C123.2, L123.2, L124.1
unnamed: C124.1, L122.2
unnamed: C125.1, C126.1, L124.2
unnamed: C126.2, L125.1
unnamed: C125.2, J2.1 (In), L125.2
unnamed: C51.1, U1.5 (DCOUPL)
unnamed: R171.2, U1.17 (RBIAS)
unnamed: L131.1, U1.13 (RF_N)
unnamed: L121.1, U1.12 (RF_P)

Notes on the sheet:
Matched to 50ohm according to TI's application design
package has only 20 pins; assuming this is the exposed ground plane in the center of the pacakge --->

Board: 2 copper layers, 28 parts (0 on the bottom side), 22 nets, no tracks yet.
