a-conspiracy-theory/jhnvrw-seniordesign/hardware/tx-pcb/reference-designs/TI_REF_CC1101_with_CC1190/TI_REF_CC1101_with_CC1190.kicad_pcb

## KiCad design hardware/tx-pcb/reference-designs/TI_REF_CC1101_with_CC1190/TI_REF_CC1101_with_CC1190.kicad_pcb (2026-06-26)

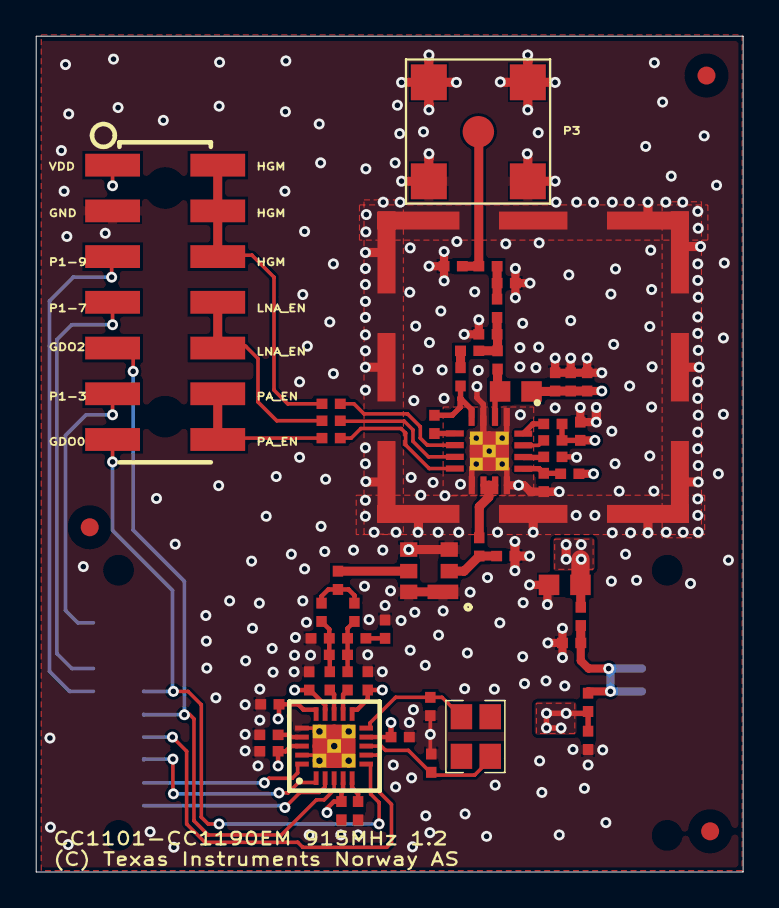
[picture p55: board TI_REF_CC1101_with_CC1190.kicad_pcb from above]

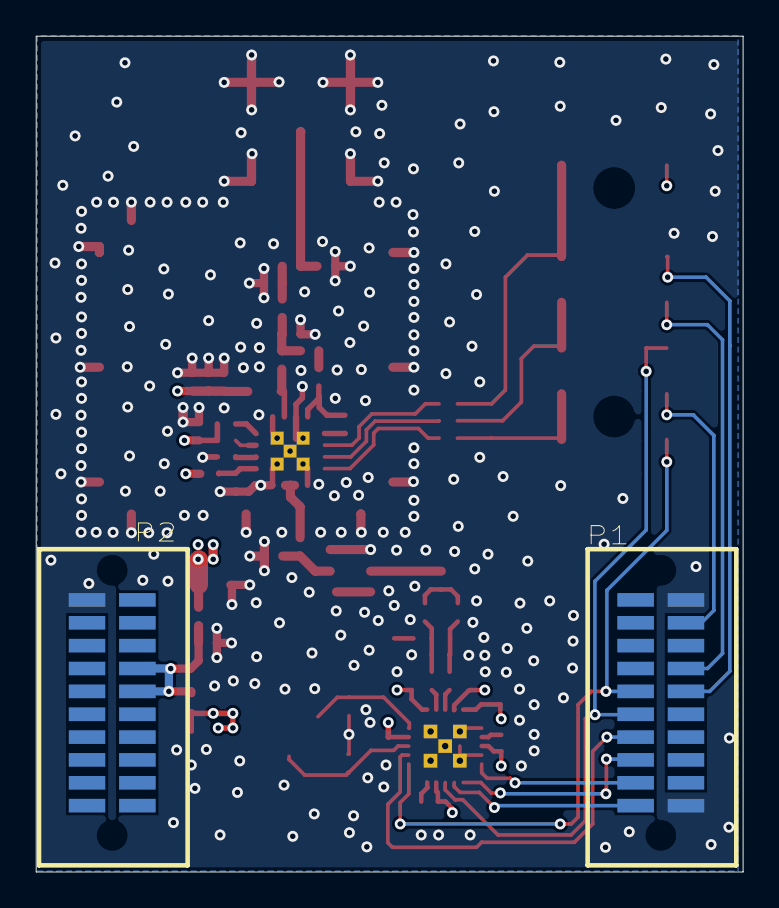
[picture p56: board TI_REF_CC1101_with_CC1190.kicad_pcb from below]

Board: 4 copper layers, 39.3 x 46.4 mm, 60 parts (2 on the bottom side), 43 nets.

Parts:
C1, C30: C_1U_0402_X5R_K_6P3; 0402 (REFLOW LF)
C2: C_10U_0603_X5R_M_4; 0603 (REFLOW)
C3: C_220P_0402_NP0_J_50; 0402 (REFLOW LF)
C21, C26, C123: C_47P_0402_NP0_J_50; 0402 (REFLOW LF)
C22, C52, C81: C_12P_0402_NP0_J_50; 0402 (REFLOW LF)
C24: C_3P3_0402_NP0_C_50; 0402 (REFLOW LF)
C25: C_7P5_0402_NP0_C_50; 0402 (REFLOW LF)
C27: C_1N_0402_NP0_J_50; 0402 (REFLOW LF)
C28: C_0402; 0402 (REFLOW LF)
C41, C51, C91, C111, C141, C151, C181: C_100N_0402_X5R_K_10; 0402 (REFLOW LF)
C101, C132: C_15P_0402_NP0_J_50; 0402 (REFLOW LF)
C121: C_1P0_0402_NP0_C_50; 0402 (REFLOW LF)
C122, C131: C_1P5_0402_NP0_C_50; 0402 (REFLOW LF)
C124: C_100P_0402_NP0_J_50; 0402 (REFLOW LF)
C125: C_0P8_0402_NP0_B_50; 0402 (REFLOW LF)
C161: C_27P_0402_NP0_J_50; 0402 (REFLOW LF)
FM1, FM2, FM3: FIDUCIAL_MARK_1MM; FIDUCAL_MARK_1mm
L1: L_BEAD_102_0402; 0402 (REFLOW LF)
L2: L_11N_0402_J_LQW; 0402 (REFLOW LF)
L21: L_22N_0603_J_LQW; 0603 (REFLOW)
L22: L_7N5_0402_G_LQW; 0402 (REFLOW LF)
L23: L_2N9_0402_B_LQW; 0402 (REFLOW LF)
L24: L_9N1_0402_G_LQW; 0402 (REFLOW LF)
L25: L_10N_0402_G_LQW; 0402 (REFLOW LF)
L121, L131: L_12N_0402_J_LQW; 0402 (REFLOW LF)
L122, L132: L_18N_0402_J_LQW; 0402 (REFLOW LF)
L130: L_1N5_0402_S; 0402 (REFLOW LF)
P1, P2: SMD_SOCKET_2X10; SFM SMD Socket 2x10
P3: SMA_SMD; SMA_SMD (Note_recommended)
P4: PINROW_SMD_2X7_2.54MM_PEG; PINROW_SMD_2X7_2.54MM_PEG (Gradconn BB02-HP)
P5: SHIELD BMIS-202; Shield_BMIS-202
R3, R4, R5: R_10K_0402_F; 0402 (REFLOW LF)
R141: R_3K3_0402_F; 0402 (REFLOW LF)
R151: R_47_0402_G; 0402 (REFLOW LF)
R161: R_10_0402_G; 0402 (REFLOW LF)
R171: R_56K_0402_F; 0402 (REFLOW LF)
U1: CC1101; QLP20_DATASHEET (QLP20)
U2: CC1190_DATASHEET; QFN16_4_4_DATASHEET (CC1190)
U3: EPCOS_B3588; Epcos_B3588
X1: X_26.000/20/40/40/10; XTAL_SMD_3_2x2_5 (3.2 x 2.5 mm)

Connections:
CSn: P1.14, U1.7
GDO0: P1.10, P4.13, U1.6
GDO2: P1.12, P4.9, U1.3
GND: C1.2, C2.2, C3.2, C24.1, C25.1, C26.2, C27.2, C28.1, C30.2, C41.2, C51.2, C81.2, C91.2, C101.2, C111.2, C124.1, C125.1, C131.2, C132.2, C141.2, C151.2, C161.2, C181.2, P1.1, P1.19, P2.2, P3.2, P3.3, P3.4, P3.5, P4.3, P5.1, P5.2, P5.3, P5.4, P5.5, P5.6, P5.7, P5.8, P5.9, P5.10, P5.11, P5.12, R141.1, R171.2, U1.16, U1.19, U1.21, U1.22, U1.23, U1.24, U1.25, U1.26, U1.27, U1.28, U2.1, U2.3, U2.9, U2.12, U2.17, U2.18, U2.19, U2.20, U2.21, U2.22, U2.23, U2.24, U3.1, U3.3, U3.4, U3.6
HGM: R3.2, U2.6
LNA_EN: R4.2, U2.7
unnamed: C21.2, C24.2, L22.2, L23.2
unnamed: C22.2, L22.1
unnamed: C52.1, U2.5
unnamed: C22.1, C52.2, U2.4
unnamed: C101.1, U1.10, X1.3
unnamed: C122.2, C123.1, L132.1
unnamed: C124.2, L122.2
unnamed: C125.2, L25.1, U3.2
unnamed: C121.2, C131.1, L131.2, L132.2
unnamed: C28.2, L24.1, P3.1
unnamed: C25.2, L23.1, L24.2
unnamed: L25.2, U2.10, U2.11
unnamed: C121.1, C122.1, L121.2, L122.1
unnamed: P1.3, P4.11
unnamed: P1.7, P4.7
unnamed: P1.9, P4.5
unnamed: P4.2, P4.4, P4.6, R3.1
unnamed: P4.12, P4.14, R5.1
unnamed: P4.8, P4.10, R4.1
unnamed: R141.2, U2.14
unnamed: R151.2, U2.15
unnamed: R161.2, U2.16
unnamed: R171.1, U1.17
unnamed: C51.1, U1.5
unnamed: L121.1, U1.12
unnamed: L131.1, U1.13
unnamed: C21.1, L21.1, U2.2
unnamed: C132.1, L130.1, U2.13
unnamed: C123.2, U3.5
unnamed: C81.1, U1.8, X1.1
PA_EN: R5.2, U2.8
SCLK: P1.16, U1.1
SI: P1.18, U1.20
SO: P1.20, U1.2
VDD: C3.1, L1.2, L2.1, P2.7, P2.9
VDD_CC1101: C1.1, C41.1, C91.1, C111.1, C141.1, C151.1, C181.1, L1.1, U1.4, U1.9, U1.11, U1.14, U1.15, U1.18
VDD_CC1190: C2.1, C26.1, C27.1, C30.1, C161.1, L2.2, L21.2, L130.2, P4.1, R151.1, R161.1
