a-conspiracy-theory/jhnvrw-seniordesign/hardware/tx-pcb/sx1262adapter/1262adapt/1262adapt.kicad_pcb

## KiCad design hardware/tx-pcb/sx1262adapter/1262adapt/1262adapt.kicad_pcb (2026-10-21)

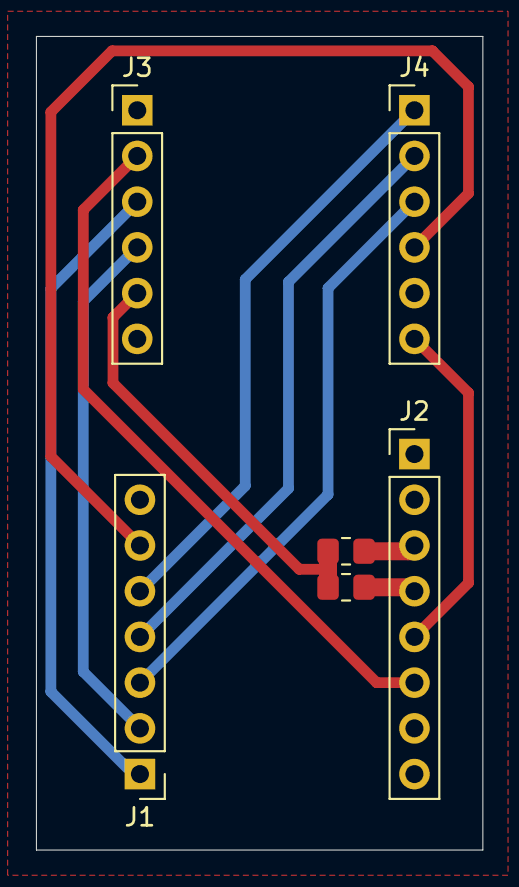
[picture p57: board 1262adapt.kicad_pcb from above]

Board: 2 copper layers, 24.8 x 45.2 mm, 6 parts (0 on the bottom side), 12 nets.

Parts:
J1: Conn_To_J1; PinHeader_1x07_P2.54mm_Vertical
J2: Conn_To_J2; PinHeader_1x08_P2.54mm_Vertical
J3, J4: Conn_01x06; PinHeader_1x06_P2.54mm_Vertical
R1, R2: R; R_0805_2012Metric_Pad1.20x1.40mm_HandSolder

Connections:
/SPI_MISO: J1.3, J4.3
/SPI_MOSI: J1.4, J4.2
/SPI_SCK: J1.5, J4.1
/SX1262_BUSY: J1.1, J3.3
/SX1262_DIO1: J2.6, J3.2
/SX1262_DIO2: J2.5, J4.6
/SX1262_NSS: J1.6, J4.4
/SX1262_RFSW: J2.4, R1.1
/SX1262_RFSW#: J2.3, R2.2
/SX1262_RFSW_EN: J3.5, R1.2, R2.1
/SX1262_RST: J1.2, J3.4
GND: J1.7, J2.1, J2.2, J2.7, J4.5
