a-conspiracy-theory/jhnvrw-seniordesign/software/WB55/BLE_p2pClient/Core/Src/main.c

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
/* Includes ------------------------------------------------------------------*/
#include "main.h"

/* USER CODE BEGIN Includes */
#include "ssd1306.h"
#include "bitmap.h"
#include "fonts.h"
#include "app_ble.h"
#include <stdio.h>

//#include "sx126x.h"
/* USER CODE END Includes */

I2C_HandleTypeDef hi2c1;

IPCC_HandleTypeDef hipcc;

RTC_HandleTypeDef hrtc;

SPI_HandleTypeDef hspi1;

TIM_HandleTypeDef htim1;

UART_HandleTypeDef huart1;
DMA_HandleTypeDef hdma_usart1_tx;

void SystemClock_Config(void);
void PeriphCommonClock_Config(void);
static void MX_GPIO_Init(void);
static void MX_DMA_Init(void);
static void MX_RTC_Init(void);
static void MX_IPCC_Init(void);
static void MX_I2C1_Init(void);
static void MX_TIM1_Init(void);
static void MX_SPI1_Init(void);
static void MX_RF_Init(void);
/* USER CODE BEGIN PFP */

void APP_BLE_Get_Eddystone_TLM(Eddystone_TLM_Data_t *data);
void Write_TO_OLED();
/* USER CODE END PFP */

/* USER CODE BEGIN 0 */
Eddystone_TLM_Data_t tlm_data;
char oled_buffer[24];
/* USER CODE END 0 */

/**
  * @brief  The application entry point.
  * @retval int
  */
int main(void)
{

  /* MCU Configuration--------------------------------------------------------*/

  /* Reset of all peripherals, Initializes the Flash interface and the Systick. */
  HAL_Init();
  /* Config code for STM32_WPAN (HSE Tuning must be done before system clock configuration) */
  MX_APPE_Config();

  /* Configure the system clock */
  SystemClock_Config();

  /* Configure the peripherals common clocks */
  PeriphCommonClock_Config();

  /* IPCC initialisation */
  MX_IPCC_Init();

  /* Initialize all configured peripherals */
  MX_GPIO_Init();
  MX_DMA_Init();
  MX_RTC_Init();
  MX_I2C1_Init();
  MX_TIM1_Init();
  MX_SPI1_Init();
  MX_RF_Init();
  /* USER CODE BEGIN 2 */

  SSD1306_Init();
  SSD1306_Clear();
  SSD1306_GotoXY(0, 0);
  SSD1306_Puts("Waiting for TLM...", &Font_7x10, 1);
  SSD1306_UpdateScreen();

//  setup_22dBm_Tx(NULL);		//as the name suggests
//  rfswitch_Tx(NULL);		//configure the RF switch for TX
  /* USER CODE END 2 */

  /* Init code for STM32_WPAN */
  MX_APPE_Init();

  /* Infinite loop */
  /* USER CODE BEGIN WHILE */
  uint32_t myDelayTimestamp = 0;
  const uint32_t DELAY_INTERVAL = 5000; // Delay duration in milliseconds (e.g., 1 second)
  uint8_t delayStarted = 0;

  while(1)
  {

    /* USER CODE END WHILE */
    MX_APPE_Process();

    /* USER CODE BEGIN 3 */
    //static uint32_t last_adv_count = 0xFFFFFFFFU;
    APP_BLE_Get_Eddystone_TLM(&tlm_data);
    if (!delayStarted)
       {
         myDelayTimestamp = HAL_GetTick(); // Start the "stopwatch"
         delayStarted = 1;
       }

        /* Update the OLED only when a new TLM packet has been received. */
        if (tlm_data.valid && (delayStarted && (HAL_GetTick() - myDelayTimestamp >= DELAY_INTERVAL)))
        {
          //last_adv_count = tlm_data.adv_count;
        	Write_TO_OLED();

        	delayStarted = 0;

        }

        else if(!tlm_data.valid && (delayStarted && (HAL_GetTick() - myDelayTimestamp >= DELAY_INTERVAL))){

        	  SSD1306_Clear();
        	  SSD1306_GotoXY(0, 0);

        	  SSD1306_Puts("SCAN DISABLED", &Font_7x10, 1);
        	  SSD1306_UpdateScreen();

        	  delayStarted = 0;
        }

        // Time Delay means BLE Delay not good, minimize
  }
  /* USER CODE END 3 */
}

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
/* USER CODE BEGIN 4 */
void Write_TO_OLED() {
	float temperature_c;
	float humidity_percent;

	/*
	 * Convert raw SHT41 temperature to Celsius
	 *
	 * T = -45 + 175 * (raw / 65535)
	 */
	temperature_c = -45.0f
			+ (175.0f * ((float) tlm_data.temperature_raw / 65535.0f));

	/*
	 * Convert raw SHT41 humidity to %RH
	 *
	 * RH = -6 + 125 * (raw / 65535)
	 */
	humidity_percent = -6.0f
			+ (125.0f * ((float) tlm_data.battery_mv / 65535.0f));

	/*
	 * Limit humidity to the valid range
	 */
	if (humidity_percent < 0.0f) {
		humidity_percent = 0.0f;
	}

	if (humidity_percent > 100.0f) {
		humidity_percent = 100.0f;
	}

	/*
	 * Display temperature
	 *
	 * Using %.1f gives one decimal place.
	 */
	snprintf(oled_buffer, sizeof(oled_buffer), "TEMP: %.1f C", temperature_c);

	SSD1306_Clear();

	SSD1306_GotoXY(0, 0);
	SSD1306_Puts("EDDYSTONE TLM", &Font_7x10, 1);

	SSD1306_GotoXY(0, 14);
	SSD1306_Puts(oled_buffer, &Font_7x10, 1);

	/*
	 * Display humidity
	 */
	snprintf(oled_buffer, sizeof(oled_buffer), "HUM: %.1f %%",
			humidity_percent);

	SSD1306_GotoXY(0, 27);
	SSD1306_Puts(oled_buffer, &Font_7x10, 1);

	/*
	 * Display raw temperature for debugging
	 */
	snprintf(oled_buffer, sizeof(oled_buffer), "TRAW: %u",
			(unsigned int) tlm_data.temperature_raw);

	SSD1306_GotoXY(0, 40);
	SSD1306_Puts(oled_buffer, &Font_7x10, 1);

	/*
	 * Display raw humidity for debugging
	 */
	snprintf(oled_buffer, sizeof(oled_buffer), "HRAW: %u",
			(unsigned int) tlm_data.battery_mv);

	SSD1306_GotoXY(0, 53);
	SSD1306_Puts(oled_buffer, &Font_7x10, 1);

	SSD1306_UpdateScreen();

}
/* USER CODE END 4 */
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
