a-conspiracy-theory/jhnvrw-seniordesign/software/WB55/BLE_p2pClient/BLE_p2pClient.ioc

Mcu.UserName=STM32WB55RGVx
PA11.Signal=USB_DM
PA12.Signal=USB_DP
PA13.Signal=SYS_JTMS-SWDIO
PA14.Signal=SYS_JTCK-SWCLK
PA2.GPIO_Label=SX1262_TXEN
PA2.Signal=GPIO_Output
PA3.GPIO_Label=SX1262_BUSY
PA3.Signal=GPIO_Input
PA4.GPIO_Label=SX1262_NSS
PA4.Signal=GPIO_Output
PA5.Signal=SPI1_SCK
PA6.Signal=SPI1_MISO
PA7.Signal=SPI1_MOSI
PA8.GPIO_Label=SX1262_DIO1
PA8.Signal=GPXTI8
PA9.GPIO_Label=SX1262_RST
PA9.Signal=GPIO_Output
PB3.Signal=GPIO_Output
PB4.Signal=GPIO_Output
PB6.Signal=USART1_TX
PB7.Signal=USART1_RX
PB8.Signal=I2C1_SCL
PB9.Signal=I2C1_SDA
PC14-OSC32_IN.Signal=RCC_OSC32_IN
PC15-OSC32_OUT.Signal=RCC_OSC32_OUT
PC6.GPIO_Label=SX1262_RXEN
PC6.Signal=GPIO_Output
PH3-BOOT0.Signal=EVENTOUT
