a-conspiracy-theory/jhnvrw-seniordesign/software/WB05/BLE_Beacon/Core/Src/main.c

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
/* Includes ------------------------------------------------------------------*/
#include "main.h"

/* USER CODE BEGIN Includes */
#include "ssd1306.h"
#include "fonts.h"
#include "bitmap.h"
#include <stdio.h>
#include "eddystone_tlm_service.h"
/* USER CODE END Includes */

ADC_HandleTypeDef hadc1;

I2C_HandleTypeDef hi2c1;

PKA_HandleTypeDef hpka;

RTC_HandleTypeDef hrtc;

TIM_HandleTypeDef htim2;

void SystemClock_Config(void);
void PeriphCommonClock_Config(void);
static void MX_GPIO_Init(void);
static void MX_RADIO_Init(void);
static void MX_RADIO_TIMER_Init(void);
static void MX_PKA_Init(void);
static void MX_ADC1_Init(void);
static void MX_I2C1_Init(void);
static void MX_RTC_Init(void);
static void MX_TIM2_Init(void);
/* USER CODE BEGIN PFP */
void SHT41_Read_Data(void);
/* USER CODE END PFP */

/* USER CODE BEGIN 0 */
#define SHT41_ADDRESS     (0x44 << 1) // 0x88 (8-bit shifted address)
#define SHT41_MEASURE_CMD 0xFD        // High precision measurement command

uint16_t raw_temperature = 0;
uint16_t raw_humidity = 0;


char oled_buffer[32];
/* USER CODE END 0 */

/**
  * @brief  The application entry point.
  * @retval int
  */
int main(void)
{

  /* MCU Configuration--------------------------------------------------------*/

  /* Reset of all peripherals, Initializes the Flash interface and the Systick. */
  HAL_Init();

  /* Configure the system clock */
  SystemClock_Config();

  /* Configure the peripherals common clocks */
  PeriphCommonClock_Config();

  /* Initialize all configured peripherals */
  MX_GPIO_Init();
  MX_RADIO_Init();
  MX_RADIO_TIMER_Init();
  MX_PKA_Init();
  MX_ADC1_Init();
  MX_I2C1_Init();
  MX_RTC_Init();
  MX_TIM2_Init();
  /* USER CODE BEGIN 2 */
  SSD1306_Init();
  HAL_GPIO_TogglePin(GPIOA, GPIO_PIN_9);
  /* USER CODE END 2 */

  /* Init code for STM32_BLE */
  MX_APPE_Init(NULL);

  /* Infinite loop */
  /* USER CODE BEGIN WHILE */
  uint32_t myDelayTimestamp = 0;
  const uint32_t DELAY_INTERVAL = 5000; // Delay duration in milliseconds (e.g., 1 second)
  uint8_t delayStarted = 0;

  while (1)
  {

	  SHT41_Read_Data();

	  if (!delayStarted)
	        {
	          myDelayTimestamp = HAL_GetTick(); // Start the "stopwatch"
	          delayStarted = 1;
	        }

	  if (delayStarted && (HAL_GetTick() - myDelayTimestamp >= DELAY_INTERVAL))
		  {
		  // Display RAW sensor values
		  snprintf(oled_buffer, sizeof(oled_buffer), "TEMP RAW: %u", raw_temperature);

		  SSD1306_GotoXY(10, 15);
		  SSD1306_Puts(oled_buffer, &Font_7x10, 1);

		  snprintf(oled_buffer, sizeof(oled_buffer), "HUM RAW: %u", raw_humidity);

		  SSD1306_GotoXY(10, 35);
		  SSD1306_Puts(oled_buffer, &Font_7x10, 1);

		  SSD1306_UpdateScreen();

		  // Send RAW 16-bit values to Eddystone TLM
		  EddystoneTLM_Process(raw_temperature, raw_humidity);

		  delayStarted = 0;
		}

    /* USER CODE END WHILE */
    MX_APPE_Process();

    /* USER CODE BEGIN 3 */
  }
  /* USER CODE END 3 */
}

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
/* USER CODE BEGIN 4 */
void SHT41_Read_Data(void)
{
    uint8_t cmd = SHT41_MEASURE_CMD;
    uint8_t rx_buf[6] = {0};

    // 1. Send the measurement command to the sensor
    if (HAL_I2C_Master_Transmit(&hi2c1, SHT41_ADDRESS, &cmd, 1, HAL_MAX_DELAY) != HAL_OK)
    {
        // Handle transmission error
        return;
    }

    // 2. Wait for the measurement conversion to finish (Max 8.2ms for high precision)
    HAL_Delay(10);

    // 3. Read 6 bytes of data back from the sensor
    if (HAL_I2C_Master_Receive(&hi2c1, SHT41_ADDRESS, rx_buf, 6, HAL_MAX_DELAY) != HAL_OK)
    {
        // Handle reception error
        return;
    }

    // 4. Convert raw data to physical values
    raw_temperature = (rx_buf[0] << 8) | rx_buf[1];
    raw_humidity  = (rx_buf[3] << 8) | rx_buf[4];

//    // Sensirion SHT4x mathematical conversion formulas
//    temperature = -45.0f + 175.0f * ((float)raw_temp / 65535.0f);
//    humidity = -6.0f + 125.0f * ((float)raw_hum / 65535.0f);
//
//    // Optional: Clamp humidity between 0% and 100%
//    if (humidity < 0.0f) humidity = 0.0f;
//    if (humidity > 100.0f) humidity = 100.0f;
}

/* USER CODE END 4 */
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
