a-conspiracy-theory/jhnvrw-seniordesign/software/WB55/PCB_SW/Full_SW_Integration/Core/Inc/main.h

#define SX1262_DIO1_Pin GPIO_PIN_0
#define SX1262_DIO1_GPIO_Port GPIOA
#define SX1262_DIO1_EXTI_IRQn EXTI0_IRQn
#define SX1262_BUSY_Pin GPIO_PIN_2
#define SX1262_BUSY_GPIO_Port GPIOA
#define SX1262_DIO2_CPS_Pin GPIO_PIN_3
#define SX1262_DIO2_CPS_GPIO_Port GPIOA
#define SX126X_RST_Pin GPIO_PIN_4
#define SX126X_RST_GPIO_Port GPIOA
#define SX126X_TXEN_Pin GPIO_PIN_5
#define SX126X_TXEN_GPIO_Port GPIOA
#define SX126X_NSS_Pin GPIO_PIN_2
#define SX126X_NSS_GPIO_Port GPIOB
#define BUTTON_LEFT_Pin GPIO_PIN_15
#define BUTTON_LEFT_GPIO_Port GPIOA
#define BUTTON_LEFT_EXTI_IRQn EXTI15_10_IRQn
#define BUTTON_DOWN_Pin GPIO_PIN_3
#define BUTTON_DOWN_GPIO_Port GPIOB
#define BUTTON_DOWN_EXTI_IRQn EXTI3_IRQn
#define BUTTON_MID_Pin GPIO_PIN_4
#define BUTTON_MID_GPIO_Port GPIOB
#define BUTTON_MID_EXTI_IRQn EXTI4_IRQn
#define BUTTON_RIGHT_Pin GPIO_PIN_5
#define BUTTON_RIGHT_GPIO_Port GPIOB
#define BUTTON_RIGHT_EXTI_IRQn EXTI9_5_IRQn
#define SX1262_RXEN_Pin GPIO_PIN_7
#define SX1262_RXEN_GPIO_Port GPIOB
