a-conspiracy-theory/jhnvrw-seniordesign/software/WB05/BLE_Sensors/Drivers/Environmental Sensors/Inc/Sensors_File.h

/*
 * Sensors_File.h
 *
 *  Created on: Nov 4, 2026
 *      Author: Nicho
 */

#ifndef ENVIRONMENTAL_SENSORS_INC_SENSORS_FILE_H_
#define ENVIRONMENTAL_SENSORS_INC_SENSORS_FILE_H_

void SENSOR_Read_Data(I2C_HandleTypeDef);
void STS41_Read_Data(I2C_HandleTypeDef);

#endif /* ENVIRONMENTAL_SENSORS_INC_SENSORS_FILE_H_ */
