a-conspiracy-theory/jhnvrw-seniordesign/software/WB55/PCB_SW/Full_SW_Integration/STM32_WPAN/App/app_ble.c

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

/* Includes ------------------------------------------------------------------*/
#include "main.h"

#include "app_common.h"

#include "dbg_trace.h"
#include "ble.h"
#include "tl.h"
#include "app_ble.h"

#include "cmsis_os.h"
#include "shci.h"
#include "stm32_lpm.h"
#include "otp.h"

#include "hrs_app.h"
#include "dis_app.h"

/* USER CODE BEGIN Includes */
#include "ui_bridge.h"
#include <stdio.h>
#include <string.h>
/* USER CODE END Includes */


/**
 * security parameters structure
 */
typedef struct _tSecurityParams
{
  /**
   * IO capability of the device
   */
  uint8_t ioCapability;

  /**
   * Authentication requirement of the device
   * Man In the Middle protection required?
   */
  uint8_t mitm_mode;

  /**
   * bonding mode of the device
   */
  uint8_t bonding_mode;

  /**
   * minimum encryption key size requirement
   */
  uint8_t encryptionKeySizeMin;

  /**
   * maximum encryption key size requirement
   */
  uint8_t encryptionKeySizeMax;

  /**
   * this flag indicates whether the host has to initiate
   * the security, wait for pairing or does not have any security
   * requirements.
   * 0x00 : no security required
   * 0x01 : host should initiate security by sending the slave security
   *        request command
   * 0x02 : host need not send the clave security request but it
   * has to wait for paiirng to complete before doing any other
   * processing
   */
  uint8_t initiateSecurity;
  /* USER CODE BEGIN tSecurityParams*/

  /* USER CODE END tSecurityParams */
}tSecurityParams;

/**
 * global context
 * contains the variables common to all
 * services
 */
typedef struct _tBLEProfileGlobalContext
{
  /**
   * security requirements of the host
   */
  tSecurityParams bleSecurityParam;

  /**
   * gap service handle
   */
  uint16_t gapServiceHandle;

  /**
   * device name characteristic handle
   */
  uint16_t devNameCharHandle;

  /**
   * appearance characteristic handle
   */
  uint16_t appearanceCharHandle;

  /**
   * connection handle of the current active connection
   * When not in connection, the handle is set to 0xFFFF
   */
  uint16_t connectionHandle;

  /**
   * length of the UUID list to be used while advertising
   */
  uint8_t advtServUUIDlen;

  /**
   * the UUID list to be used while advertising
   */
  uint8_t advtServUUID[100];
  /* USER CODE BEGIN BleGlobalContext_t*/

  /* USER CODE END BleGlobalContext_t */
}BleGlobalContext_t;

typedef struct
{
  BleGlobalContext_t BleApplicationContext_legacy;
  APP_BLE_ConnStatus_t Device_Connection_Status;

  /**
   * ID of the Advertising Timeout
   */
  uint8_t Advertising_mgr_timer_Id;
  /* USER CODE BEGIN PTD_1*/

  /* USER CODE END PTD_1 */
}BleApplicationContext_t;

#define APPBLE_GAP_DEVICE_NAME_LENGTH 7
#define FAST_ADV_TIMEOUT               (30*1000*1000/CFG_TS_TICK_VAL) /**< 30s */
#define INITIAL_ADV_TIMEOUT            (60*1000*1000/CFG_TS_TICK_VAL) /**< 60s */

#define BD_ADDR_SIZE_LOCAL    6
#define BLE_DEFAULT_PIN                     (111111)

/* USER CODE BEGIN PD */
/* Scan-only mode for the Eddystone-TLM receiver.
 * Keep this switch in a USER CODE section: CubeMX can regenerate app_ble.c.
 * 1 = scan-only (no automatic BLE advertising)
 * 0 = original generated GATT server advertising behavior
 */
#define TLM_SCAN_ONLY_MODE 1
/* USER CODE END PD */

PLACE_IN_SECTION("MB_MEM1") ALIGN(4) static TL_CmdPacket_t BleCmdBuffer;

static const uint8_t a_MBdAddr[BD_ADDR_SIZE_LOCAL] =
{
  (uint8_t)((CFG_ADV_BD_ADDRESS & 0x0000000000FF)),
  (uint8_t)((CFG_ADV_BD_ADDRESS & 0x00000000FF00) >> 8),
  (uint8_t)((CFG_ADV_BD_ADDRESS & 0x000000FF0000) >> 16),
  (uint8_t)((CFG_ADV_BD_ADDRESS & 0x0000FF000000) >> 24),
  (uint8_t)((CFG_ADV_BD_ADDRESS & 0x00FF00000000) >> 32),
  (uint8_t)((CFG_ADV_BD_ADDRESS & 0xFF0000000000) >> 40)
};

static uint8_t a_BdAddrUdn[BD_ADDR_SIZE_LOCAL];

/**
 *   Identity root key used to derive IRK and DHK(Legacy)
 */
static const uint8_t a_BLE_CfgIrValue[16] = CFG_BLE_IR;

/**
 * Encryption root key used to derive LTK(Legacy) and CSRK
 */
static const uint8_t a_BLE_CfgErValue[16] = CFG_BLE_ER;

/**
 * These are the two tags used to manage a power failure during OTA
 * The MagicKeywordAdress shall be mapped @0x140 from start of the binary image
 * The MagicKeywordvalue is checked in the ble_ota application
 */
PLACE_IN_SECTION("TAG_OTA_END") const uint32_t MagicKeywordValue = 0x94448A29 ;
PLACE_IN_SECTION("TAG_OTA_START") const uint32_t MagicKeywordAddress = (uint32_t)&MagicKeywordValue;

static BleApplicationContext_t BleApplicationContext;
static uint16_t AdvIntervalMin, AdvIntervalMax;

static const char a_LocalName[] = {AD_TYPE_COMPLETE_LOCAL_NAME , 'S', 'T', 'M', '3', '2', 'W', 'B'};
uint8_t a_ManufData[14] = {sizeof(a_ManufData)-1,
                           AD_TYPE_MANUFACTURER_SPECIFIC_DATA,
                           0x01 /*SKD version */,
                           0x00 /* Generic*/,
                           0x00 /* GROUP A Feature  */,
                           0x00 /* GROUP A Feature */,
                           0x00 /* GROUP B Feature */,
                           0x00 /* GROUP B Feature */,
                           0x00, /* BLE MAC start -MSB */
                           0x00,
                           0x00,
                           0x00,
                           0x00,
                           0x00, /* BLE MAC stop */
                          };

/* USER CODE BEGIN PV */
/* Scan duty cycle is 100% during each discovery procedure, same as TRIAL1. */
#define TLM_SCAN_INTERVAL 0x0320U /* 500 ms */
#define TLM_SCAN_WINDOW   0x0320U /* 500 ms */
#define TLM_SCAN_DONE_FLAG 0x00000001U

static osThreadId_t TlmScanThreadId;
static const osThreadAttr_t TlmScanThreadAttr = {
    .name = "TLM_Scan",
    .priority = osPriorityLow,
    .stack_size = 1024U
};
static uint32_t tlm_last_ui_tick;
static uint8_t tlm_has_ui_update;

/* Visible in the debugger, populated only when a valid FEAA/0x20 frame arrives. */
static volatile struct {
    uint8_t valid;
    uint8_t version;
    uint16_t humidity_raw;
    uint16_t temperature_raw;
    uint32_t adv_count;
    uint32_t time_since_boot;
} tlm_latest;
/* USER CODE END PV */

/* Global variables ----------------------------------------------------------*/
osMutexId_t MtxHciId;
osSemaphoreId_t SemHciId;
osThreadId_t AdvUpdateProcessId;
osThreadId_t HciUserEvtProcessId;

const osThreadAttr_t AdvUpdateProcess_attr = {
    .name = CFG_ADV_UPDATE_PROCESS_NAME,
    .attr_bits = CFG_ADV_UPDATE_PROCESS_ATTR_BITS,
    .cb_mem = CFG_ADV_UPDATE_PROCESS_CB_MEM,
    .cb_size = CFG_ADV_UPDATE_PROCESS_CB_SIZE,
    .stack_mem = CFG_ADV_UPDATE_PROCESS_STACK_MEM,
    .priority = CFG_ADV_UPDATE_PROCESS_PRIORITY,
    .stack_size = CFG_ADV_UPDATE_PROCESS_STACK_SIZE
};

const osThreadAttr_t HciUserEvtProcess_attr = {
    .name = CFG_HCI_USER_EVT_PROCESS_NAME,
    .attr_bits = CFG_HCI_USER_EVT_PROCESS_ATTR_BITS,
    .cb_mem = CFG_HCI_USER_EVT_PROCESS_CB_MEM,
    .cb_size = CFG_HCI_USER_EVT_PROCESS_CB_SIZE,
    .stack_mem = CFG_HCI_USER_EVT_PROCESS_STACK_MEM,
    .priority = CFG_HCI_USER_EVT_PROCESS_PRIORITY,
    .stack_size = CFG_HCI_USER_EVT_PROCESS_STACK_SIZE
};

static void HciUserEvtProcess(void *argument);
static void BLE_UserEvtRx(void *p_Payload);
static void BLE_StatusNot(HCI_TL_CmdStatus_t Status);
static void Ble_Tl_Init(void);
static void Ble_Hci_Gap_Gatt_Init(void);
static const uint8_t* BleGetBdAddress(void);
static void Adv_Request(APP_BLE_ConnStatus_t NewStatus);
static void Add_Advertisment_Service_UUID(uint16_t servUUID);
static void Adv_Mgr(void);
static void AdvUpdateProcess(void *argument);
static void Adv_Update(void);

/* USER CODE BEGIN PFP */
static void TLM_ScanThread(void *argument);
static void TLM_ProcessAdvertisingReport(const uint8_t *meta_data, uint8_t hci_plen);
static void TLM_ParseServiceData(const uint8_t *data, uint8_t length);
/* USER CODE END PFP */

/* External variables --------------------------------------------------------*/

/* Functions Definition ------------------------------------------------------*/
void APP_BLE_Init(void)
{
  SHCI_CmdStatus_t status;
  SHCI_C2_Ble_Init_Cmd_Packet_t ble_init_cmd_packet =
  {
    {{0,0,0}},                          /**< Header unused */
    {0,                                 /** pBleBufferAddress not used */
     0,                                 /** BleBufferSize not used */
     CFG_BLE_NUM_GATT_ATTRIBUTES,
     CFG_BLE_NUM_GATT_SERVICES,
     CFG_BLE_ATT_VALUE_ARRAY_SIZE,
     CFG_BLE_NUM_LINK,
     CFG_BLE_DATA_LENGTH_EXTENSION,
     CFG_BLE_PREPARE_WRITE_LIST_SIZE,
     CFG_BLE_MBLOCK_COUNT,
     CFG_BLE_MAX_ATT_MTU,
     CFG_BLE_PERIPHERAL_SCA,
     CFG_BLE_CENTRAL_SCA,
     CFG_BLE_LS_SOURCE,
     CFG_BLE_MAX_CONN_EVENT_LENGTH,
     CFG_BLE_HSE_STARTUP_TIME,
     CFG_BLE_VITERBI_MODE,
     CFG_BLE_OPTIONS,
     0,
     CFG_BLE_MAX_COC_INITIATOR_NBR,
     CFG_BLE_MIN_TX_POWER,
     CFG_BLE_MAX_TX_POWER,
     CFG_BLE_RX_MODEL_CONFIG,
     CFG_BLE_MAX_ADV_SET_NBR,
     CFG_BLE_MAX_ADV_DATA_LEN,
     CFG_BLE_TX_PATH_COMPENS,
     CFG_BLE_RX_PATH_COMPENS,
     CFG_BLE_CORE_VERSION,
     CFG_BLE_OPTIONS_EXT,
	 CFG_BLE_MAX_ADD_EATT_BEARERS
    }
  };

  /**
   * Initialize Ble Transport Layer
   */
  Ble_Tl_Init();

  /**
   * Do not allow standby in the application
   */
  UTIL_LPM_SetOffMode(1 << CFG_LPM_APP_BLE, UTIL_LPM_DISABLE);

  /**
   * Register the hci transport layer to handle BLE User Asynchronous Events
   */
  HciUserEvtProcessId = osThreadNew(HciUserEvtProcess, NULL, &HciUserEvtProcess_attr);

  /**
   * Starts the BLE Stack on CPU2
   */
  status = SHCI_C2_BLE_Init(&ble_init_cmd_packet);
  if (status != SHCI_Success)
  {
    APP_DBG_MSG("  Fail   : SHCI_C2_BLE_Init command, result: 0x%02x\n\r", status);
    /* if you are here, maybe CPU2 doesn't contain STM32WB_Copro_Wireless_Binaries, see Release_Notes.html */
    Error_Handler();
  }
  else
  {
    APP_DBG_MSG("  Success: SHCI_C2_BLE_Init command\n\r");
  }

  /**
   * Initialization of HCI & GATT & GAP layer
   */
  Ble_Hci_Gap_Gatt_Init();

  /**
   * Initialization of the BLE Services
   */
  SVCCTL_Init();

  /**
   * Initialization of the BLE App Context
   */
  BleApplicationContext.Device_Connection_Status = APP_BLE_IDLE;
  BleApplicationContext.BleApplicationContext_legacy.connectionHandle = 0xFFFF;

  /**
   * From here, all initialization are BLE application specific
   */
  AdvUpdateProcessId = osThreadNew(AdvUpdateProcess, NULL, &AdvUpdateProcess_attr);

  /**
   * Initialization of ADV - Ad Manufacturer Element - Support OTA Bit Mask
   */
#if (BLE_CFG_OTA_REBOOT_CHAR != 0)
  a_ManufData[sizeof(a_ManufData)-8] = CFG_FEATURE_OTA_REBOOT;
#endif /* BLE_CFG_OTA_REBOOT_CHAR != 0 */

  /**
   * Initialize DIS Application
   */
  DISAPP_Init();

  /**
   * Initialize HRS Application
   */
  HRSAPP_Init();

  /* USER CODE BEGIN APP_BLE_Init_3 */
#if (TLM_SCAN_ONLY_MODE == 1)
  /* At this point CPU2, HCI, GAP, GATT and the generated services are ready.
   * Create the scan thread and return before CubeMX's unprotected
   * advertising setup / Adv_Request() call below.
   * This is intentional: generated code stays intact after regeneration.
   * Scan-only mode never creates/uses the advertising manager timer.
   */
  TlmScanThreadId = osThreadNew(TLM_ScanThread, NULL, &TlmScanThreadAttr);
  if (TlmScanThreadId == NULL)
  {
    APP_DBG_MSG("TLM: scan task allocation failed\r\n");
    Error_Handler();
  }
  return;
#endif
  /* USER CODE END APP_BLE_Init_3 */

  /**
   * Create timer to handle the connection state machine
   */
  HW_TS_Create(CFG_TIM_PROC_ID_ISR, &(BleApplicationContext.Advertising_mgr_timer_Id), hw_ts_SingleShot, Adv_Mgr);

  /**
   * Make device discoverable
   */
  BleApplicationContext.BleApplicationContext_legacy.advtServUUID[0] = AD_TYPE_16_BIT_SERV_UUID;
  BleApplicationContext.BleApplicationContext_legacy.advtServUUIDlen = 1;
  Add_Advertisment_Service_UUID(HEART_RATE_SERVICE_UUID);

  /* Initialize intervals for reconnexion without intervals update */
  AdvIntervalMin = CFG_FAST_CONN_ADV_INTERVAL_MIN;
  AdvIntervalMax = CFG_FAST_CONN_ADV_INTERVAL_MAX;

  /**
   * Start to Advertise to be connected by Collector
   */
  Adv_Request(APP_BLE_FAST_ADV);

  /* USER CODE BEGIN APP_BLE_Init_2 */
  /* In TLM_SCAN_ONLY_MODE this generated advertising call is skipped by
   * the early return in APP_BLE_Init_3 (above). Leave it intact for CubeMX.
   */
  /* USER CODE END APP_BLE_Init_2 */

  return;
}

SVCCTL_UserEvtFlowStatus_t SVCCTL_App_Notification(void *p_Pckt)
{
  hci_event_pckt    *p_event_pckt;
  evt_le_meta_event *p_meta_evt;
  evt_blecore_aci   *p_blecore_evt;
  uint8_t           Tx_phy, Rx_phy;
  tBleStatus        ret = BLE_STATUS_INVALID_PARAMS;
  hci_le_connection_complete_event_rp0        *p_connection_complete_event;
  hci_disconnection_complete_event_rp0        *p_disconnection_complete_event;
  hci_le_phy_update_complete_event_rp0        *p_evt_le_phy_update_complete;
#if (CFG_DEBUG_APP_TRACE != 0)
  hci_le_connection_update_complete_event_rp0 *p_connection_update_complete_event;
#endif /* CFG_DEBUG_APP_TRACE != 0 */

  p_event_pckt = (hci_event_pckt*) ((hci_uart_pckt *) p_Pckt)->data;

  switch (p_event_pckt->evt)
  {
    case HCI_DISCONNECTION_COMPLETE_EVT_CODE:
    {
      p_disconnection_complete_event = (hci_disconnection_complete_event_rp0 *) p_event_pckt->data;

      if (p_disconnection_complete_event->Connection_Handle == BleApplicationContext.BleApplicationContext_legacy.connectionHandle)
      {
        BleApplicationContext.BleApplicationContext_legacy.connectionHandle = 0;
        BleApplicationContext.Device_Connection_Status = APP_BLE_IDLE;
        APP_DBG_MSG(">>== HCI_DISCONNECTION_COMPLETE_EVT_CODE\n");
        APP_DBG_MSG("     - Connection Handle:   0x%x\n     - Reason:    0x%x\n\r",
                    p_disconnection_complete_event->Connection_Handle,
                    p_disconnection_complete_event->Reason);

      }

      /* USER CODE BEGIN EVT_DISCONN_COMPLETE_1 */
#if (TLM_SCAN_ONLY_MODE == 1)
      /* No connections are expected in scan-only mode. Suppress the
       * generated re-advertising call below even after regeneration.
       */
      break;
#endif
      /* USER CODE END EVT_DISCONN_COMPLETE_1 */

      /* restart advertising */
      Adv_Request(APP_BLE_FAST_ADV);

      break; /* HCI_DISCONNECTION_COMPLETE_EVT_CODE */
    }

    case HCI_LE_META_EVT_CODE:
    {
      p_meta_evt = (evt_le_meta_event*) p_event_pckt->data;
      /* USER CODE BEGIN EVT_LE_META_EVENT */
      if (p_meta_evt->subevent == HCI_LE_ADVERTISING_REPORT_SUBEVT_CODE)
      {
        /* Raw HCI report bytes, as in BLE_HANDHELD_TRIAL1. */
        TLM_ProcessAdvertisingReport((const uint8_t *)p_meta_evt->data,
                                     p_event_pckt->plen);
      }
      /* USER CODE END EVT_LE_META_EVENT */
      switch (p_meta_evt->subevent)
      {
        case HCI_LE_CONNECTION_UPDATE_COMPLETE_SUBEVT_CODE:
#if (CFG_DEBUG_APP_TRACE != 0)
          p_connection_update_complete_event = (hci_le_connection_update_complete_event_rp0 *) p_meta_evt->data;
          APP_DBG_MSG(">>== HCI_LE_CONNECTION_UPDATE_COMPLETE_SUBEVT_CODE\n");
          APP_DBG_MSG("     - Connection Interval:   %.2f ms\n     - Connection latency:    %d\n     - Supervision Timeout: %d ms\n\r",
                       p_connection_update_complete_event->Conn_Interval*1.25,
                       p_connection_update_complete_event->Conn_Latency,
                       p_connection_update_complete_event->Supervision_Timeout*10);
#endif /* CFG_DEBUG_APP_TRACE != 0 */

          break;

        case HCI_LE_PHY_UPDATE_COMPLETE_SUBEVT_CODE:
          p_evt_le_phy_update_complete = (hci_le_phy_update_complete_event_rp0*)p_meta_evt->data;
          APP_DBG_MSG("==>> HCI_LE_PHY_UPDATE_COMPLETE_SUBEVT_CODE - ");
          if (p_evt_le_phy_update_complete->Status == 0)
          {
            APP_DBG_MSG("status ok \n");
          }
          else
          {
            APP_DBG_MSG("status nok \n");
          }

          ret = hci_le_read_phy(BleApplicationContext.BleApplicationContext_legacy.connectionHandle, &Tx_phy, &Rx_phy);
          if (ret != BLE_STATUS_SUCCESS)
          {
            APP_DBG_MSG("==>> hci_le_read_phy : fail\n\r");
          }
          else
          {
            APP_DBG_MSG("==>> hci_le_read_phy - Success \n");

            if ((Tx_phy == TX_2M) && (Rx_phy == RX_2M))
            {
              APP_DBG_MSG("==>> PHY Param  TX= %d, RX= %d \n\r", Tx_phy, Rx_phy);
            }
            else
            {
              APP_DBG_MSG("==>> PHY Param  TX= %d, RX= %d \n\r", Tx_phy, Rx_phy);
            }
          }
          break;

        case HCI_LE_CONNECTION_COMPLETE_SUBEVT_CODE:
        {
          p_connection_complete_event = (hci_le_connection_complete_event_rp0 *) p_meta_evt->data;
          /**
           * The connection is done, there is no need anymore to schedule the LP ADV
           */

          HW_TS_Stop(BleApplicationContext.Advertising_mgr_timer_Id);

          APP_DBG_MSG(">>== HCI_LE_CONNECTION_COMPLETE_SUBEVT_CODE - Connection handle: 0x%x\n", p_connection_complete_event->Connection_Handle);
          APP_DBG_MSG("     - Connection established with Central: @:%02x:%02x:%02x:%02x:%02x:%02x\n",
                      p_connection_complete_event->Peer_Address[5],
                      p_connection_complete_event->Peer_Address[4],
                      p_connection_complete_event->Peer_Address[3],
                      p_connection_complete_event->Peer_Address[2],
                      p_connection_complete_event->Peer_Address[1],
                      p_connection_complete_event->Peer_Address[0]);
          APP_DBG_MSG("     - Connection Interval:   %.2f ms\n     - Connection latency:    %d\n     - Supervision Timeout: %d ms\n\r",
                      p_connection_complete_event->Conn_Interval*1.25,
                      p_connection_complete_event->Conn_Latency,
                      p_connection_complete_event->Supervision_Timeout*10
                     );

          if (BleApplicationContext.Device_Connection_Status == APP_BLE_LP_CONNECTING)
          {
            /* Connection as client */
            BleApplicationContext.Device_Connection_Status = APP_BLE_CONNECTED_CLIENT;
          }
          else
          {
            /* Connection as server */
            BleApplicationContext.Device_Connection_Status = APP_BLE_CONNECTED_SERVER;
          }
          BleApplicationContext.BleApplicationContext_legacy.connectionHandle = p_connection_complete_event->Connection_Handle;
          break; /* HCI_LE_CONNECTION_COMPLETE_SUBEVT_CODE */
        }

        default:
          break;
      }

      break; /* HCI_LE_META_EVT_CODE */
    }

    case HCI_VENDOR_SPECIFIC_DEBUG_EVT_CODE:
      p_blecore_evt = (evt_blecore_aci*) p_event_pckt->data;
      switch (p_blecore_evt->ecode)
      {
        case ACI_GAP_PROC_COMPLETE_VSEVT_CODE:
          APP_DBG_MSG(">>== ACI_GAP_PROC_COMPLETE_VSEVT_CODE \r");
          /* USER CODE BEGIN EVT_BLUE_GAP_PROCEDURE_COMPLETE */
          {
            const aci_gap_proc_complete_event_rp0 *done =
                (const aci_gap_proc_complete_event_rp0 *)p_blecore_evt->data;
            if ((done->Procedure_Code == GAP_GENERAL_DISCOVERY_PROC) &&
                (TlmScanThreadId != NULL))
            {
              /* Wake the scan task; don't issue an HCI command in this callback. */
              (void)osThreadFlagsSet(TlmScanThreadId, TLM_SCAN_DONE_FLAG);
            }
          }
          /* USER CODE END EVT_BLUE_GAP_PROCEDURE_COMPLETE */
          break; /* ACI_GAP_PROC_COMPLETE_VSEVT_CODE */

        case ACI_GATT_INDICATION_VSEVT_CODE:
        {
          APP_DBG_MSG(">>== ACI_GATT_INDICATION_VSEVT_CODE \r");
          aci_gatt_confirm_indication(BleApplicationContext.BleApplicationContext_legacy.connectionHandle);
        }
        break;

      }
      break; /* HCI_VENDOR_SPECIFIC_DEBUG_EVT_CODE */

    default:
      /* USER CODE BEGIN ECODE_DEFAULT*/

      /* USER CODE END ECODE_DEFAULT*/
      break;
  }

  return (SVCCTL_UserEvtFlowEnable);
}

APP_BLE_ConnStatus_t APP_BLE_Get_Server_Connection_Status(void)
{
  return BleApplicationContext.Device_Connection_Status;
}

/* USER CODE BEGIN FD*/

/* FreeRTOS replacement for TRIAL1's UTIL_SEQ start/restart scan task. */
static void TLM_ScanThread(void *argument)
{
  (void)argument;
  for (;;)
  {
    tBleStatus status = aci_gap_start_general_discovery_proc(
        TLM_SCAN_INTERVAL, TLM_SCAN_WINDOW, CFG_BLE_ADDRESS_TYPE, 0);

    if (status == BLE_STATUS_SUCCESS)
    {
      APP_DBG_MSG("TLM: discovery started\r\n");
      /* General discovery is finite. GAP procedure-complete event wakes us. */
      (void)osThreadFlagsWait(TLM_SCAN_DONE_FLAG, osFlagsWaitAny, 15000U);
      /* A short gap makes repeated discovery more cooperative with other tasks. */
      osDelay(100U);
    }
    else
    {
      APP_DBG_MSG("TLM: discovery start failed: 0x%02X\r\n", status);
      osDelay(1000U);
    }
  }
}

/* HCI legacy advertising report layout:
 * [Num_Reports][Event_Type][Address_Type][Address(6)][Length_Data]
 * [AD bytes...][RSSI].  Do not dereference Advertising_Report[0].Data;
 * on STM32WB it is a pointer-shaped field over packed variable-length data.
 */
static void TLM_ProcessAdvertisingReport(const uint8_t *meta_data, uint8_t hci_plen)
{
  if ((meta_data == NULL) || (hci_plen < 12U) || (meta_data[0] == 0U))
    return;

  uint8_t adv_length = meta_data[9];
  if ((adv_length > 31U) || ((uint16_t)hci_plen < (uint16_t)(12U + adv_length)))
    return;

  const uint8_t *adv = &meta_data[10];
  uint8_t offset = 0;
  while (offset < adv_length)
  {
    uint8_t field_length = adv[offset];
    if (field_length == 0U)
      break;
    if ((uint16_t)offset + (uint16_t)field_length + 1U > adv_length)
      break;
    /* AD 0x16 = Service Data - 16-bit UUID. */
    if ((field_length >= 17U) && (adv[offset + 1U] == 0x16U))
      TLM_ParseServiceData(&adv[offset + 2U], (uint8_t)(field_length - 1U));

    offset = (uint8_t)(offset + field_length + 1U);
  }
}

/* Preserve TRIAL1's custom SHT41 interpretation of Eddystone TLM.
 * Bytes [4..5] are raw humidity (normally TLM battery mV).
 * Bytes [6..7] are raw temperature (normally TLM temperature).
 */
static void TLM_ParseServiceData(const uint8_t *data, uint8_t length)
{
  if ((data == NULL) || (length < 16U) ||
      (data[0] != 0xAAU) || (data[1] != 0xFEU) || (data[2] != 0x20U))
    return;

  uint16_t humidity = ((uint16_t)data[4] << 8) | data[5];
  uint16_t temperature = ((uint16_t)data[6] << 8) | data[7];
  tlm_latest.version = data[3];
  tlm_latest.humidity_raw = humidity;
  tlm_latest.temperature_raw = temperature;
  tlm_latest.adv_count = ((uint32_t)data[8] << 24) |
                          ((uint32_t)data[9] << 16) |
                          ((uint32_t)data[10] << 8) | data[11];
  tlm_latest.time_since_boot = ((uint32_t)data[12] << 24) |
                               ((uint32_t)data[13] << 16) |
                               ((uint32_t)data[14] << 8) | data[15];
  tlm_latest.valid = 1U;

  /* Keep at most one history sample per second; don't fill the log with
   * several advertisements received in the same short burst. */
  uint32_t now = osKernelGetTickCount();
  uint32_t tick_hz = osKernelGetTickFreq();
  if (tick_hz != 0U &&
      (!tlm_has_ui_update || (now - tlm_last_ui_tick >= tick_hz)))
  {
    ui_tlm_reading_t reading = {
      .humidity_raw = humidity,
      .temperature_raw = temperature,
      .received_seconds = now / tick_hz, /* time since STM32 start */
      .adv_count = tlm_latest.adv_count
    };

    if (UI_PostTLMReading(&reading))
    {
      tlm_last_ui_tick = now;
      tlm_has_ui_update = 1U;
    }
  }
}



/* USER CODE END FD*/

/*************************************************************
 *
 * LOCAL FUNCTIONS
 *
 *************************************************************/
static void Ble_Tl_Init(void)
{
  HCI_TL_HciInitConf_t Hci_Tl_Init_Conf;

  MtxHciId = osMutexNew(NULL);
  SemHciId = osSemaphoreNew(1, 0, NULL); /*< Create the semaphore and make it busy at initialization */

  Hci_Tl_Init_Conf.p_cmdbuffer = (uint8_t*)&BleCmdBuffer;
  Hci_Tl_Init_Conf.StatusNotCallBack = BLE_StatusNot;
  hci_init(BLE_UserEvtRx, (void*) &Hci_Tl_Init_Conf);

  return;
}

static void Ble_Hci_Gap_Gatt_Init(void)
{
  uint8_t role;
  uint16_t gap_service_handle, gap_dev_name_char_handle, gap_appearance_char_handle;
  const uint8_t *p_bd_addr;
  uint16_t a_appearance[1] = {BLE_CFG_GAP_APPEARANCE};
  tBleStatus ret = BLE_STATUS_INVALID_PARAMS;
  /* USER CODE BEGIN Ble_Hci_Gap_Gatt_Init*/

  /* USER CODE END Ble_Hci_Gap_Gatt_Init*/

  APP_DBG_MSG("==>> Start Ble_Hci_Gap_Gatt_Init function\n");

  /**
   * Initialize HCI layer
   */
  /*HCI Reset to synchronise BLE Stack*/
  ret = hci_reset();
  if (ret != BLE_STATUS_SUCCESS)
  {
    APP_DBG_MSG("  Fail   : hci_reset command, result: 0x%x \n", ret);
  }
  else
  {
    APP_DBG_MSG("  Success: hci_reset command\n");
  }

  /**
   * Write the BD Address
   */
  p_bd_addr = BleGetBdAddress();
  ret = aci_hal_write_config_data(CONFIG_DATA_PUBLIC_ADDRESS_OFFSET, CONFIG_DATA_PUBLIC_ADDRESS_LEN, (uint8_t*) p_bd_addr);
  if (ret != BLE_STATUS_SUCCESS)
  {
    APP_DBG_MSG("  Fail   : aci_hal_write_config_data command - CONFIG_DATA_PUBLIC_ADDRESS_OFFSET, result: 0x%x \n", ret);
  }
  else
  {
    APP_DBG_MSG("  Success: aci_hal_write_config_data command - CONFIG_DATA_PUBLIC_ADDRESS_OFFSET\n");
    APP_DBG_MSG("  Public Bluetooth Address: %02x:%02x:%02x:%02x:%02x:%02x\n",p_bd_addr[5],p_bd_addr[4],p_bd_addr[3],p_bd_addr[2],p_bd_addr[1],p_bd_addr[0]);
  }

#if (CFG_BLE_ADDRESS_TYPE == GAP_PUBLIC_ADDR)
  /* BLE MAC in ADV Packet */
  a_ManufData[ sizeof(a_ManufData)-6] = p_bd_addr[5];
  a_ManufData[ sizeof(a_ManufData)-5] = p_bd_addr[4];
  a_ManufData[ sizeof(a_ManufData)-4] = p_bd_addr[3];
  a_ManufData[ sizeof(a_ManufData)-3] = p_bd_addr[2];
  a_ManufData[ sizeof(a_ManufData)-2] = p_bd_addr[1];
  a_ManufData[ sizeof(a_ManufData)-1] = p_bd_addr[0];
#endif /* CFG_BLE_ADDRESS_TYPE == GAP_PUBLIC_ADDR */

  /**
   * Static random Address
   * The two upper bits shall be set to 1
   * The lowest 32bits is read from the UDN to differentiate between devices
   * The RNG may be used to provide a random number on each power on
   */
#if (CFG_BLE_ADDRESS_TYPE != GAP_PUBLIC_ADDR)
  /* BLE MAC in ADV Packet */
  a_ManufData[ sizeof(a_ManufData)-6] = a_srd_bd_addr[1] >> 8 ;
  a_ManufData[ sizeof(a_ManufData)-5] = a_srd_bd_addr[1];
  a_ManufData[ sizeof(a_ManufData)-4] = a_srd_bd_addr[0] >> 24;
  a_ManufData[ sizeof(a_ManufData)-3] = a_srd_bd_addr[0] >> 16;
  a_ManufData[ sizeof(a_ManufData)-2] = a_srd_bd_addr[0] >> 8;
  a_ManufData[ sizeof(a_ManufData)-1] = a_srd_bd_addr[0];

  ret = aci_hal_write_config_data(CONFIG_DATA_RANDOM_ADDRESS_OFFSET, CONFIG_DATA_RANDOM_ADDRESS_LEN, (uint8_t*)a_srd_bd_addr);
  if (ret != BLE_STATUS_SUCCESS)
  {
    APP_DBG_MSG("  Fail   : aci_hal_write_config_data command - CONFIG_DATA_RANDOM_ADDRESS_OFFSET, result: 0x%x \n", ret);
  }
  else
  {
    APP_DBG_MSG("  Success: aci_hal_write_config_data command - CONFIG_DATA_RANDOM_ADDRESS_OFFSET\n");
    APP_DBG_MSG("  Random Bluetooth Address: %02x:%02x:%02x:%02x:%02x:%02x\n", (uint8_t)(a_srd_bd_addr[1] >> 8),
                                                                               (uint8_t)(a_srd_bd_addr[1]),
                                                                               (uint8_t)(a_srd_bd_addr[0] >> 24),
                                                                               (uint8_t)(a_srd_bd_addr[0] >> 16),
                                                                               (uint8_t)(a_srd_bd_addr[0] >> 8),
                                                                               (uint8_t)(a_srd_bd_addr[0]));
  }
#endif /* CFG_BLE_ADDRESS_TYPE != GAP_PUBLIC_ADDR */

  /**
   * Write Identity root key used to derive IRK and DHK(Legacy)
   */
  ret = aci_hal_write_config_data(CONFIG_DATA_IR_OFFSET, CONFIG_DATA_IR_LEN, (uint8_t*)a_BLE_CfgIrValue);
  if (ret != BLE_STATUS_SUCCESS)
  {
    APP_DBG_MSG("  Fail   : aci_hal_write_config_data command - CONFIG_DATA_IR_OFFSET, result: 0x%x \n", ret);
  }
  else
  {
    APP_DBG_MSG("  Success: aci_hal_write_config_data command - CONFIG_DATA_IR_OFFSET\n");
  }

  /**
   * Write Encryption root key used to derive LTK and CSRK
   */
  ret = aci_hal_write_config_data(CONFIG_DATA_ER_OFFSET, CONFIG_DATA_ER_LEN, (uint8_t*)a_BLE_CfgErValue);
  if (ret != BLE_STATUS_SUCCESS)
  {
    APP_DBG_MSG("  Fail   : aci_hal_write_config_data command - CONFIG_DATA_ER_OFFSET, result: 0x%x \n", ret);
  }
  else
  {
    APP_DBG_MSG("  Success: aci_hal_write_config_data command - CONFIG_DATA_ER_OFFSET\n");
  }

  /**
   * Set TX Power.
   */
  ret = aci_hal_set_tx_power_level(1, CFG_TX_POWER);
  if (ret != BLE_STATUS_SUCCESS)
  {
    APP_DBG_MSG("  Fail   : aci_hal_set_tx_power_level command, result: 0x%x \n", ret);
  }
  else
  {
    APP_DBG_MSG("  Success: aci_hal_set_tx_power_level command\n");
  }

  /**
   * Initialize GATT interface
   */
  ret = aci_gatt_init();
  if (ret != BLE_STATUS_SUCCESS)
  {
    APP_DBG_MSG("  Fail   : aci_gatt_init command, result: 0x%x \n", ret);
  }
  else
  {
    APP_DBG_MSG("  Success: aci_gatt_init command\n");
  }

  /**
   * Initialize GAP interface
   */
  role = 0;

#if (BLE_CFG_PERIPHERAL == 1)
  role |= GAP_PERIPHERAL_ROLE;
#endif /* BLE_CFG_PERIPHERAL == 1 */

#if (BLE_CFG_CENTRAL == 1)
  role |= GAP_CENTRAL_ROLE;
#endif /* BLE_CFG_CENTRAL == 1 */

/* USER CODE BEGIN Role_Mngt*/
#if (TLM_SCAN_ONLY_MODE == 1)
  /* CubeMX's BLE_SERVER_PROFILE regenerates BLE_CFG_CENTRAL as 0.
   * Enable the central GAP role here so scanning survives regeneration
   * without changing the generated ble_conf.h file.
   */
  role |= GAP_CENTRAL_ROLE;
#endif
/* USER CODE END Role_Mngt */

  if (role > 0)
  {
    const char *name = "STM32WB";
    ret = aci_gap_init(role,
                       CFG_PRIVACY,
                       APPBLE_GAP_DEVICE_NAME_LENGTH,
                       &gap_service_handle,
                       &gap_dev_name_char_handle,
                       &gap_appearance_char_handle);

    if (ret != BLE_STATUS_SUCCESS)
    {
      APP_DBG_MSG("  Fail   : aci_gap_init command, result: 0x%x \n", ret);
    }
    else
    {
      APP_DBG_MSG("  Success: aci_gap_init command\n");
    }

    ret = aci_gatt_update_char_value(gap_service_handle, gap_dev_name_char_handle, 0, strlen(name), (uint8_t *) name);
    if (ret != BLE_STATUS_SUCCESS)
    {
      BLE_DBG_SVCCTL_MSG("  Fail   : aci_gatt_update_char_value - Device Name\n");
    }
    else
    {
      BLE_DBG_SVCCTL_MSG("  Success: aci_gatt_update_char_value - Device Name\n");
    }
  }

  ret = aci_gatt_update_char_value(gap_service_handle,
                                   gap_appearance_char_handle,
                                   0,
                                   2,
                                   (uint8_t *)&a_appearance);
  if (ret != BLE_STATUS_SUCCESS)
  {
    BLE_DBG_SVCCTL_MSG("  Fail   : aci_gatt_update_char_value - Appearance\n");
  }
  else
  {
    BLE_DBG_SVCCTL_MSG("  Success: aci_gatt_update_char_value - Appearance\n");
  }

  /**
   * Initialize Default PHY
   */
  ret = hci_le_set_default_phy(ALL_PHYS_PREFERENCE,TX_2M_PREFERRED,RX_2M_PREFERRED);
  if (ret != BLE_STATUS_SUCCESS)
  {
    APP_DBG_MSG("  Fail   : hci_le_set_default_phy command, result: 0x%x \n", ret);
  }
  else
  {
    APP_DBG_MSG("  Success: hci_le_set_default_phy command\n");
  }

  /**
   * Initialize IO capability
   */
  BleApplicationContext.BleApplicationContext_legacy.bleSecurityParam.ioCapability = CFG_IO_CAPABILITY;
  ret = aci_gap_set_io_capability(BleApplicationContext.BleApplicationContext_legacy.bleSecurityParam.ioCapability);
  if (ret != BLE_STATUS_SUCCESS)
  {
    APP_DBG_MSG("  Fail   : aci_gap_set_io_capability command, result: 0x%x \n", ret);
  }
  else
  {
    APP_DBG_MSG("  Success: aci_gap_set_io_capability command\n");
  }

  /**
   * Initialize authentication
   */
  BleApplicationContext.BleApplicationContext_legacy.bleSecurityParam.mitm_mode = CFG_MITM_PROTECTION;
  BleApplicationContext.BleApplicationContext_legacy.bleSecurityParam.encryptionKeySizeMin = CFG_ENCRYPTION_KEY_SIZE_MIN;
  BleApplicationContext.BleApplicationContext_legacy.bleSecurityParam.encryptionKeySizeMax = CFG_ENCRYPTION_KEY_SIZE_MAX;
  BleApplicationContext.BleApplicationContext_legacy.bleSecurityParam.bonding_mode = CFG_BONDING_MODE;
  /* USER CODE BEGIN Ble_Hci_Gap_Gatt_Init_1*/

  /* USER CODE END Ble_Hci_Gap_Gatt_Init_1*/

  ret = aci_gap_set_authentication_requirement(BleApplicationContext.BleApplicationContext_legacy.bleSecurityParam.bonding_mode,
                                               BleApplicationContext.BleApplicationContext_legacy.bleSecurityParam.mitm_mode,
                                               CFG_SC_SUPPORT,
                                               CFG_KEYPRESS_NOTIFICATION_SUPPORT,
                                               BleApplicationContext.BleApplicationContext_legacy.bleSecurityParam.encryptionKeySizeMin,
                                               BleApplicationContext.BleApplicationContext_legacy.bleSecurityParam.encryptionKeySizeMax,
                                               USE_FIXED_PIN_FOR_PAIRING_FORBIDDEN, /* deprecated feature */
                                               0,                                   /* deprecated feature */
                                               CFG_IDENTITY_ADDRESS);
  if (ret != BLE_STATUS_SUCCESS)
  {
    APP_DBG_MSG("  Fail   : aci_gap_set_authentication_requirement command, result: 0x%x \n", ret);
  }
  else
  {
    APP_DBG_MSG("  Success: aci_gap_set_authentication_requirement command\n");
  }

  /**
   * Initialize whitelist
   */
  if (BleApplicationContext.BleApplicationContext_legacy.bleSecurityParam.bonding_mode)
  {
    ret = aci_gap_configure_whitelist();
    if (ret != BLE_STATUS_SUCCESS)
    {
      APP_DBG_MSG("  Fail   : aci_gap_configure_whitelist command, result: 0x%x \n", ret);
    }
    else
    {
      APP_DBG_MSG("  Success: aci_gap_configure_whitelist command\n");
    }
  }
  APP_DBG_MSG("==>> End Ble_Hci_Gap_Gatt_Init function\n\r");
}

static void Adv_Request(APP_BLE_ConnStatus_t NewStatus)
{
  tBleStatus ret = BLE_STATUS_INVALID_PARAMS;
  uint16_t Min_Inter, Max_Inter;

  if (NewStatus == APP_BLE_FAST_ADV)
  {
    Min_Inter = AdvIntervalMin;
    Max_Inter = AdvIntervalMax;
  }
  else
  {
    Min_Inter = CFG_LP_CONN_ADV_INTERVAL_MIN;
    Max_Inter = CFG_LP_CONN_ADV_INTERVAL_MAX;
  }

  /**
   * Stop the timer, it will be restarted for a new shot
   * It does not hurt if the timer was not running
   */
  HW_TS_Stop(BleApplicationContext.Advertising_mgr_timer_Id);

  if ((NewStatus == APP_BLE_LP_ADV)
      && ((BleApplicationContext.Device_Connection_Status == APP_BLE_FAST_ADV)
          || (BleApplicationContext.Device_Connection_Status == APP_BLE_LP_ADV)))
  {
    /* Connection in ADVERTISE mode have to stop the current advertising */
    ret = aci_gap_set_non_discoverable();
    if (ret != BLE_STATUS_SUCCESS)
    {
      APP_DBG_MSG("==>> aci_gap_set_non_discoverable - Stop Advertising Failed , result: %d \n", ret);
    }
    else
    {
      APP_DBG_MSG("==>> aci_gap_set_non_discoverable - Successfully Stopped Advertising \n");
    }
  }

  BleApplicationContext.Device_Connection_Status = NewStatus;
  /* Start Fast or Low Power Advertising */
  ret = aci_gap_set_discoverable(ADV_IND,
                                 Min_Inter,
                                 Max_Inter,
                                 CFG_BLE_ADDRESS_TYPE,
                                 NO_WHITE_LIST_USE, /* use white list */
                                 sizeof(a_LocalName),
                                 (uint8_t*) &a_LocalName,
                                 BleApplicationContext.BleApplicationContext_legacy.advtServUUIDlen,
                                 BleApplicationContext.BleApplicationContext_legacy.advtServUUID,
                                 0,
                                 0);
  if (ret != BLE_STATUS_SUCCESS)
  {
    APP_DBG_MSG("==>> aci_gap_set_discoverable - fail, result: 0x%x \n", ret);
  }
  else
  {
    APP_DBG_MSG("==>> aci_gap_set_discoverable - Success\n");
  }

  /* Update Advertising data */
  ret = aci_gap_update_adv_data(sizeof(a_ManufData), (uint8_t*) a_ManufData);
  if (ret != BLE_STATUS_SUCCESS)
  {
    if (NewStatus == APP_BLE_FAST_ADV)
    {
      APP_DBG_MSG("==>> Start Fast Advertising Failed , result: %d \n\r", ret);
    }
    else
    {
      APP_DBG_MSG("==>> Start Low Power Advertising Failed , result: %d \n\r", ret);
    }
  }
  else
  {
    if (NewStatus == APP_BLE_FAST_ADV)
    {
      APP_DBG_MSG("==>> Success: Start Fast Advertising \n\r");
      /* Start Timer to STOP ADV - TIMEOUT - and next Restart Low Power Advertising */
      HW_TS_Start(BleApplicationContext.Advertising_mgr_timer_Id, INITIAL_ADV_TIMEOUT);
    }
    else
    {
      APP_DBG_MSG("==>> Success: Start Low Power Advertising \n\r");
    }
  }

  return;
}

const uint8_t* BleGetBdAddress(void)
{
  uint8_t *p_otp_addr;
  const uint8_t *p_bd_addr;
  uint32_t udn;
  uint32_t company_id;
  uint32_t device_id;

  udn = LL_FLASH_GetUDN();

  if (udn != 0xFFFFFFFF)
  {
    company_id = LL_FLASH_GetSTCompanyID();
    device_id = LL_FLASH_GetDeviceID();

    /**
     * Public Address with the ST company ID
     * bit[47:24] : 24bits (OUI) equal to the company ID
     * bit[23:16] : Device ID.
     * bit[15:0] : The last 16bits from the UDN
     * Note: In order to use the Public Address in a final product, a dedicated
     * 24bits company ID (OUI) shall be bought.
     */
    a_BdAddrUdn[0] = (uint8_t)(udn & 0x000000FF);
    a_BdAddrUdn[1] = (uint8_t)((udn & 0x0000FF00) >> 8);
    a_BdAddrUdn[2] = (uint8_t)device_id;
    a_BdAddrUdn[3] = (uint8_t)(company_id & 0x000000FF);
    a_BdAddrUdn[4] = (uint8_t)((company_id & 0x0000FF00) >> 8);
    a_BdAddrUdn[5] = (uint8_t)((company_id & 0x00FF0000) >> 16);

    p_bd_addr = (const uint8_t *)a_BdAddrUdn;
  }
  else
  {
    p_otp_addr = OTP_Read(0);
    if (p_otp_addr)
    {
      p_bd_addr = ((OTP_ID0_t*)p_otp_addr)->bd_address;
    }
    else
    {
      p_bd_addr = a_MBdAddr;
    }
  }

  return p_bd_addr;
}

/*************************************************************
 *
 *SPECIFIC FUNCTIONS
 *
 *************************************************************/
static void Add_Advertisment_Service_UUID(uint16_t servUUID)
{
  BleApplicationContext.BleApplicationContext_legacy.advtServUUID[BleApplicationContext.BleApplicationContext_legacy.advtServUUIDlen] =
      (uint8_t) (servUUID & 0xFF);
  BleApplicationContext.BleApplicationContext_legacy.advtServUUIDlen++;
  BleApplicationContext.BleApplicationContext_legacy.advtServUUID[BleApplicationContext.BleApplicationContext_legacy.advtServUUIDlen] =
      (uint8_t) (servUUID >> 8) & 0xFF;
  BleApplicationContext.BleApplicationContext_legacy.advtServUUIDlen++;

  return;
}

static void Adv_Mgr(void)
{
  /**
   * The code shall be executed in the background as an aci command may be sent
   * The background is the only place where the application can make sure a new aci command
   * is not sent if there is a pending one
   */
  osThreadFlagsSet(AdvUpdateProcessId, 1);

  return;
}

static void AdvUpdateProcess(void *argument)
{
  UNUSED(argument);

  for(;;)
  {
    osThreadFlagsWait(1, osFlagsWaitAny, osWaitForever);
    Adv_Update();
  }
}

static void Adv_Update(void)
{
  Adv_Request(APP_BLE_LP_ADV);

  return;
}

static void HciUserEvtProcess(void *argument)
{
  UNUSED(argument);

  for(;;)
  {
    osThreadFlagsWait(1, osFlagsWaitAny, osWaitForever);
    hci_user_evt_proc();
  }
}

/*************************************************************
 *
 * WRAP FUNCTIONS
 *
 *************************************************************/
void hci_notify_asynch_evt(void* p_Data)
{
  UNUSED(p_Data);
  osThreadFlagsSet(HciUserEvtProcessId, 1);

  return;
}

void hci_cmd_resp_release(uint32_t Flag)
{
  UNUSED(Flag);
  osSemaphoreRelease(SemHciId);

  return;
}

void hci_cmd_resp_wait(uint32_t Timeout)
{
  UNUSED(Timeout);
  osSemaphoreAcquire(SemHciId, osWaitForever);

  return;
}

static void BLE_UserEvtRx(void *p_Payload)
{
  SVCCTL_UserEvtFlowStatus_t svctl_return_status;
  tHCI_UserEvtRxParam *p_param;

  p_param = (tHCI_UserEvtRxParam *)p_Payload;

  svctl_return_status = SVCCTL_UserEvtRx((void *)&(p_param->pckt->evtserial));
  if (svctl_return_status != SVCCTL_UserEvtFlowDisable)
  {
    p_param->status = HCI_TL_UserEventFlow_Enable;
  }
  else
  {
    p_param->status = HCI_TL_UserEventFlow_Disable;
  }

  return;
}

static void BLE_StatusNot(HCI_TL_CmdStatus_t Status)
{
  switch (Status)
  {
    case HCI_TL_CmdBusy:
      osMutexAcquire(MtxHciId, osWaitForever);
      break;

    case HCI_TL_CmdAvailable:
      osMutexRelease(MtxHciId);
      break;

    default:
      break;
  }

  return;
}

void SVCCTL_ResumeUserEventFlow(void)
{
  hci_resume_flow();

  return;
}
