a-conspiracy-theory/jhnvrw-seniordesign/software/WB05/BLE_Beacon/Core/Src/stm32wb0x_hal_msp.c

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
/* Includes ------------------------------------------------------------------*/
#include "main.h"
/* USER CODE BEGIN PFP */
static void lowPowerIOSetup(void);
/* USER CODE END PFP */

/* External functions --------------------------------------------------------*/
/**
  * Initializes the Global MSP.
  */
void HAL_MspInit(void)
{

  /* USER CODE BEGIN MspInit 0 */

  /* IOs configuration to have the lowest power consumption in DEEPSTOP */
  lowPowerIOSetup();

  /* USER CODE END MspInit 0 */
  PWR_PVDTypeDef sConfigPVD = {0};

  __HAL_RCC_SYSCFG_CLK_ENABLE();

  /* System interrupt init*/

  /** PVD Configuration
  */
  sConfigPVD.PVDLevel = PWR_PVDLEVEL_7;
  sConfigPVD.Mode = PWR_PVD_MODE_NORMAL;
  HAL_PWR_ConfigPVD(&sConfigPVD);

  /** Enable the PVD Output
  */
  HAL_PWR_EnablePVD();

}

/**
  * @brief ADC MSP Initialization
  * This function configures the hardware resources used in this example
  * @param hadc: ADC handle pointer
  * @retval None
  */
void HAL_ADC_MspInit(ADC_HandleTypeDef* hadc)
{
  GPIO_InitTypeDef GPIO_InitStruct = {0};
  if(hadc->Instance==ADC1)
  {
    /* Peripheral clock enable */
    __HAL_RCC_ADCANA_CLK_ENABLE();
    __HAL_RCC_ADCDIG_CLK_ENABLE();

    __HAL_RCC_GPIOB_CLK_ENABLE();
    /**ADC1 GPIO Configuration
    PB3     ------> ADC1_VINP0
    */
    GPIO_InitStruct.Pin = GPIO_PIN_3;
    GPIO_InitStruct.Mode = GPIO_MODE_ANALOG;
    GPIO_InitStruct.Pull = GPIO_NOPULL;
    HAL_GPIO_Init(GPIOB, &GPIO_InitStruct);

    HAL_PWREx_DisableGPIOPullUp(PWR_GPIO_B, PWR_GPIO_BIT_3);

    HAL_PWREx_DisableGPIOPullDown(PWR_GPIO_B, PWR_GPIO_BIT_3);

  }

}

/**
  * @brief ADC MSP De-Initialization
  * This function freeze the hardware resources used in this example
  * @param hadc: ADC handle pointer
  * @retval None
  */
void HAL_ADC_MspDeInit(ADC_HandleTypeDef* hadc)
{
  if(hadc->Instance==ADC1)
  {
    /* Peripheral clock disable */
    __HAL_RCC_ADCANA_CLK_DISABLE();
    __HAL_RCC_ADCDIG_CLK_DISABLE();

    /**ADC1 GPIO Configuration
    PB3     ------> ADC1_VINP0
    */
    HAL_GPIO_DeInit(GPIOB, GPIO_PIN_3);

  }

}

/**
  * @brief I2C MSP Initialization
  * This function configures the hardware resources used in this example
  * @param hi2c: I2C handle pointer
  * @retval None
  */
void HAL_I2C_MspInit(I2C_HandleTypeDef* hi2c)
{
  GPIO_InitTypeDef GPIO_InitStruct = {0};
  if(hi2c->Instance==I2C1)
  {
    __HAL_RCC_GPIOB_CLK_ENABLE();
    /**I2C1 GPIO Configuration
    PB7     ------> I2C1_SDA
    PB6     ------> I2C1_SCL
    */
    GPIO_InitStruct.Pin = GPIO_PIN_7|GPIO_PIN_6;
    GPIO_InitStruct.Mode = GPIO_MODE_AF_OD;
    GPIO_InitStruct.Pull = GPIO_NOPULL;
    GPIO_InitStruct.Speed = GPIO_SPEED_FREQ_LOW;
    GPIO_InitStruct.Alternate = GPIO_AF0_I2C1;
    HAL_GPIO_Init(GPIOB, &GPIO_InitStruct);

    HAL_PWREx_DisableGPIOPullUp(PWR_GPIO_B, PWR_GPIO_BIT_7|PWR_GPIO_BIT_6);

    HAL_PWREx_DisableGPIOPullDown(PWR_GPIO_B, PWR_GPIO_BIT_7|PWR_GPIO_BIT_6);

    /* Peripheral clock enable */
    __HAL_RCC_I2C1_CLK_ENABLE();
  }

}

/**
  * @brief I2C MSP De-Initialization
  * This function freeze the hardware resources used in this example
  * @param hi2c: I2C handle pointer
  * @retval None
  */
void HAL_I2C_MspDeInit(I2C_HandleTypeDef* hi2c)
{
  if(hi2c->Instance==I2C1)
  {
    /* Peripheral clock disable */
    __HAL_RCC_I2C1_CLK_DISABLE();

    /**I2C1 GPIO Configuration
    PB7     ------> I2C1_SDA
    PB6     ------> I2C1_SCL
    */
    HAL_GPIO_DeInit(GPIOB, GPIO_PIN_7);

    HAL_GPIO_DeInit(GPIOB, GPIO_PIN_6);

  }

}

/**
  * @brief PKA MSP Initialization
  * This function configures the hardware resources used in this example
  * @param hpka: PKA handle pointer
  * @retval None
  */
void HAL_PKA_MspInit(PKA_HandleTypeDef* hpka)
{
  if(hpka->Instance==PKA)
  {
    /* Peripheral clock enable */
    __HAL_RCC_PKA_CLK_ENABLE();
    /* PKA interrupt Init */
    HAL_NVIC_SetPriority(PKA_IRQn, 1, 0);
    HAL_NVIC_EnableIRQ(PKA_IRQn);
  }

}

/**
  * @brief PKA MSP De-Initialization
  * This function freeze the hardware resources used in this example
  * @param hpka: PKA handle pointer
  * @retval None
  */
void HAL_PKA_MspDeInit(PKA_HandleTypeDef* hpka)
{
  if(hpka->Instance==PKA)
  {
    /* Peripheral clock disable */
    __HAL_RCC_PKA_CLK_DISABLE();

    /* PKA interrupt DeInit */
    HAL_NVIC_DisableIRQ(PKA_IRQn);
  }

}

/**
  * @brief RADIO MSP Initialization
  * This function configures the hardware resources used in this example
  * @param hradio: RADIO handle pointer
  * @retval None
  */
void HAL_RADIO_MspInit(RADIO_HandleTypeDef* hradio)
{
  RCC_PeriphCLKInitTypeDef PeriphClkInitStruct = {0};
  if(hradio->Instance==RADIO)
  {
  /** Initializes the peripherals clock
  */
    PeriphClkInitStruct.PeriphClockSelection = RCC_PERIPHCLK_RF;
    PeriphClkInitStruct.RFClockSelection = RCC_RF_CLK_16M;
    if (HAL_RCCEx_PeriphCLKConfig(&PeriphClkInitStruct) != HAL_OK)
    {
      Error_Handler();
    }

    /* Peripheral clock enable */
    if (__HAL_RCC_RADIO_IS_CLK_DISABLED())
    {
      /* Radio reset */
      __HAL_RCC_RADIO_FORCE_RESET();
      __HAL_RCC_RADIO_RELEASE_RESET();

      /* Enable Radio peripheral clock */
      __HAL_RCC_RADIO_CLK_ENABLE();
    }

    /**RADIO GPIO Configuration
    RF1     ------> RADIO_RF1
    */
    RT_DEBUG_GPIO_Init();

    /* RADIO interrupt Init */
    HAL_NVIC_SetPriority(RADIO_TXRX_IRQn, 0, 0);
    HAL_NVIC_EnableIRQ(RADIO_TXRX_IRQn);
    HAL_NVIC_SetPriority(RADIO_TXRX_SEQ_IRQn, 0, 0);
    HAL_NVIC_EnableIRQ(RADIO_TXRX_SEQ_IRQn);
    HAL_NVIC_SetPriority(RADIO_RRM_IRQn, 0, 0);
    HAL_NVIC_EnableIRQ(RADIO_RRM_IRQn);
  }

}

/**
  * @brief RADIO MSP De-Initialization
  * This function freeze the hardware resources used in this example
  * @param hradio: RADIO handle pointer
  * @retval None
  */
void HAL_RADIO_MspDeInit(RADIO_HandleTypeDef* hradio)
{
  if(hradio->Instance==RADIO)
  {
    /* Peripheral clock disable */
    __HAL_RCC_RADIO_CLK_DISABLE();
    __HAL_RCC_RADIO_FORCE_RESET();
    __HAL_RCC_RADIO_RELEASE_RESET();

    /* RADIO interrupt DeInit */
    HAL_NVIC_DisableIRQ(RADIO_TXRX_IRQn);
    HAL_NVIC_DisableIRQ(RADIO_TXRX_SEQ_IRQn);
    HAL_NVIC_DisableIRQ(RADIO_RRM_IRQn);
  }

}

/**
  * @brief RTC MSP Initialization
  * This function configures the hardware resources used in this example
  * @param hrtc: RTC handle pointer
  * @retval None
  */
void HAL_RTC_MspInit(RTC_HandleTypeDef* hrtc)
{
  RCC_PeriphCLKInitTypeDef PeriphClkInitStruct = {0};
  if(hrtc->Instance==RTC)
  {
  /** Initializes the peripherals clock
  */
    PeriphClkInitStruct.PeriphClockSelection = RCC_PERIPHCLK_RTC_WDG_BLEWKUP;
    PeriphClkInitStruct.RTCWDGBLEWKUPClockSelection = RCC_RTC_WDG_BLEWKUP_CLKSOURCE_LSE;
    if (HAL_RCCEx_PeriphCLKConfig(&PeriphClkInitStruct) != HAL_OK)
    {
      Error_Handler();
    }

    /* Peripheral clock enable */
    __HAL_RCC_RTC_CLK_ENABLE();
  }

}

/**
  * @brief RTC MSP De-Initialization
  * This function freeze the hardware resources used in this example
  * @param hrtc: RTC handle pointer
  * @retval None
  */
void HAL_RTC_MspDeInit(RTC_HandleTypeDef* hrtc)
{
  if(hrtc->Instance==RTC)
  {
    /* Peripheral clock disable */
    __HAL_RCC_RTC_CLK_DISABLE();
  }

}

/**
  * @brief TIM_Base MSP Initialization
  * This function configures the hardware resources used in this example
  * @param htim_base: TIM_Base handle pointer
  * @retval None
  */
void HAL_TIM_Base_MspInit(TIM_HandleTypeDef* htim_base)
{
  GPIO_InitTypeDef GPIO_InitStruct = {0};
  if(htim_base->Instance==TIM2)
  {
    /* Peripheral clock enable */
    __HAL_RCC_TIM2_CLK_ENABLE();

    __HAL_RCC_GPIOB_CLK_ENABLE();
    /**TIM2 GPIO Configuration
    PB1     ------> TIM2_ETR
    */
    GPIO_InitStruct.Pin = GPIO_PIN_1;
    GPIO_InitStruct.Mode = GPIO_MODE_AF_PP;
    GPIO_InitStruct.Pull = GPIO_NOPULL;
    GPIO_InitStruct.Speed = GPIO_SPEED_FREQ_LOW;
    GPIO_InitStruct.Alternate = GPIO_AF3_TIM2;
    HAL_GPIO_Init(GPIOB, &GPIO_InitStruct);

    HAL_PWREx_DisableGPIOPullUp(PWR_GPIO_B, PWR_GPIO_BIT_1);

    HAL_PWREx_DisableGPIOPullDown(PWR_GPIO_B, PWR_GPIO_BIT_1);

  }

}

/**
  * @brief TIM_Base MSP De-Initialization
  * This function freeze the hardware resources used in this example
  * @param htim_base: TIM_Base handle pointer
  * @retval None
  */
void HAL_TIM_Base_MspDeInit(TIM_HandleTypeDef* htim_base)
{
  if(htim_base->Instance==TIM2)
  {
    /* Peripheral clock disable */
    __HAL_RCC_TIM2_CLK_DISABLE();

    /**TIM2 GPIO Configuration
    PB1     ------> TIM2_ETR
    */
    HAL_GPIO_DeInit(GPIOB, GPIO_PIN_1);

  }

}

/**
  * @brief UART MSP Initialization
  * This function configures the hardware resources used in this example
  * @param huart: UART handle pointer
  * @retval None
  */
void HAL_UART_MspInit(UART_HandleTypeDef* huart)
{
  GPIO_InitTypeDef GPIO_InitStruct = {0};
  if(huart->Instance==USART1)
  {
    /* Peripheral clock enable */
    __HAL_RCC_USART1_CLK_ENABLE();

    __HAL_RCC_GPIOA_CLK_ENABLE();
    /**USART1 GPIO Configuration
    PA1     ------> USART1_TX
    PA8     ------> USART1_RX
    */
    GPIO_InitStruct.Pin = GPIO_PIN_1;
    GPIO_InitStruct.Mode = GPIO_MODE_AF_PP;
    GPIO_InitStruct.Pull = GPIO_NOPULL;
    GPIO_InitStruct.Speed = GPIO_SPEED_FREQ_LOW;
    GPIO_InitStruct.Alternate = GPIO_AF2_USART1;
    HAL_GPIO_Init(GPIOA, &GPIO_InitStruct);

    GPIO_InitStruct.Pin = GPIO_PIN_8;
    GPIO_InitStruct.Mode = GPIO_MODE_AF_PP;
    GPIO_InitStruct.Pull = GPIO_NOPULL;
    GPIO_InitStruct.Speed = GPIO_SPEED_FREQ_LOW;
    GPIO_InitStruct.Alternate = GPIO_AF0_USART1;
    HAL_GPIO_Init(GPIOA, &GPIO_InitStruct);

    HAL_PWREx_DisableGPIOPullUp(PWR_GPIO_A, PWR_GPIO_BIT_1|PWR_GPIO_BIT_8);

    HAL_PWREx_DisableGPIOPullDown(PWR_GPIO_A, PWR_GPIO_BIT_1|PWR_GPIO_BIT_8);

    /* USART1 interrupt Init */
    HAL_NVIC_SetPriority(USART1_IRQn, 1, 0);
    HAL_NVIC_EnableIRQ(USART1_IRQn);
  }

}

/**
  * @brief UART MSP De-Initialization
  * This function freeze the hardware resources used in this example
  * @param huart: UART handle pointer
  * @retval None
  */
void HAL_UART_MspDeInit(UART_HandleTypeDef* huart)
{
  if(huart->Instance==USART1)
  {
    /* Peripheral clock disable */
    __HAL_RCC_USART1_CLK_DISABLE();

    /**USART1 GPIO Configuration
    PA1     ------> USART1_TX
    PA8     ------> USART1_RX
    */
    HAL_GPIO_DeInit(GPIOA, GPIO_PIN_1|GPIO_PIN_8);

    /* USART1 interrupt DeInit */
    HAL_NVIC_DisableIRQ(USART1_IRQn);
  }

}

/* USER CODE BEGIN 1 */

/**
  * @brief  Configures the IOs pull resistors to have the optimized power consumption.
  * @param  None
  * @retval None
  */
static void lowPowerIOSetup(void)
{
  
  HAL_PWREx_EnableGPIOPullUp(PWR_GPIO_A, 
                       PWR_GPIO_BIT_0|
                       PWR_GPIO_BIT_1|
                       PWR_GPIO_BIT_2|                         
                       PWR_GPIO_BIT_3);
  
  HAL_PWREx_EnableGPIOPullDown(PWR_GPIO_A, 
                             PWR_GPIO_BIT_8|
                             PWR_GPIO_BIT_9|
                             PWR_GPIO_BIT_10|
                             PWR_GPIO_BIT_11);
  
  HAL_PWREx_EnableGPIOPullDown(PWR_GPIO_B, 
                             PWR_GPIO_BIT_0|
                             PWR_GPIO_BIT_3|
                             PWR_GPIO_BIT_6|
                             PWR_GPIO_BIT_7|
                             PWR_GPIO_BIT_12|
                             PWR_GPIO_BIT_13);
  
  HAL_PWREx_EnableGPIOPullUp(PWR_GPIO_B, 
                       PWR_GPIO_BIT_1|
                       PWR_GPIO_BIT_2|
                       PWR_GPIO_BIT_4|
                       PWR_GPIO_BIT_5|  
                       PWR_GPIO_BIT_14|
                       PWR_GPIO_BIT_15);
}

/* USER CODE END 1 */
