a-conspiracy-theory/jhnvrw-seniordesign/software/WB05/BLE_Beacon/STM32_BLE/App/app_ble.c

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

/* Includes ------------------------------------------------------------------*/
#include <stdio.h>
#include <string.h>
#include "main.h"
#include "stm32wb0x.h"
#include "ble.h"
#include "gatt_profile.h"
#include "gap_profile.h"
#include "app_ble.h"
#include "stm32wb0x_hal_radio_timer.h"
#include "bleplat.h"
#include "nvm_db.h"
#include "blenvm.h"
#include "pka_manager.h"
#include "stm32_seq.h"
/* USER CODE BEGIN Includes */
#include "eddystone_beacon.h"
#include "eddystone_uid_service.h"
#include "eddystone_url_service.h"
#include "eddystone_tlm_service.h"
#include "ibeacon_service.h"
#include "ibeacon.h"
/* USER CODE END Includes */


NO_INIT(uint32_t dyn_alloc_a[BLE_DYN_ALLOC_SIZE>>2]);

/* External variables --------------------------------------------------------*/


/* Functions Definition ------------------------------------------------------*/
void ModulesInit(void)
{
  BLENVM_Init();
  if (PKAMGR_Init() == PKAMGR_ERROR)
  {
    Error_Handler();
  }
}

void BLE_Init(void)
{
  uint8_t role;
  uint8_t privacy_type = 0;
  tBleStatus ret;
  uint16_t gatt_service_changed_handle;
  uint8_t bd_address[6] = {0};
  uint8_t bd_address_len= 6;

  BLE_STACK_InitTypeDef BLE_STACK_InitParams = {
    .BLEStartRamAddress = (uint8_t*)dyn_alloc_a,
    .TotalBufferSize = BLE_DYN_ALLOC_SIZE,
    .NumAttrRecords = CFG_BLE_NUM_GATT_ATTRIBUTES,
    .MaxNumOfClientProcs = CFG_BLE_NUM_OF_CONCURRENT_GATT_CLIENT_PROC,
    .NumOfRadioTasks = CFG_BLE_NUM_RADIO_TASKS,
    .NumOfEATTChannels = CFG_BLE_NUM_EATT_CHANNELS,
    .NumBlockCount = CFG_BLE_MBLOCKS_COUNT,
    .ATT_MTU = CFG_BLE_ATT_MTU_MAX,
    .MaxConnEventLength = CFG_BLE_CONN_EVENT_LENGTH_MAX,
    .SleepClockAccuracy = CFG_BLE_SLEEP_CLOCK_ACCURACY,
    .NumOfAdvDataSet = CFG_BLE_NUM_ADV_SETS,
    .NumOfSubeventsPAwR = CFG_BLE_NUM_PAWR_SUBEVENTS,
    .MaxPAwRSubeventDataCount = CFG_BLE_PAWR_SUBEVENT_DATA_COUNT_MAX,
    .NumOfAuxScanSlots = CFG_BLE_NUM_AUX_SCAN_SLOTS,
    .FilterAcceptListSizeLog2 = CFG_BLE_FILTER_ACCEPT_LIST_SIZE_LOG2,
    .L2CAP_MPS = CFG_BLE_COC_MPS_MAX,
    .L2CAP_NumChannels = CFG_BLE_COC_NBR_MAX,
    .NumOfSyncSlots = CFG_BLE_NUM_SYNC_SLOTS,
    .CTE_MaxNumAntennaIDs = CFG_BLE_NUM_CTE_ANTENNA_IDS_MAX,
    .CTE_MaxNumIQSamples = CFG_BLE_NUM_CTE_IQ_SAMPLES_MAX,
    .NumOfSyncBIG = CFG_BLE_NUM_SYNC_BIG_MAX,
    .NumOfBrcBIG = CFG_BLE_NUM_BRC_BIG_MAX,
    .NumOfSyncBIS = CFG_BLE_NUM_SYNC_BIS_MAX,
    .NumOfBrcBIS = CFG_BLE_NUM_BRC_BIS_MAX,
    .NumOfCIG = CFG_BLE_NUM_CIG_MAX,
    .NumOfCIS = CFG_BLE_NUM_CIS_MAX,
    .ExtraLLProcedureContexts = CFG_BLE_EXTRA_LL_PROCEDURE_CONTEXTS,
    .isr0_fifo_size = CFG_BLE_ISR0_FIFO_SIZE,
    .isr1_fifo_size = CFG_BLE_ISR1_FIFO_SIZE,
    .user_fifo_size = CFG_BLE_USER_FIFO_SIZE
  };

  /* Bluetooth LE stack init */
  ret = BLE_STACK_Init(&BLE_STACK_InitParams);
  if (ret != BLE_STATUS_SUCCESS) {
    APP_DBG_MSG("Error in BLE_STACK_Init() 0x%02x\r\n", ret);
    Error_Handler();
  }

#if (CFG_BD_ADDRESS_TYPE == HCI_ADDR_PUBLIC)

  bd_address[0] = (uint8_t)((CFG_PUBLIC_BD_ADDRESS & 0x0000000000FF));
  bd_address[1] = (uint8_t)((CFG_PUBLIC_BD_ADDRESS & 0x00000000FF00) >> 8);
  bd_address[2] = (uint8_t)((CFG_PUBLIC_BD_ADDRESS & 0x000000FF0000) >> 16);
  bd_address[3] = (uint8_t)((CFG_PUBLIC_BD_ADDRESS & 0x0000FF000000) >> 24);
  bd_address[4] = (uint8_t)((CFG_PUBLIC_BD_ADDRESS & 0x00FF00000000) >> 32);
  bd_address[5] = (uint8_t)((CFG_PUBLIC_BD_ADDRESS & 0xFF0000000000) >> 40);
  (void)bd_address_len;

  ret = aci_hal_write_config_data(CONFIG_DATA_PUBADDR_OFFSET, CONFIG_DATA_PUBADDR_LEN, bd_address);
  if (ret != BLE_STATUS_SUCCESS)
  {
    APP_DBG_MSG("  Fail   : aci_hal_write_config_data command - CONFIG_DATA_PUBADDR_OFFSET, result: 0x%02X\n", ret);
  }
  else
  {
    APP_DBG_MSG("  Success: aci_hal_write_config_data command - CONFIG_DATA_PUBADDR_OFFSET\n");
  }
#endif

  /**
   * Set TX Power.
   */
  ret = aci_hal_set_tx_power_level(CFG_TX_POWER_MODE, CFG_TX_POWER);
  if (ret != BLE_STATUS_SUCCESS)
  {
    APP_DBG_MSG("  Fail   : aci_hal_set_tx_power_level command, result: 0x%02X\n", ret);
  }
  else
  {
    APP_DBG_MSG("  Success: aci_hal_set_tx_power_level command\n");
  }

  /**
   * Initialize GATT interface
   */
  ret = aci_gatt_srv_profile_init(GATT_INIT_SERVICE_CHANGED_BIT, &gatt_service_changed_handle);
  if (ret != BLE_STATUS_SUCCESS)
  {
    APP_DBG_MSG("  Fail   : aci_gatt_srv_profile_init command, result: 0x%02X\n", ret);
  }
  else
  {
    APP_DBG_MSG("  Success: aci_gatt_srv_profile_init command\n");
  }

  /**
   * Initialize GAP interface
   */
  role = 0U;
  role |= GAP_PERIPHERAL_ROLE;

#if CFG_BLE_PRIVACY_ENABLED
  privacy_type = 0x02;
#endif

/* USER CODE BEGIN Role_Mngt*/

/* USER CODE END Role_Mngt */

  ret = aci_gap_init(privacy_type, CFG_BD_ADDRESS_TYPE);
  if (ret != BLE_STATUS_SUCCESS)
  {
    APP_DBG_MSG("  Fail   : aci_gap_init command, result: 0x%02X\n", ret);
  }
  else
  {
    APP_DBG_MSG("  Success: aci_gap_init command\n");
  }

#if (CFG_BD_ADDRESS_TYPE == HCI_ADDR_STATIC_RANDOM_ADDR)
  ret = aci_hal_read_config_data(CONFIG_DATA_STORED_STATIC_RANDOM_ADDRESS,
                                 &bd_address_len, bd_address);
  APP_DBG_MSG("  Static Random Bluetooth Address: %02x:%02x:%02x:%02x:%02x:%02x\n",bd_address[5],bd_address[4],bd_address[3],bd_address[2],bd_address[1],bd_address[0]);
#elif (CFG_BD_ADDRESS_TYPE == HCI_ADDR_PUBLIC)
  APP_DBG_MSG("  Public Bluetooth Address: %02x:%02x:%02x:%02x:%02x:%02x\n",bd_address[5],bd_address[4],bd_address[3],bd_address[2],bd_address[1],bd_address[0]);
#else
#error "Invalid CFG_BD_ADDRESS_TYPE"
#endif

  APP_DBG_MSG("BLE stack initialized\r\n");

}

void BLEStack_Process_Schedule(void)
{
  /* Keep BLE Stack Process priority low, since there are limited cases
     where stack wants to be rescheduled for busy waiting.  */
  UTIL_SEQ_SetTask( 1U << CFG_TASK_BLE_STACK, CFG_SEQ_PRIO_1);
}
static void BLEStack_Process(void)
{
  APP_DEBUG_SIGNAL_SET(APP_STACK_PROCESS);
  BLE_STACK_Tick();

  APP_DEBUG_SIGNAL_RESET(APP_STACK_PROCESS);
}

void VTimer_Process(void)
{
  HAL_RADIO_TIMER_Tick();
}

void VTimer_Process_Schedule(void)
{
  UTIL_SEQ_SetTask( 1U << CFG_TASK_VTIMER, CFG_SEQ_PRIO_0);
}
void NVM_Process(void)
{
  NVMDB_Tick();
}

void NVM_Process_Schedule(void)
{
  UTIL_SEQ_SetTask( 1U << CFG_TASK_NVM, CFG_SEQ_PRIO_1);
}

/* Function called from RADIO_TIMER_TXRX_WKUP_IRQHandler() context. */
void HAL_RADIO_TIMER_TxRxWakeUpCallback(void)
{
  VTimer_Process_Schedule();
}

/* Function called from RADIO_TIMER_CPU_WKUP_IRQHandler() context. */
void HAL_RADIO_TIMER_CpuWakeUpCallback(void)
{
  VTimer_Process_Schedule();
}

/* Function called from RADIO_TXRX_IRQHandler() context. */
void HAL_RADIO_TxRxCallback(uint32_t flags)
{
  BLE_STACK_RadioHandler(flags);

  VTimer_Process_Schedule();
  NVM_Process_Schedule();

}

/* Function called from RADIO_RRM_IRQHandler() context. */
void HAL_RADIO_RRMCallback(uint32_t ble_irq_status)
{
  BLE_STACK_RRMHandler(ble_irq_status);
}

void BLE_STACK_ProcessRequest(void)
{
  BLEStack_Process_Schedule();
}

/* Functions Definition ------------------------------------------------------*/
void APP_BLE_Init(void)
{
  UTIL_SEQ_RegTask(1U << CFG_TASK_BLE_STACK, UTIL_SEQ_RFU, BLEStack_Process);
  UTIL_SEQ_RegTask(1U << CFG_TASK_VTIMER, UTIL_SEQ_RFU, VTimer_Process);
  UTIL_SEQ_RegTask(1U << CFG_TASK_NVM, UTIL_SEQ_RFU, NVM_Process);
  ModulesInit();

  /* Initialization of HCI & GATT & GAP layer */
  BLE_Init();

/* USER CODE BEGIN APP_BLE_Init_2 */
  
  /* Make the device discoverable  */
  if (CFG_BEACON_TYPE & CFG_EDDYSTONE_UID_BEACON_TYPE)
  {
    APP_DBG_MSG("Eddystone UID beacon advertise\n\r");
    EddystoneUID_Process();
  }
  else if (CFG_BEACON_TYPE & CFG_EDDYSTONE_URL_BEACON_TYPE)
  {
    APP_DBG_MSG("Eddystone URL beacon advertise\n\r");
    EddystoneURL_Process();
  }
  else if (CFG_BEACON_TYPE & CFG_EDDYSTONE_TLM_BEACON_TYPE)
  {
    APP_DBG_MSG("Eddystone TLM beacon advertise\n\r");
    //EddystoneTLM_Process(1.0, 1.0);
  }
  else if (CFG_BEACON_TYPE & CFG_IBEACON)
  {
    APP_DBG_MSG("Ibeacon advertise\n\r");
    IBeacon_Process();
  }
  
/* USER CODE END APP_BLE_Init_2 */
  return;
}

void BLEEVT_App_Notification(const hci_pckt *hci_pckt)
{

}

/* Event used to notify the Host that a hardware failure has occurred in the Controller.
   See ble_events.h. */
void hci_hardware_error_event(uint8_t Hardware_Code)
{
  if (Hardware_Code <= 0x03)
  {
    NVIC_SystemReset();
  }
}

/** \endcond
 */
