a-conspiracy-theory/jhnvrw-seniordesign/software/WB55/BLE_p2pClient/STM32_WPAN/App/app_ble.h

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

/* Define to prevent recursive inclusion -------------------------------------*/
#ifndef APP_BLE_H
#define APP_BLE_H

#ifdef __cplusplus
extern "C" {
#endif

/* Includes ------------------------------------------------------------------*/
#include "hci_tl.h"

/* Exported types ------------------------------------------------------------*/

typedef enum
{
  APP_BLE_IDLE,
  APP_BLE_FAST_ADV,
  APP_BLE_LP_ADV,
  APP_BLE_SCAN,
  APP_BLE_LP_CONNECTING,
  APP_BLE_CONNECTED_SERVER,
  APP_BLE_CONNECTED_CLIENT,

  APP_BLE_DISCOVER_SERVICES,
  APP_BLE_DISCOVER_CHARACS,
  APP_BLE_DISCOVER_WRITE_DESC,
  APP_BLE_DISCOVER_NOTIFICATION_CHAR_DESC,
  APP_BLE_ENABLE_NOTIFICATION_DESC,
  APP_BLE_DISABLE_NOTIFICATION_DESC
} APP_BLE_ConnStatus_t;

/* USER CODE BEGIN ET */
typedef struct
{
    uint8_t  valid;
    uint8_t  version;
    uint16_t battery_mv;
    int16_t  temperature_raw;
    uint32_t adv_count;
    uint32_t time_since_boot;

} Eddystone_TLM_Data_t;
/* USER CODE END ET */

/* Exported constants --------------------------------------------------------*/
/* External variables --------------------------------------------------------*/
/* Exported macro ------------------------------------------------------------*/
/* Exported functions ---------------------------------------------*/
void APP_BLE_Init(void);
APP_BLE_ConnStatus_t APP_BLE_Get_Client_Connection_Status(uint16_t Connection_Handle);

/* USER CODE BEGIN EF */
void APP_BLE_Key_Button1_Action(void);
void APP_BLE_Key_Button2_Action(void);
void APP_BLE_Key_Button3_Action(void);
void APP_BLE_Get_Eddystone_TLM(Eddystone_TLM_Data_t *data);
/* USER CODE END EF */

#ifdef __cplusplus
}
#endif

#endif /*APP_BLE_H */
