a-conspiracy-theory/jhnvrw-seniordesign/(commit log)

2026-05-26 initial commit. created base rx-pcb kicad file
    [rx-pcb.kicad_pcb, rx-pcb.kicad_sch]
2026-05-26 folder restructuring
    [rx-pcb.kicad_pcb, rx-pcb.kicad_sch]
2026-05-26 added base tx-pcb kicad project
    [tx-pcb.kicad_pcb, tx-pcb.kicad_sch]
2026-05-30 RF work start
    [rx-pcb.kicad_sch, untitled.kicad_sch]
2026-06-01 minor board updates. added the MLPF-WB chip for stm impedance matching
    [rf.kicad_sch, rx-pcb.kicad_pcb, rx-pcb.kicad_sch]
2026-06-02 finished initial board. no sensors or power harvesting, but its programmable and bluetooth should work.
    [pwr.kicad_sch, rf.kicad_sch, rx-pcb.kicad_pcb, rx-pcb.kicad_sch]
2026-06-06 updated bluetooth section to be in-line with filter datasheet. rearranged LFEX to allow I2C connection.
    [rf.kicad_sch, rx-pcb.kicad_pcb, rx-pcb.kicad_sch]
2026-06-09 finished V1 of receiver PCB. No power electronics yet.
    [BOM-rx-pcb.csv, pwr.kicad_sch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]
2026-06-17 separated bluetooth and harvesting boards
    [BOM-rx-pcb.csv, pwr.kicad_sch, rf.kicad_sch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]
2026-06-17 fixed deletion of some files in the GIT
    [BOM-rx-pcb.csv, pwr.kicad_sch, rectifier_impedance_conversion.sch, rf.kicad_sch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]
2026-06-17 began the power harvesting board
    [power_harvester.kicad_pcb, power_harvester.kicad_sch]
2026-06-23 WIP TX Board
    [Power.kicad_sch, tx-pcb.kicad_sch]
2026-06-23 fixed pwr header silkscreen mismatch. added reverse bias protection diode. added power good indicator diode for testing (DNP on final iteration)
    [rx-pcb.kicad_pcb, rx-pcb.kicad_sch]
2026-06-26 began work on RF daughter board; included TI Reference designs
    [CC1101-CC1190EM_915MHz_PARTLIST_1_2_0.xls, CC1101EM_868_915MHz_3_0_0.pcb, CC1101EM_868_915MHz_PARTLIST_3_0_0.xls, CC1101_CC1190EM_915MHz_1_2_0.pcb, CN0522 Allegro Layout File.brd, CN0522 BOM.csv, TI_REF_CC1101_with_CC1190.kicad_pcb, TI_REF_CC1101_with_CC1190.kicad_sch]
2026-07-01 updated energy harvesting IC. Configured it based on the datasheet for this application. Waiting on capacitor bank decision.
    [power_harvester.kicad_sch]
2026-07-12 added selected diodes and bank capacitor. began board layout.
    [power_harvester.kicad_pcb, power_harvester.kicad_sch, rx-pcb.kicad_sch]
2026-07-16 updated harvester PCB with reverse voltage suppression diodes.
    [power_harvester.kicad_pcb, power_harvester.kicad_sch]
2026-07-17 updated harvester with compartmentalization testing resistors and test points. updated bluetooth test to use a low Vf diode rather than an LED for reverse current protection. must update footprint fo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
    [power_harvester.kicad_pcb, power_harvester.kicad_sch, rx-pcb.kicad_sch]
2026-07-18 sx1262 TXRX board, follows Semtech's own dev board schematic
    [sx1262.kicad_pcb, sx1262.kicad_sch, tx-pcb.kicad_sch]
2026-07-21 minor updates
    updated footprints, added some indicator LEDs, created a project library so we dont need to match easyeda libraries
    [tx-pcb.kicad_sch]
2026-07-21 updated footprint library
    [tx-pcb.kicad_sch]
2026-07-21 added footprints, completed schematics but still need V reg
    [sx1262.kicad_sch, tx-pcb.kicad_sch]
2026-07-21 began layout
    began layout, updated schematic USB and input switches
    [tx-pcb.kicad_pcb, tx-pcb.kicad_sch]
2026-07-21 OLED/Bluetooth Transmit of internal temp sensor
2026-07-21 progressed on hardware design
    progressed on hardware design. completed most of the layout. waiting for pitch of the sx1262 and decision on switching regulator.
    [tx-pcb.kicad_pcb]
2026-07-23 fixed merge errors, re updated rx-pcb
    [rx-pcb.kicad_pcb, rx-pcb.kicad_sch]
2026-07-23 simulation and cleaning
    actually simulated my stupid 5k impedance match idea, it sucked because my rectifier is a 400 ohm impedance to ground. cleaning up the github.
    [power_harvester.kicad_sch]
2026-07-23 power harvester updates and cleanup
    [power_harvester.kicad_pcb, power_harvester.kicad_sch]
2026-07-24 worked on transmitter layout
    updated transmitter schematic to use the sx1262 dev board over the chip
    [tx-pcb.kicad_pcb, tx-pcb.kicad_sch]
2026-07-25 finished tx layout v1.0
    [tx-pcb.kicad_pcb, tx-pcb.kicad_sch]
2026-07-26 update for documentation
    [power_harvester.kicad_pcb, rx-pcb.kicad_pcb, tx-pcb.kicad_pcb]
2026-07-26 fixed capacitance issue on harvester board
    [power_harvester.kicad_pcb]
2026-07-27 backup of sensor-bluetooth board. re-wiring it.
    [rx-pcb.kicad_pcb, rx-pcb.kicad_sch]
2026-07-27 updated rx-board with compartmentalization resistors, updated silkscreen
    [rx-pcb.kicad_pcb, rx-pcb.kicad_sch]
2026-07-27 updated power switch for tx board
    [tx-pcb.kicad_pcb, tx-pcb.kicad_sch]
2026-07-27 harvester updates
    [power_harvester.kicad_pcb, power_harvester.kicad_sch]
2026-08-07 double checked for purchase
    updated TX SPI_CLK pin, was incorrect
    [power_harvester.kicad_pcb, tx-pcb.kicad_pcb, tx-pcb.kicad_sch]
2026-08-07 updates immediately pre JLC
    [rx-pcb.kicad_pcb, tx-pcb.kicad_pcb]
2026-09-04 made peripheral board for sx1262 module and arranged component layout for pcb
    [sx1262.kicad_pcb, sx1262.kicad_sch]
2026-09-04 replaced TCXO with a normal 32mhz XTAL
    [sx1262.kicad_pcb, sx1262.kicad_sch]
2026-09-04 finished sx1262 receiver PCB design
    [sx1262.kicad_pcb, sx1262.kicad_sch]
2026-09-14 updates for dr weeks
    [power_harvester.kicad_pcb, power_harvester.kicad_sch, reg-pcb.kicad_pcb, reg-pcb.kicad_sch, rx-pcb.kicad_pcb, rx-pcb.kicad_sch, tx-pcb.kicad_pcb, tx-pcb.kicad_sch]
2026-09-19 updated PCB for weeks purchase
    [power_harvester.kicad_pcb, power_harvester.kicad_sch, rx-pcb.kicad_pcb, rx-pcb.kicad_sch, tx-pcb.kicad_pcb]
2026-09-19 made board for lm2576
    [v-reg.kicad_pcb, v-reg.kicad_sch]
2026-09-28 Sensor Board Code
2026-09-29 minor harvester updates
    [power_harvester.kicad_pcb, power_harvester.kicad_sch]
2026-10-09 updated bluetooth output for MLPF chip and fixed ground layer issue
2026-10-09 added UART to PCB, cleaned up wiring
2026-10-09 double checked silkscreen labels, fixed incorrect, QOL labeling
2026-10-15 updated power harvester hardware program
2026-10-21 got i2c and spi working on the TX PCB; sx1262 still outputs low power
2026-10-21 added verbose error handling to sx1262_driver/board_sx1262_calls.c
2026-10-22 adapter board for the 30dbm sx1262
2026-10-22 sx1262 fix
    figured out what settings work for sx1262 power transmission
2026-10-23 followed phil and got working BLE project in WB55/PCB_SW/BLE_Playground
2026-11-06 added FHSS support, see software/wb55/pcb_sw/fhss_dev
2026-11-06 NEW OLED DRIVERS
2026-11-11 Final Sensor Code
