a-conspiracy-theory/jhnvrw-seniordesign/(notices)

Notices in the files:
software/WB55/BLE_p2pClient/Core/Src/main.c:
Copyright (c) 2019-2021 STMicroelectronics.
All rights reserved.
This software is licensed under terms that can be found in the LICENSE file
software/WB55/BLE_p2pClient/Core/Inc/app_conf.h:
Copyright (c) 2020-2021 STMicroelectronics.
software/WB05/BLE_Beacon/STM32_BLE/App/app_ble.c:
Copyright (c) 2024 STMicroelectronics.
software/WB05/BLE_Sensors/Core/Inc/app_conf.h:
Copyright (c) 2026 STMicroelectronics.
